477-vrms/vrm-website/Files/img/wen101/week12/build-fail.jpg

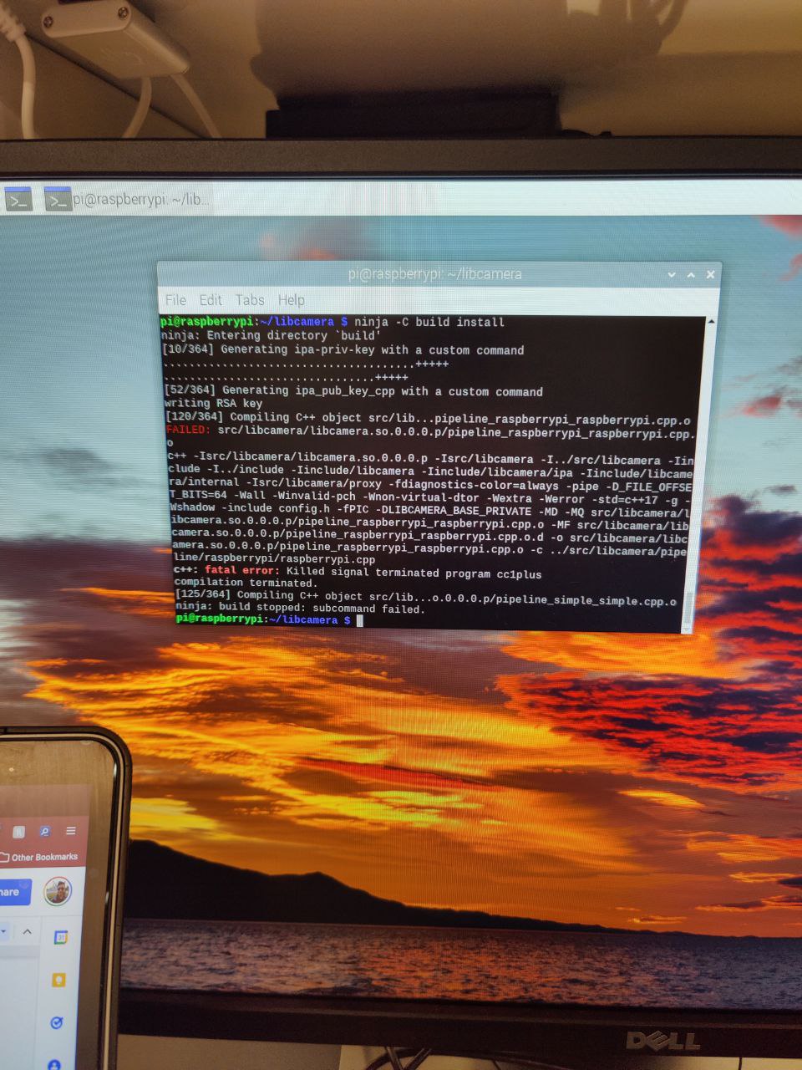
Files/img/wen101/week12/build-fail.jpg
