477-vrms/vrm-website/Files/img/progress1/week2/lazysusaninstall.jpg

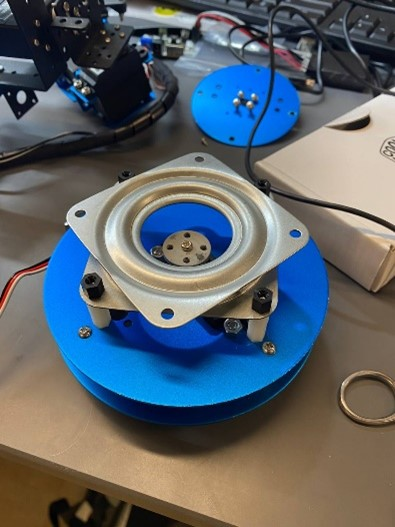
Files/img/progress1/week2/lazysusaninstall.jpg
