477-vrms/vrm-website/Files/img/blatimer/week3/ClawAnimation.gif

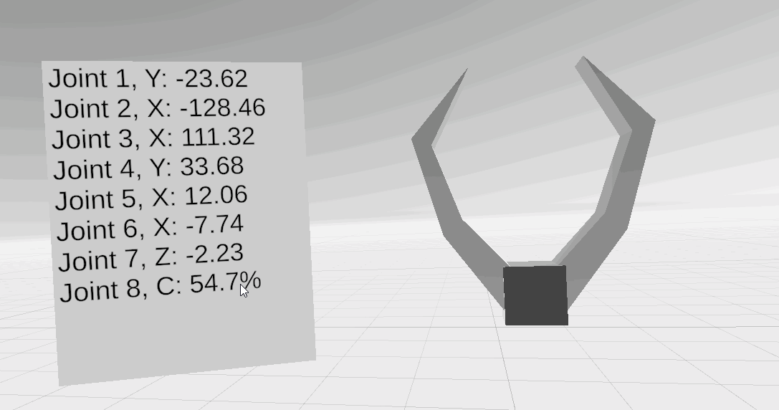
Files/img/blatimer/week3/ClawAnimation.gif
