477-vrms/vrm-website/Files/img/blatimer/week4/Demo.png

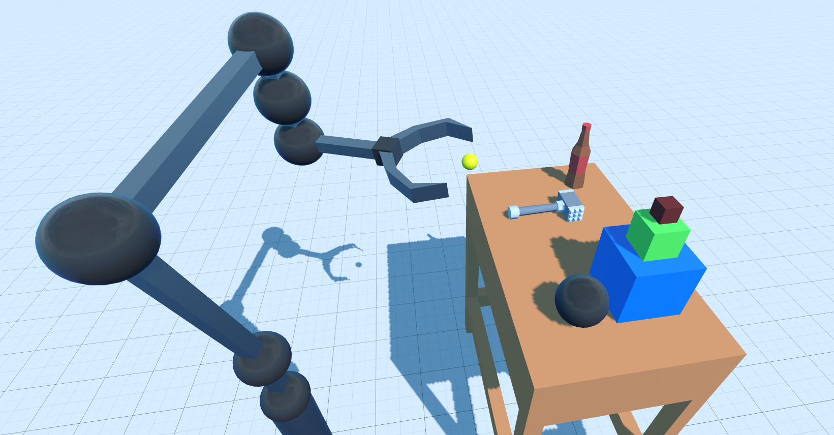
Files/img/blatimer/week4/Demo.png
