477-vrms/vrm-website/Files/img/blatimer/week5/no4thjoint.jpg

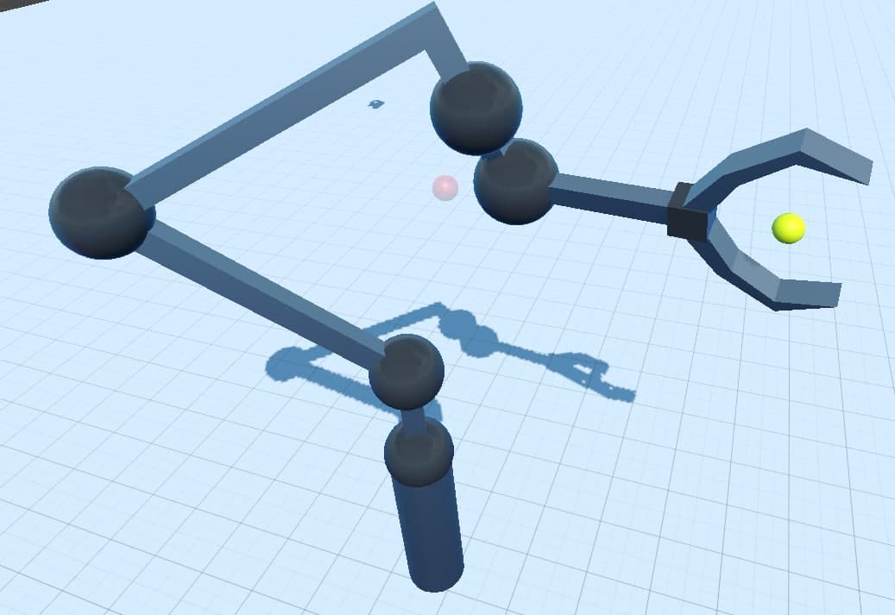
Files/img/blatimer/week5/no4thjoint.jpg
