477-vrms/vrm-website/Files/img/blatimer/week6/auto.gif

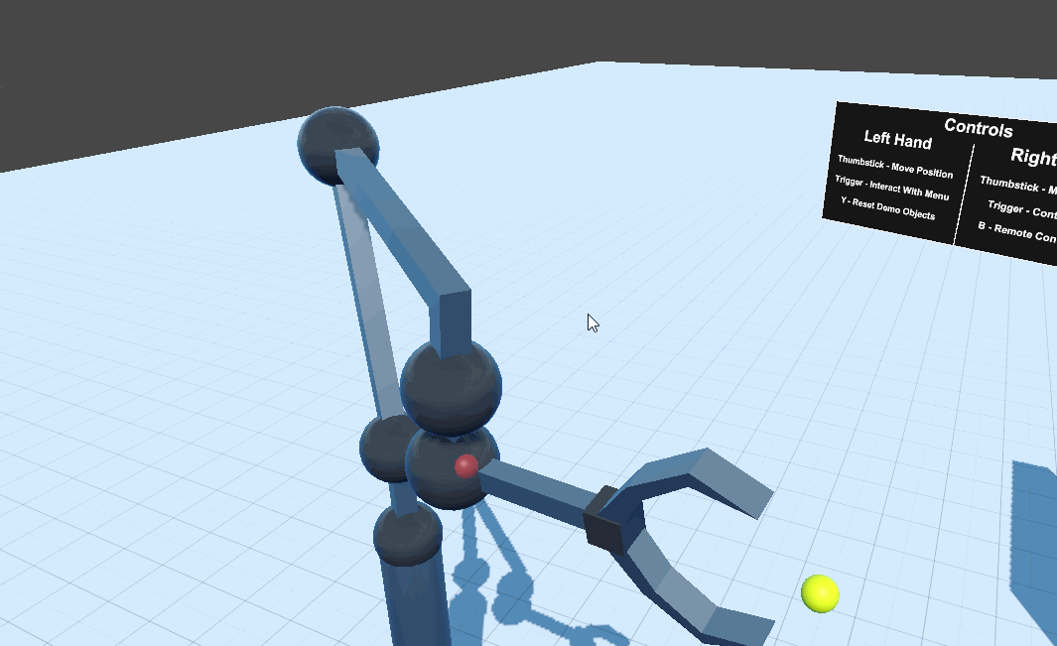
Files/img/blatimer/week6/auto.gif
