477-vrms/vrm-website/Files/img/blatimer/week6/menu.png

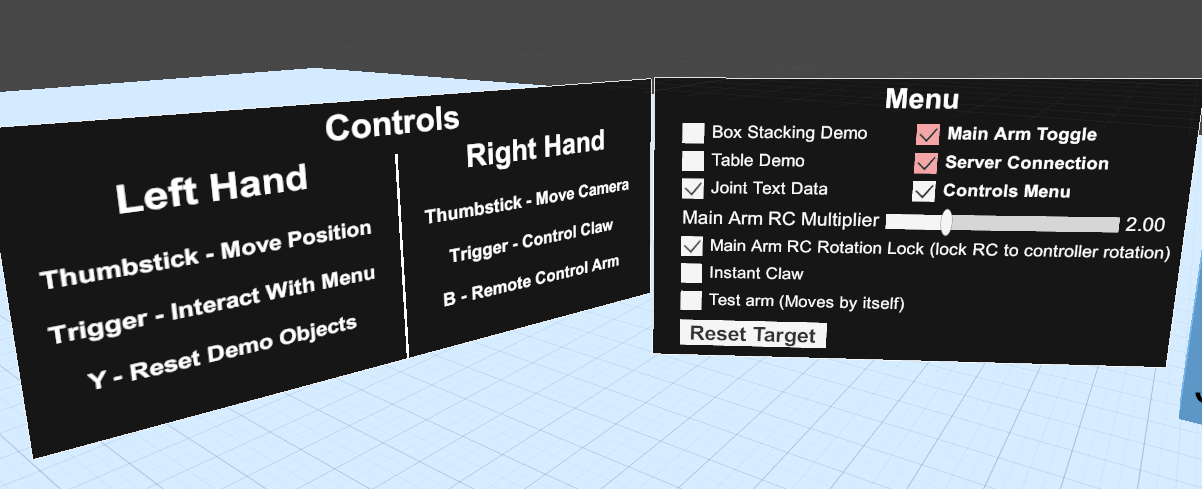
Files/img/blatimer/week6/menu.png
