477-vrms/vrm-website/Files/img/blatimer/week6/Vrm.png

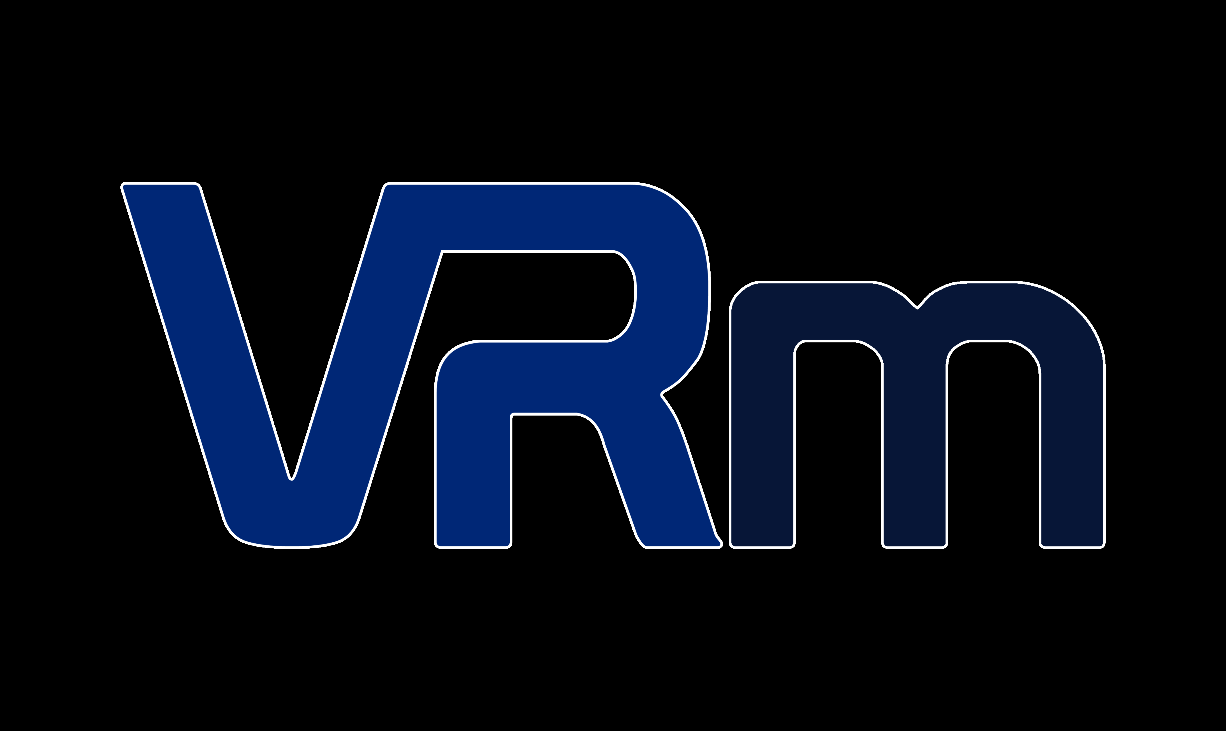
Files/img/blatimer/week6/Vrm.png
