477-vrms/vrm-website/Files/img/blatimer/week7/LimitMenu.png

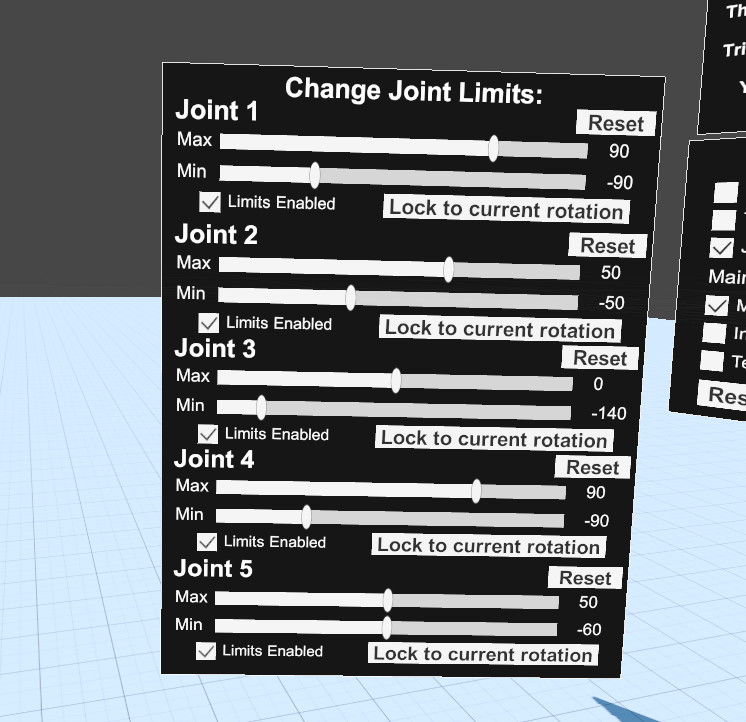
Files/img/blatimer/week7/LimitMenu.png
