477-vrms/vrm-website/Files/img/blatimer/week11/calib.jpg

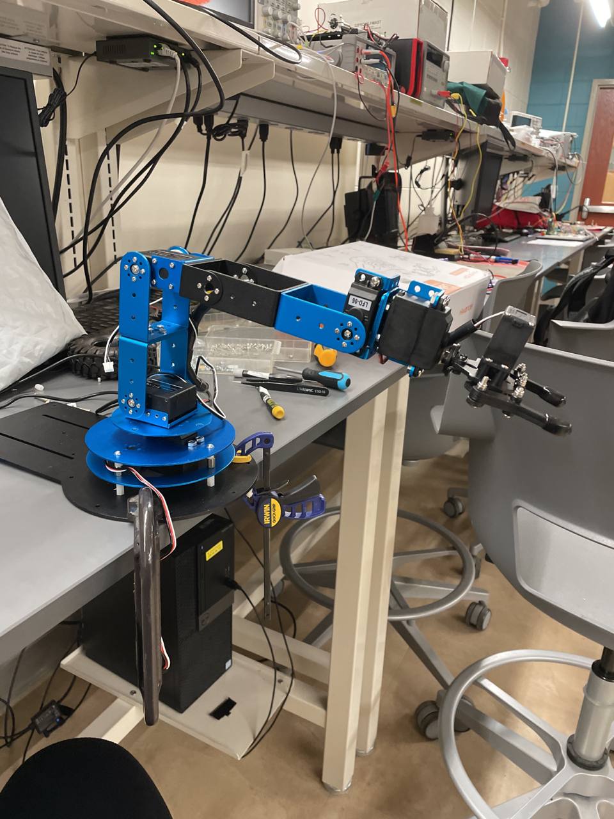
Files/img/blatimer/week11/calib.jpg
