477-vrms/vrm-website/Files/img/blatimer/week11/diagram.jpg

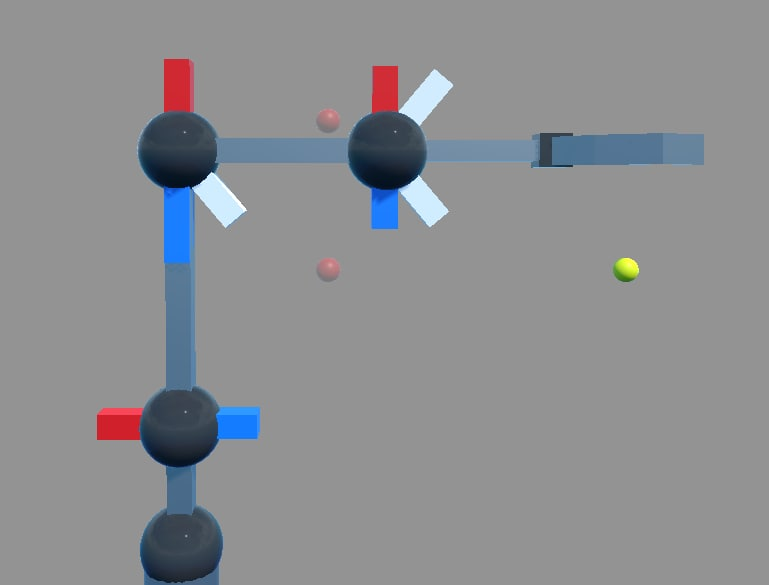
Files/img/blatimer/week11/diagram.jpg
