477-vrms/vrm-website/Files/img/blatimer/week12/bearing.png

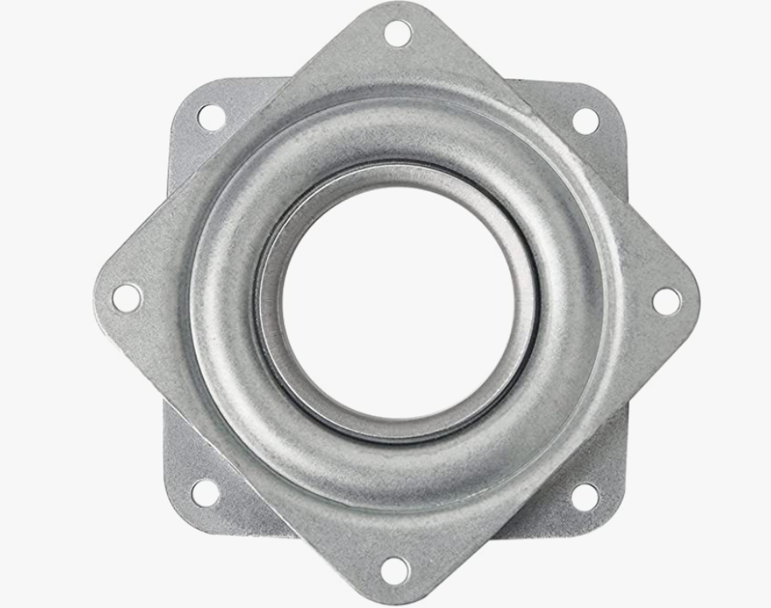
Files/img/blatimer/week12/bearing.png
