477-vrms/vrm-website/Files/img/blatimer/week13/delay.png

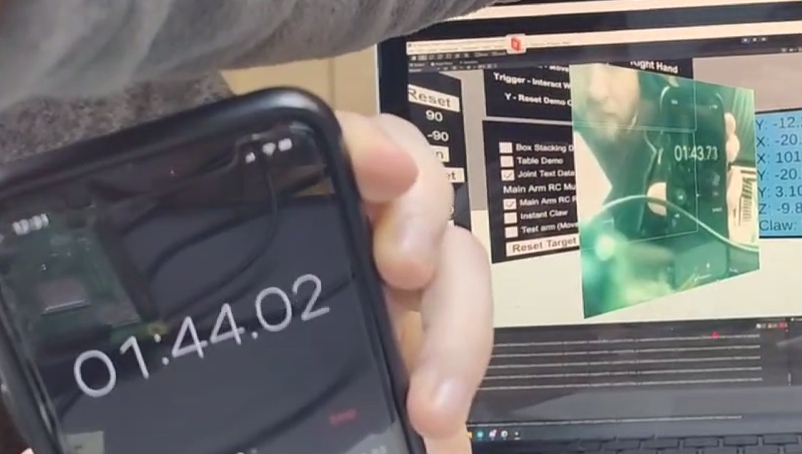
Files/img/blatimer/week13/delay.png
