477-vrms/vrm-website/Files/img/blatimer/week14/NewDimensions.png

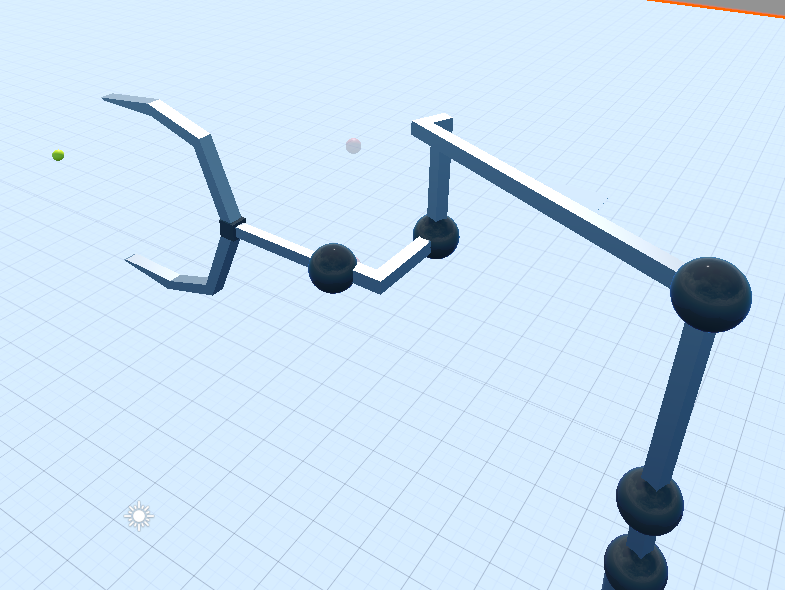
Files/img/blatimer/week14/NewDimensions.png
