477-vrms/vrm-website/Files/img/blatimer/week14/neww.png

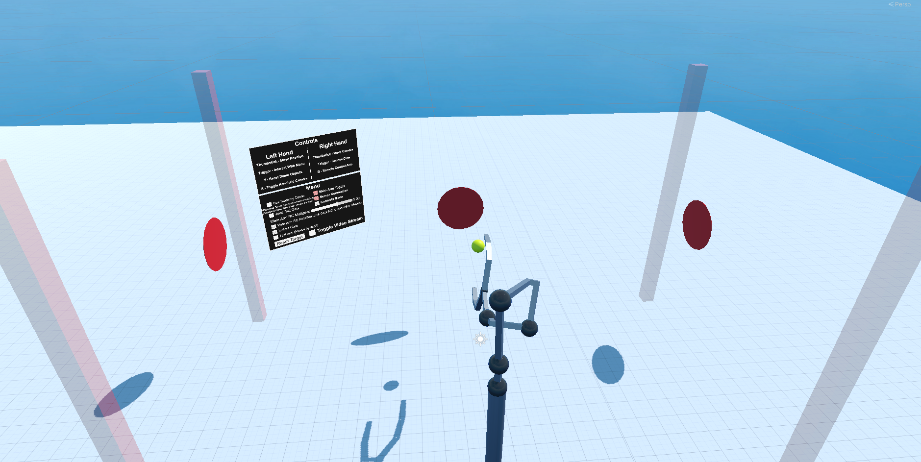
Files/img/blatimer/week14/neww.png
