477-vrms/vrm-website/Files/img/donnell9/week2/SystemDiagram1.png

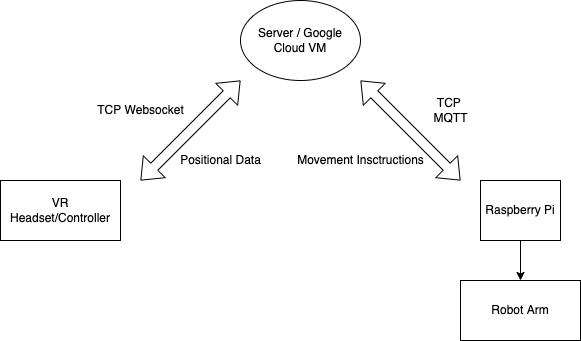
Files/img/donnell9/week2/SystemDiagram1.png
