477-vrms/vrm-website/Files/img/donnell9/week5/pcb.png

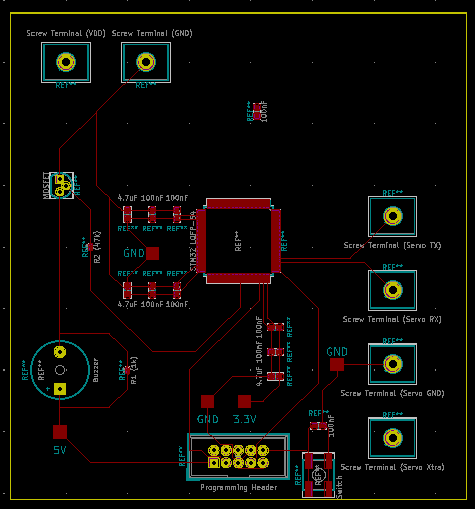
Files/img/donnell9/week5/pcb.png
