477-vrms/vrm-website/Files/img/donnell9/week6/pcb.png

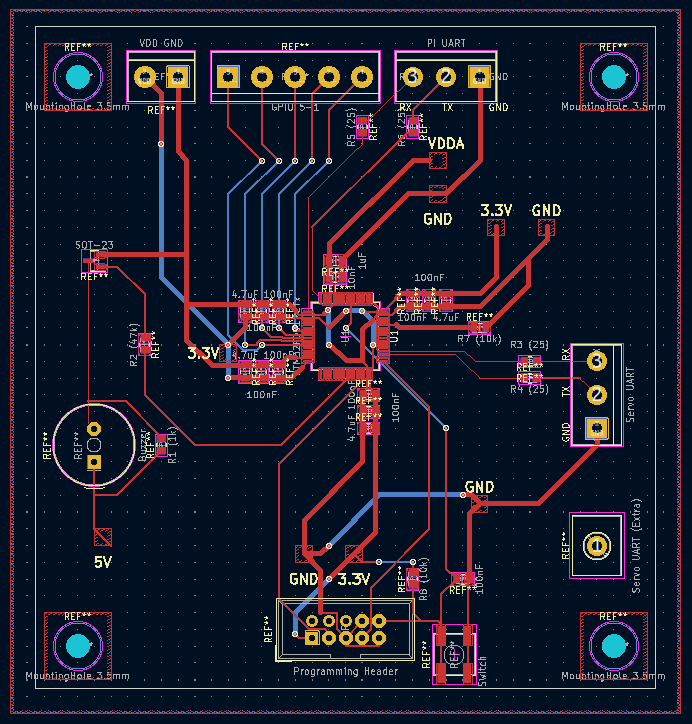
Files/img/donnell9/week6/pcb.png
