477-vrms/vrm-website/Files/img/donnell9/week8/Olivia.jpg

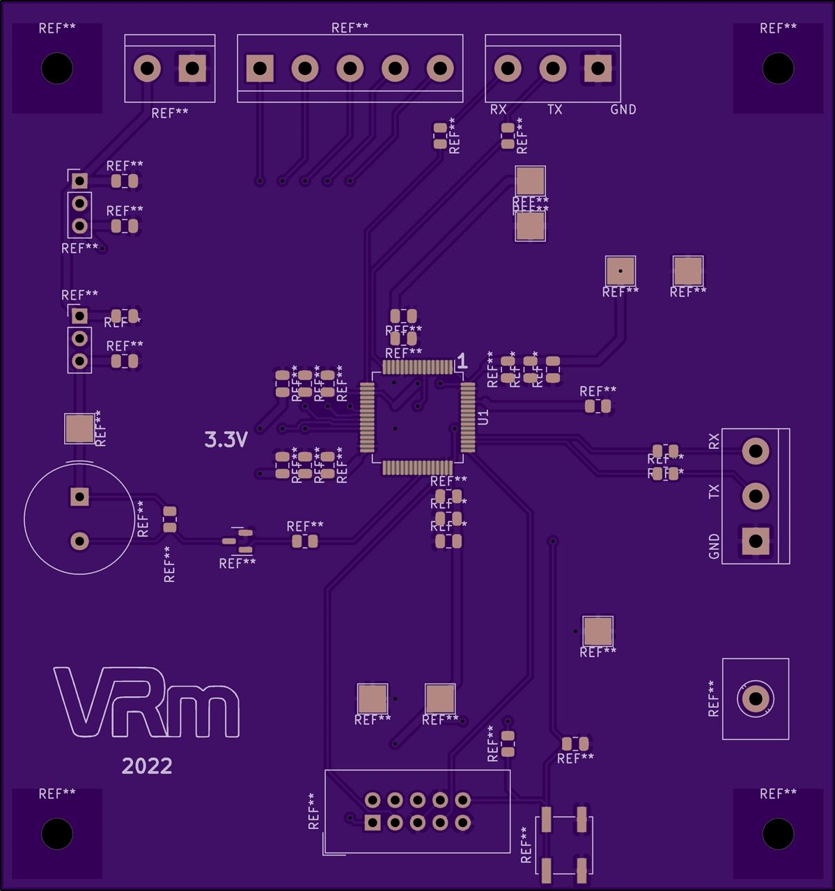
Files/img/donnell9/week8/Olivia.jpg
