477-vrms/vrm-website/Files/img/progress1/week2/arduino2.jpg

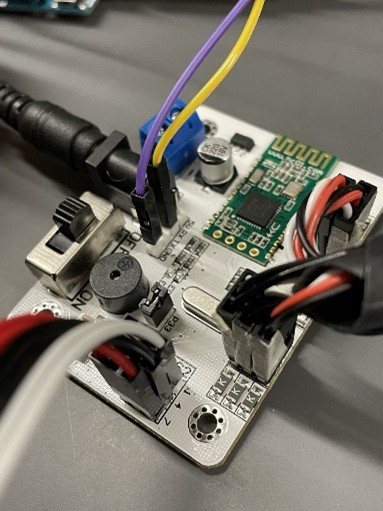
Files/img/progress1/week2/arduino2.jpg
