477-vrms/vrm-website/Files/img/progress1/week2/arudion1.jpg

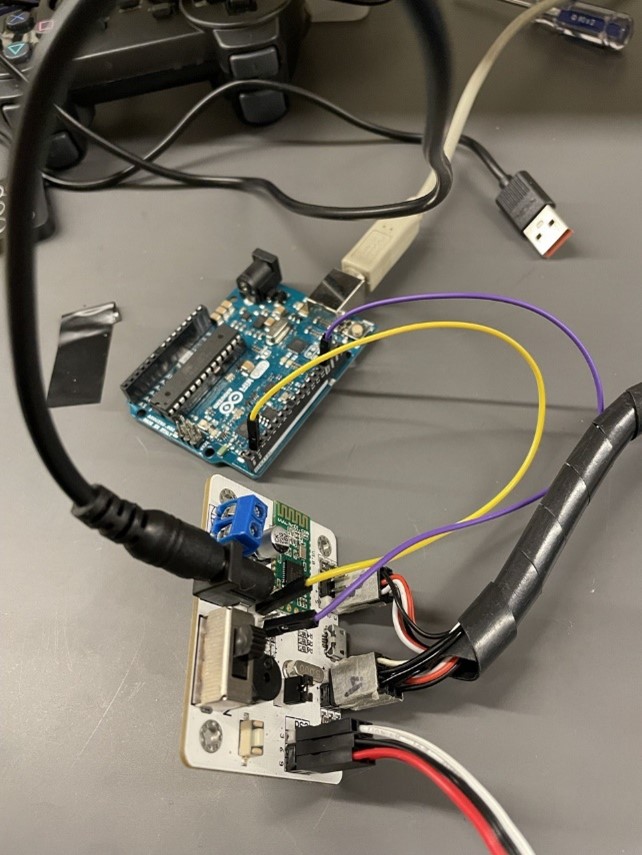
Files/img/progress1/week2/arudion1.jpg
