477-vrms/vrm-website/Files/img/progress1/week2/ballbearing.png

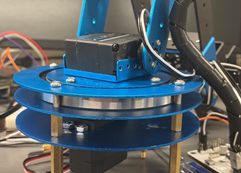
Files/img/progress1/week2/ballbearing.png
