477-vrms/vrm-website/Files/img/progress1/week2/bufferpic.png

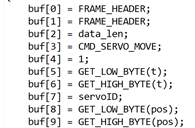
Files/img/progress1/week2/bufferpic.png
