477-vrms/vrm-website/Files/img/progress1/week2/buzz.png

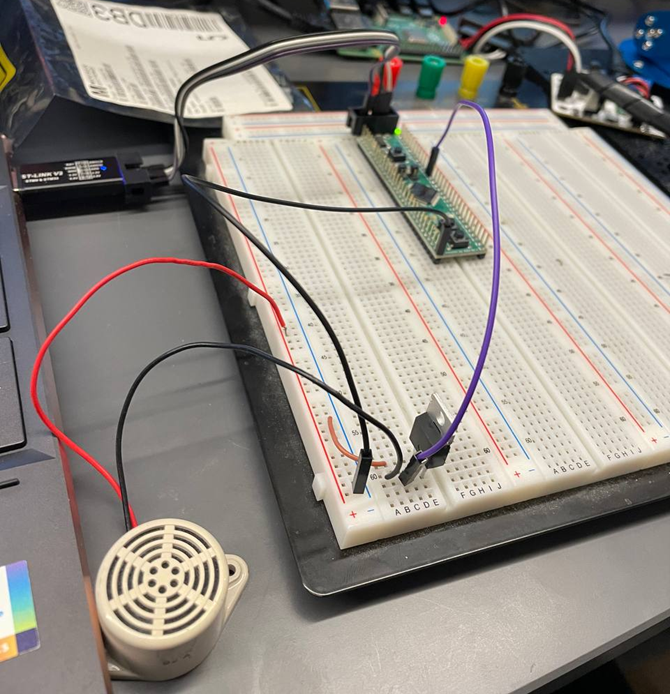
Files/img/progress1/week2/buzz.png
