477-vrms/vrm-website/Files/img/progress1/week2/buzzcircuit.jpg

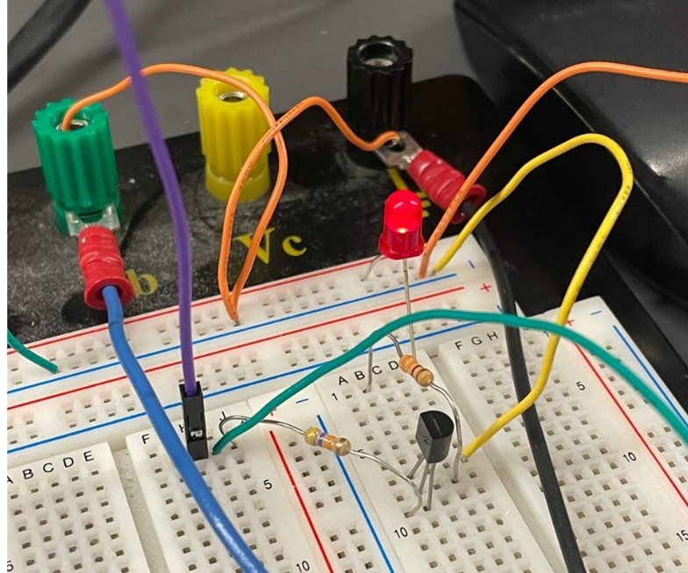
Files/img/progress1/week2/buzzcircuit.jpg
