477-vrms/vrm-website/Files/img/progress1/week2/buzzpower.jpg

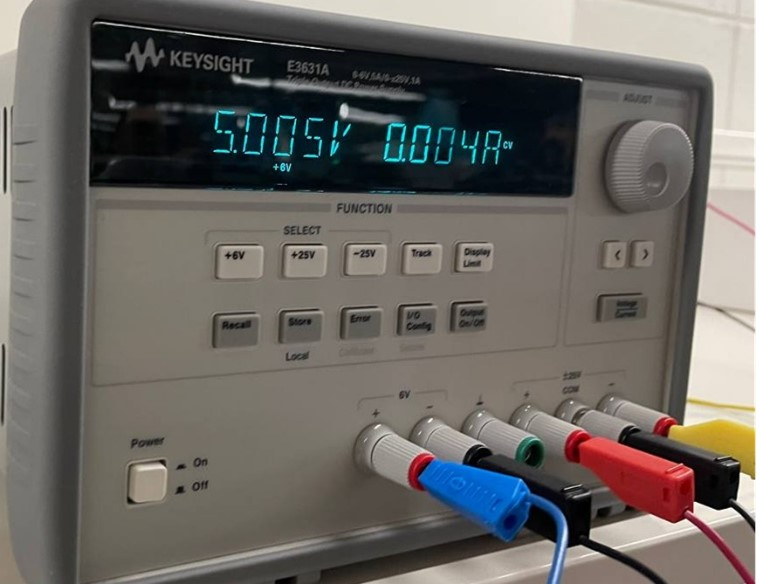
Files/img/progress1/week2/buzzpower.jpg
