477-vrms/vrm-website/Files/img/progress1/week2/camerajpg.jpg

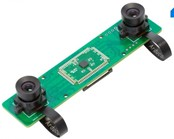
Files/img/progress1/week2/camerajpg.jpg
