477-vrms/vrm-website/Files/img/progress1/week2/circuitdiagram.png

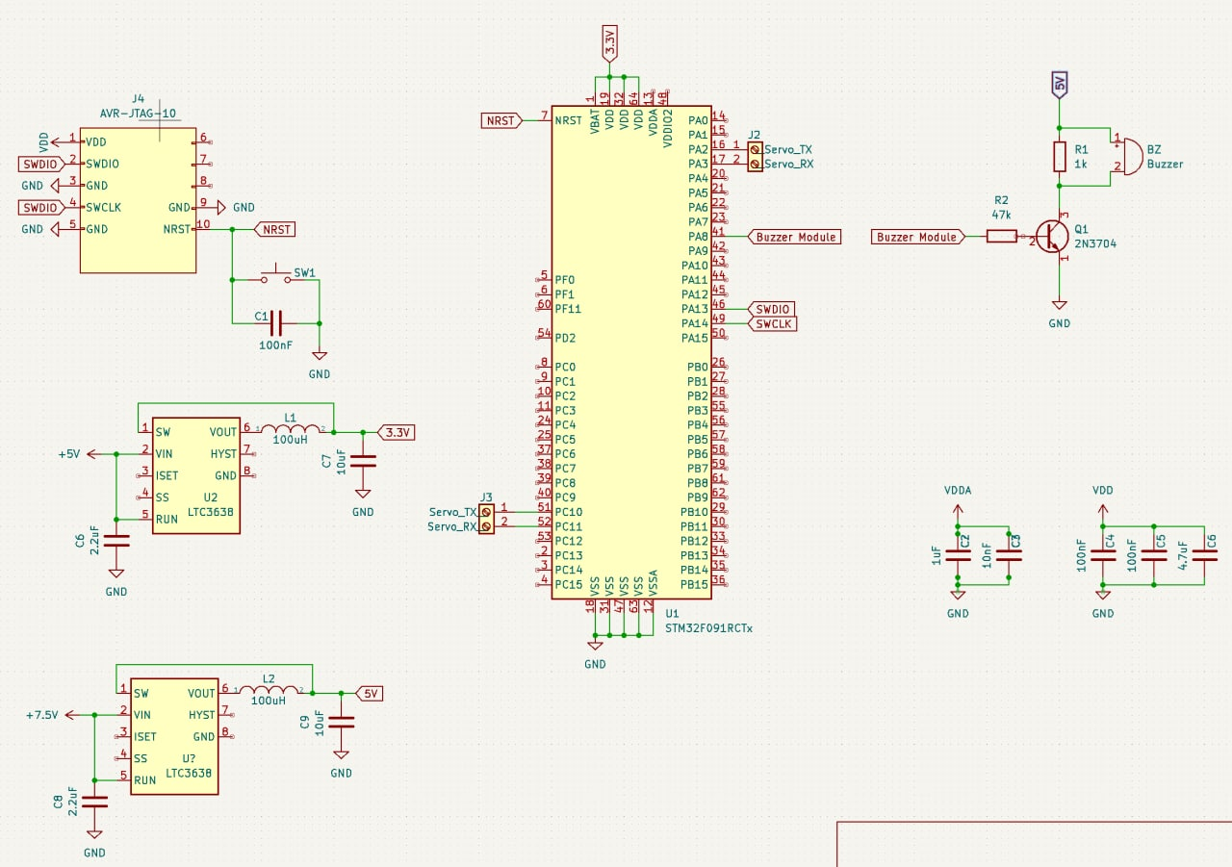
Files/img/progress1/week2/circuitdiagram.png
