477-vrms/vrm-website/Files/img/progress1/week2/diagrampng.png

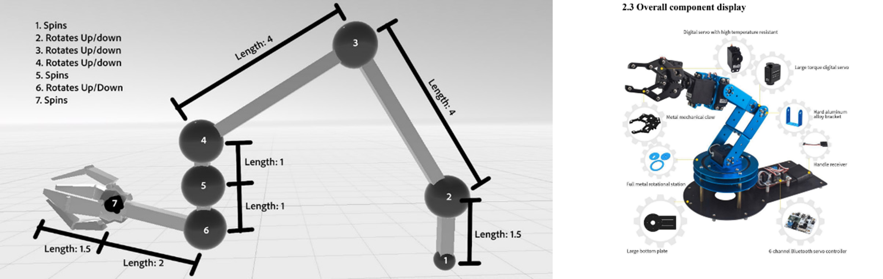
Files/img/progress1/week2/diagrampng.png
