477-vrms/vrm-website/Files/img/progress1/week2/driverpng.png

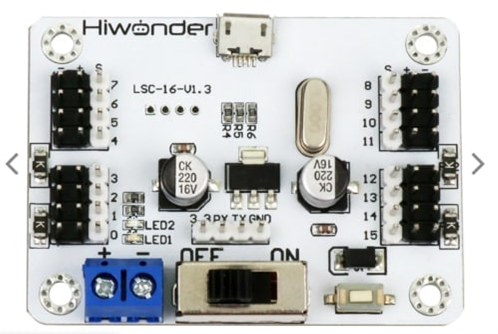
Files/img/progress1/week2/driverpng.png
