477-vrms/vrm-website/Files/img/progress1/week2/lazysusan.png

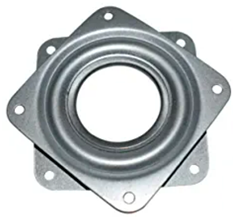
Files/img/progress1/week2/lazysusan.png
