477-vrms/vrm-website/Files/img/progress1/week2/microdatajpg.jpg

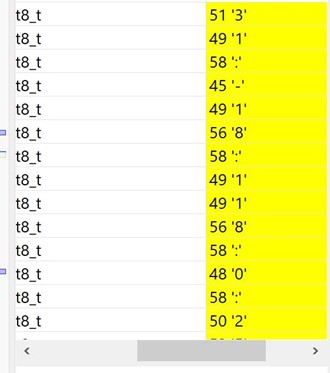
Files/img/progress1/week2/microdatajpg.jpg
