477-vrms/vrm-website/Files/img/progress1/week2/newrealarm.jpg

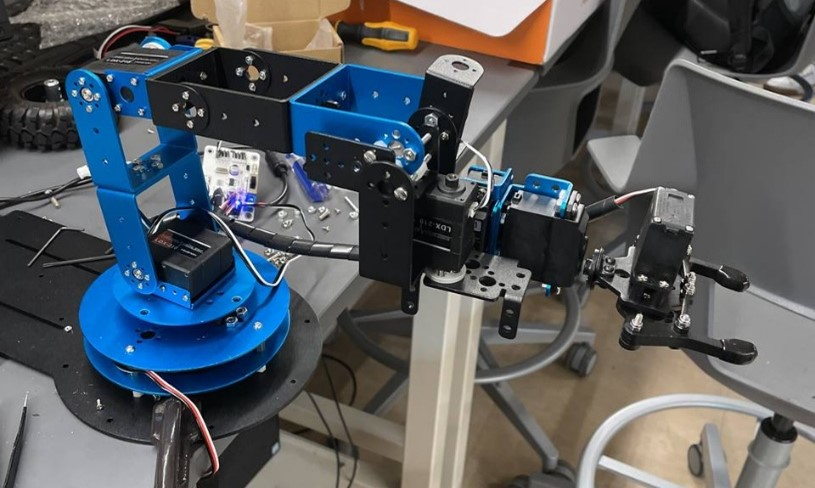
Files/img/progress1/week2/newrealarm.jpg
