477-vrms/vrm-website/Files/img/progress1/week2/newsimarm.jpg

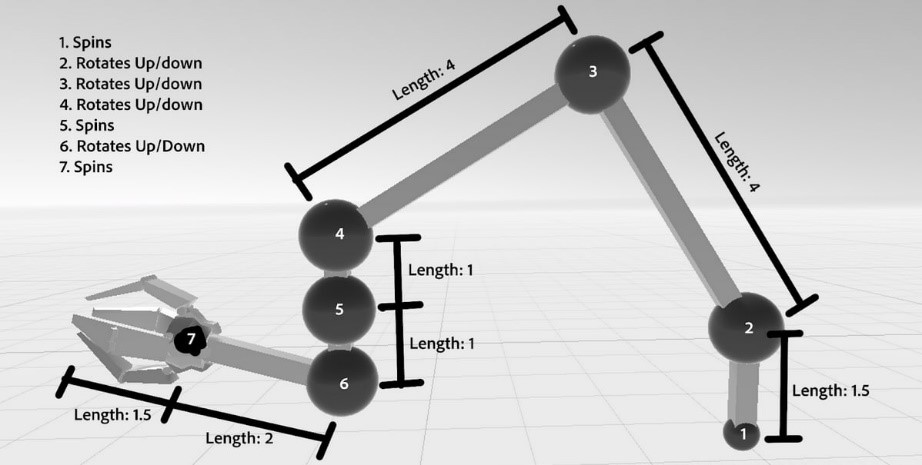
Files/img/progress1/week2/newsimarm.jpg
