477-vrms/vrm-website/Files/img/progress1/week2/newwire.png

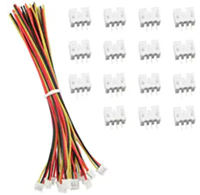
Files/img/progress1/week2/newwire.png
