477-vrms/vrm-website/Files/img/progress1/week2/pic2.jpg

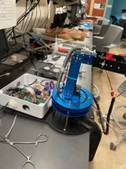
Files/img/progress1/week2/pic2.jpg
