477-vrms/vrm-website/Files/img/progress1/week2/Picture5.jpg

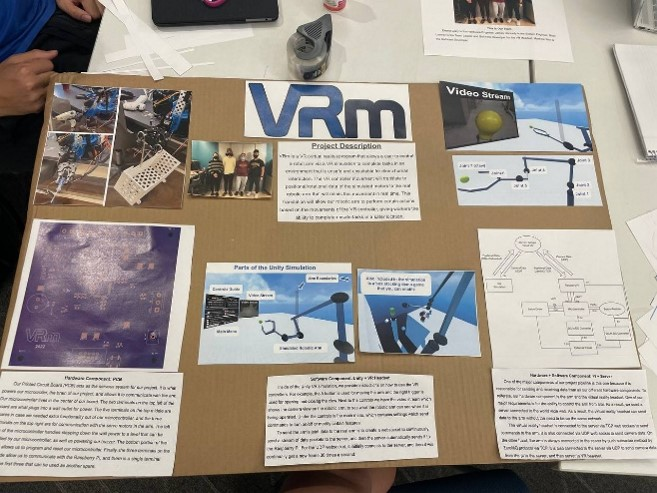
Files/img/progress1/week2/Picture5.jpg
