477-vrms/vrm-website/Files/img/progress1/week2/Picture6.jpg

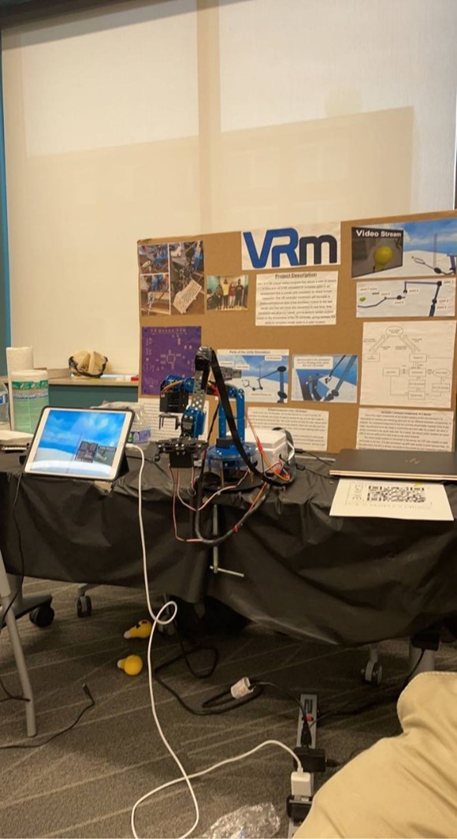
Files/img/progress1/week2/Picture6.jpg
