477-vrms/vrm-website/Files/img/progress1/week2/Picture22.jpg

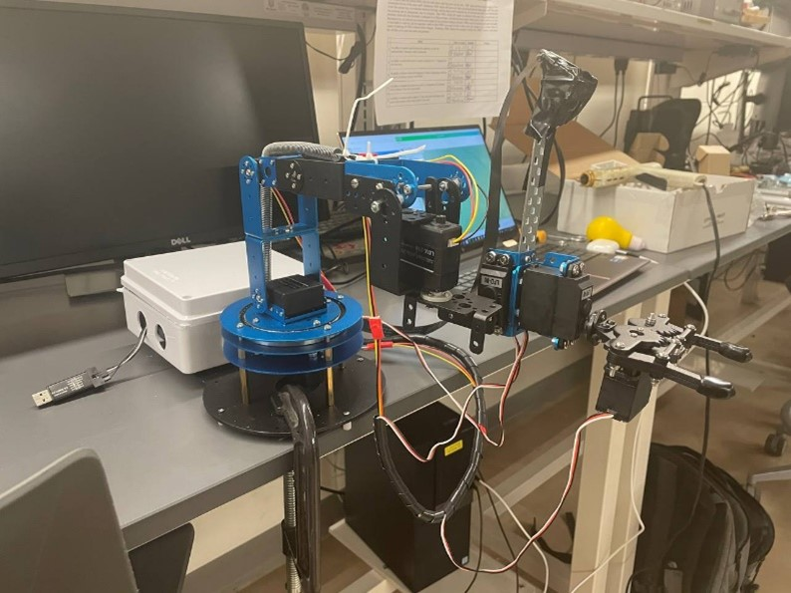
Files/img/progress1/week2/Picture22.jpg
