477-vrms/vrm-website/Files/img/progress1/week2/pwmpng.png

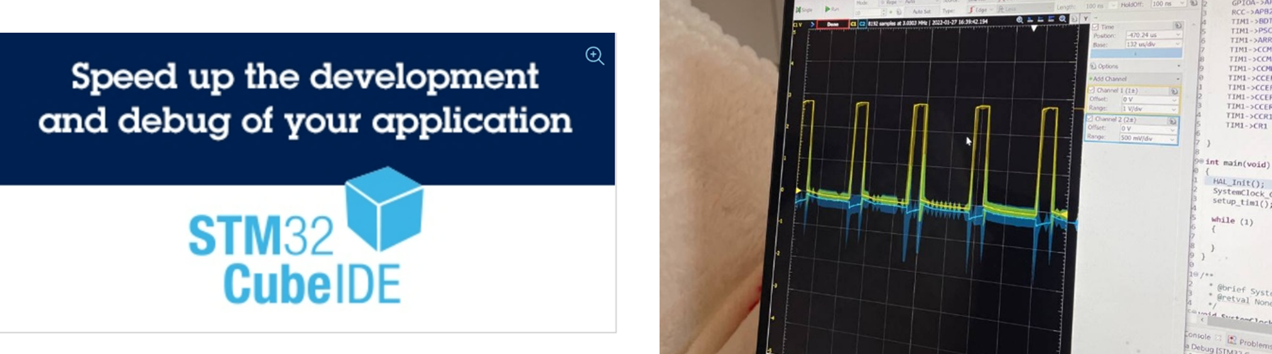
Files/img/progress1/week2/pwmpng.png
