477-vrms/vrm-website/Files/img/progress1/week2/realarm.png

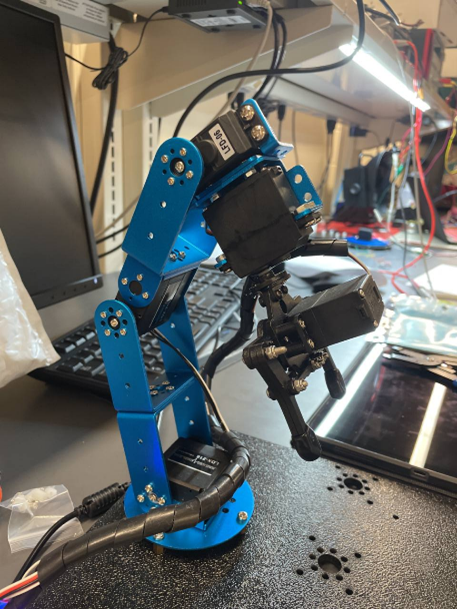
Files/img/progress1/week2/realarm.png
