477-vrms/vrm-website/Files/img/progress1/week2/RobotScrewdriver.png

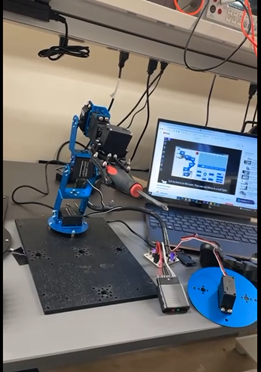
Files/img/progress1/week2/RobotScrewdriver.png
