477-vrms/vrm-website/Files/img/progress1/week2/rpi3data.png

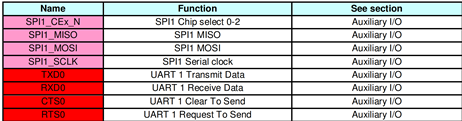
Files/img/progress1/week2/rpi3data.png
