477-vrms/vrm-website/Files/img/progress1/week2/rpi4data.png

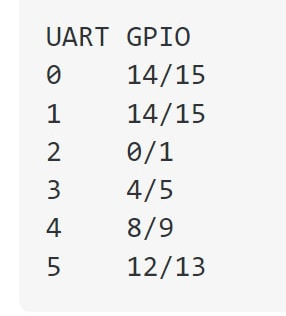
Files/img/progress1/week2/rpi4data.png
