477-vrms/vrm-website/Files/img/progress1/week2/schem.png

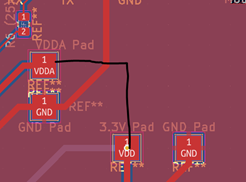
Files/img/progress1/week2/schem.png
