477-vrms/vrm-website/Files/img/progress1/week2/Servopng.jpg

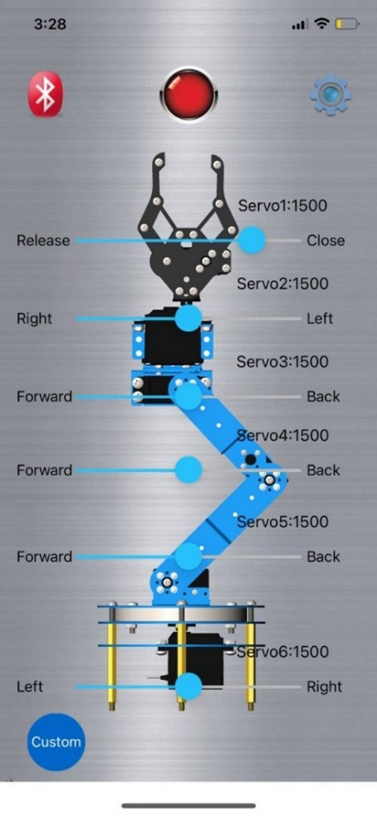
Files/img/progress1/week2/Servopng.jpg
