477-vrms/vrm-website/Files/img/progress1/week2/simarm.png

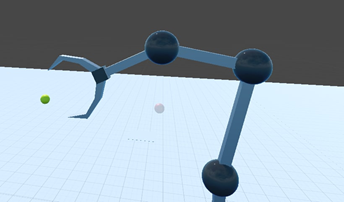
Files/img/progress1/week2/simarm.png
