477-vrms/vrm-website/Files/img/progress1/week2/standjpg.jpg

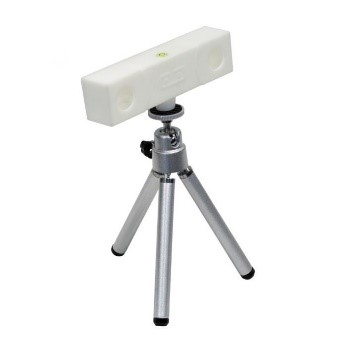
Files/img/progress1/week2/standjpg.jpg
