477-vrms/vrm-website/Files/img/progress1/week2/table2.PNG

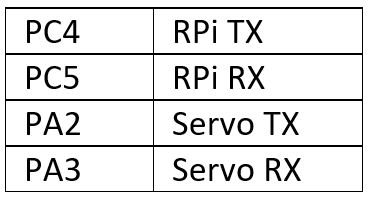
Files/img/progress1/week2/table2.PNG
