477-vrms/vrm-website/Files/img/wen101/week2/firebase.png

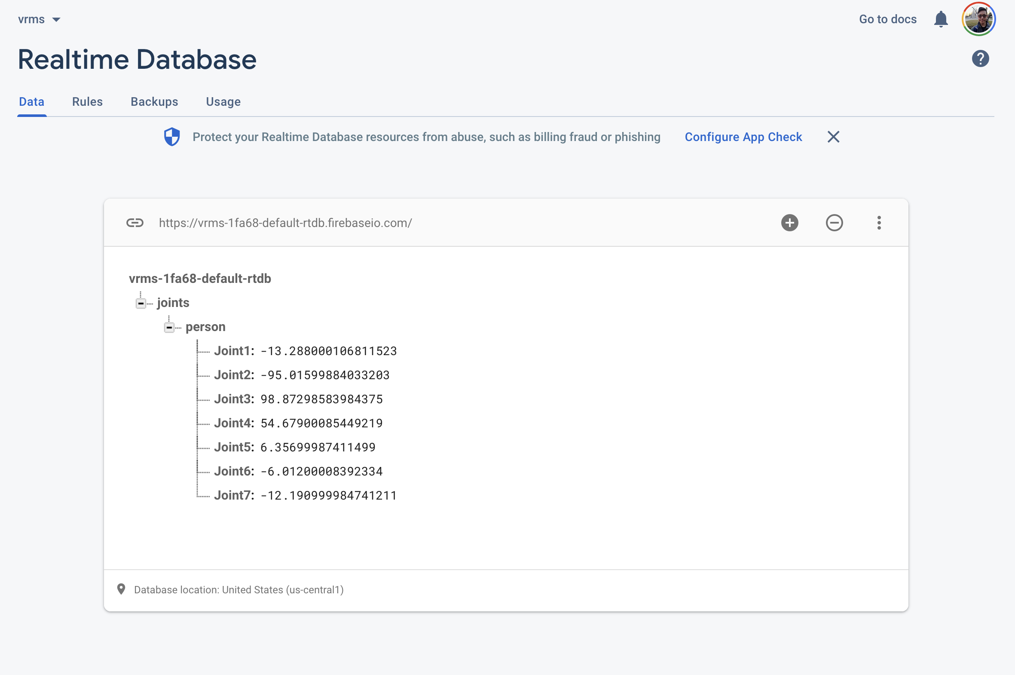
Files/img/wen101/week2/firebase.png
