477-vrms/vrm-website/Files/img/wen101/week2/gateway_demo.png

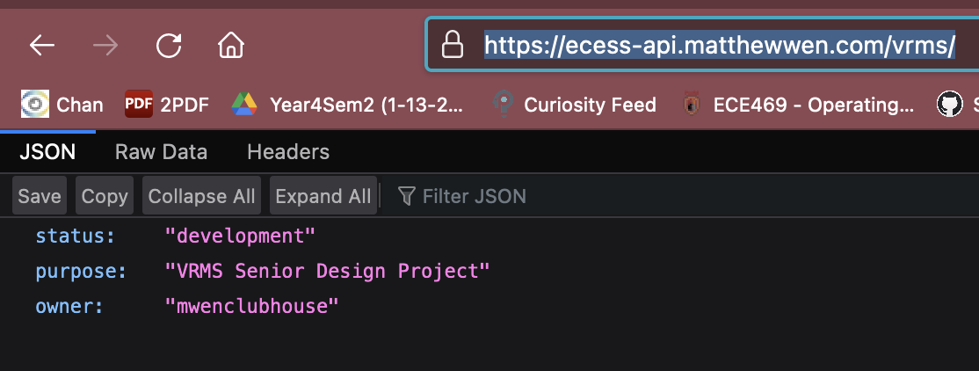
Files/img/wen101/week2/gateway_demo.png
