477-vrms/vrm-website/Files/img/wen101/week2/gh_actions.png

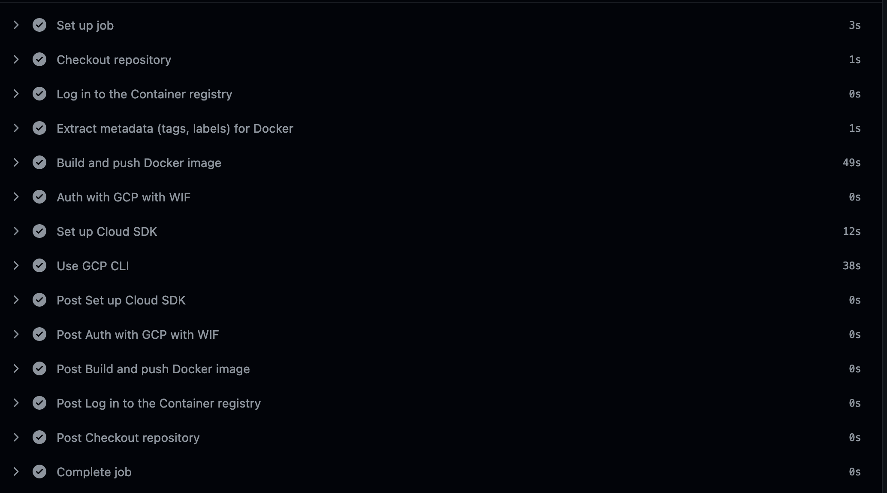
Files/img/wen101/week2/gh_actions.png
