477-vrms/vrm-website/Files/img/wen101/week2/google_wif.png

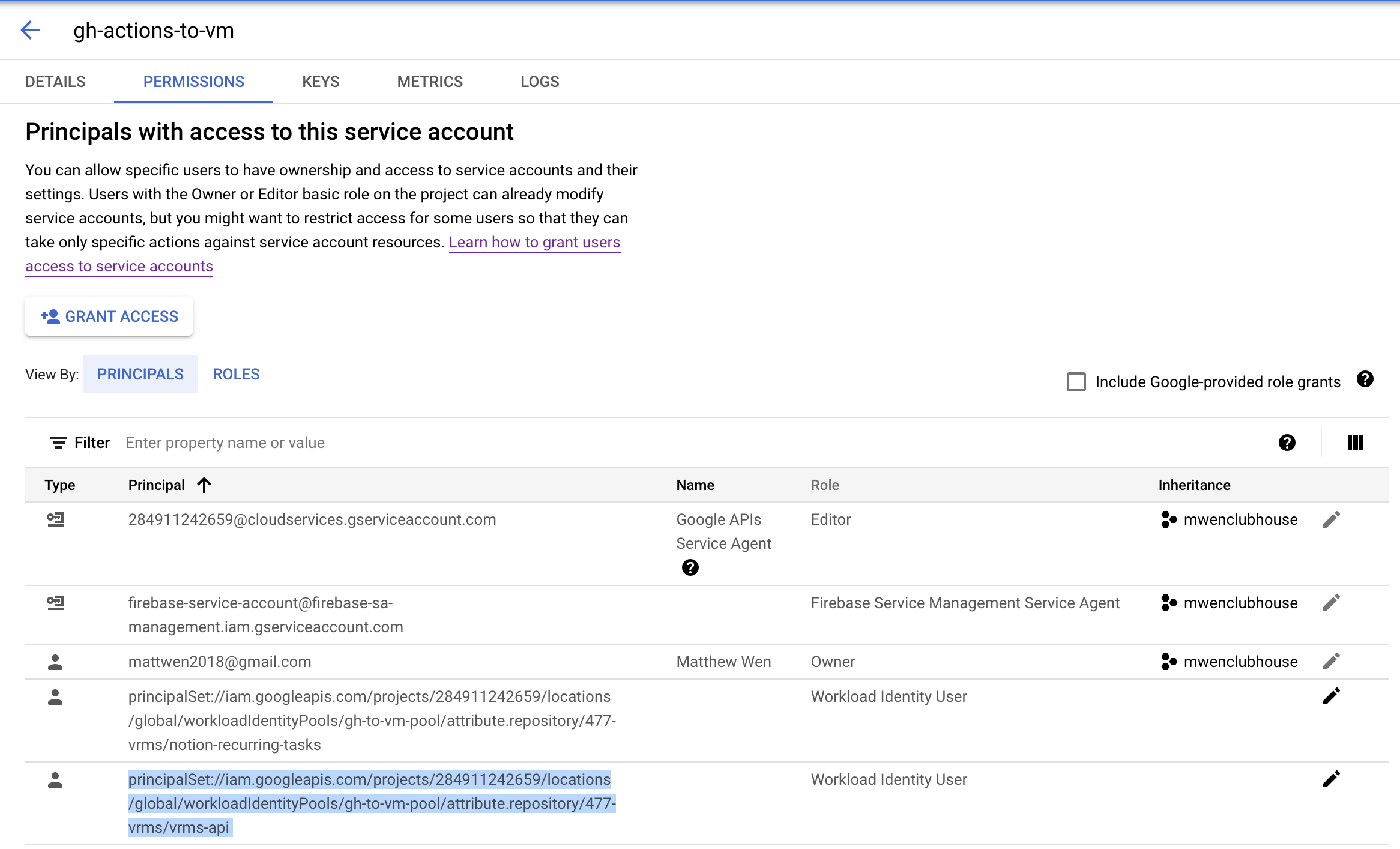
Files/img/wen101/week2/google_wif.png
