477-vrms/vrm-website/Files/img/wen101/week3/gcloud-network-config.jpg

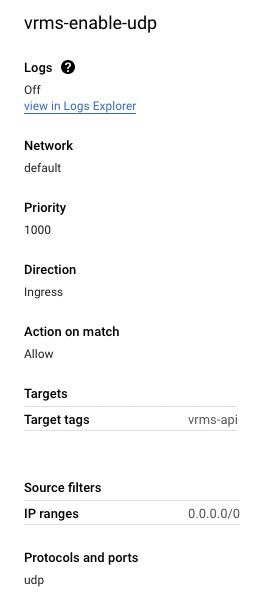
Files/img/wen101/week3/gcloud-network-config.jpg
