477-vrms/vrm-website/Files/img/wen101/week4/pi-status.jpg

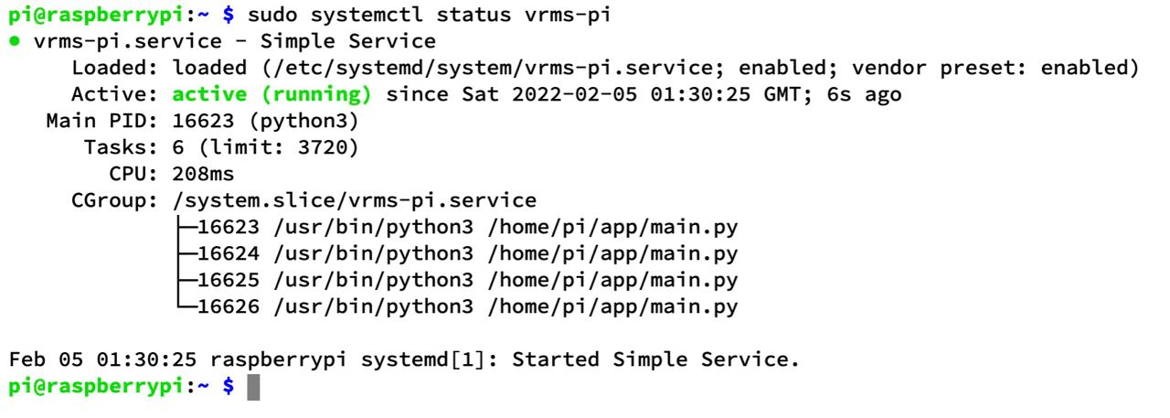
Files/img/wen101/week4/pi-status.jpg
