477-vrms/vrm-website/Files/img/wen101/week5/camera-connected.jpg

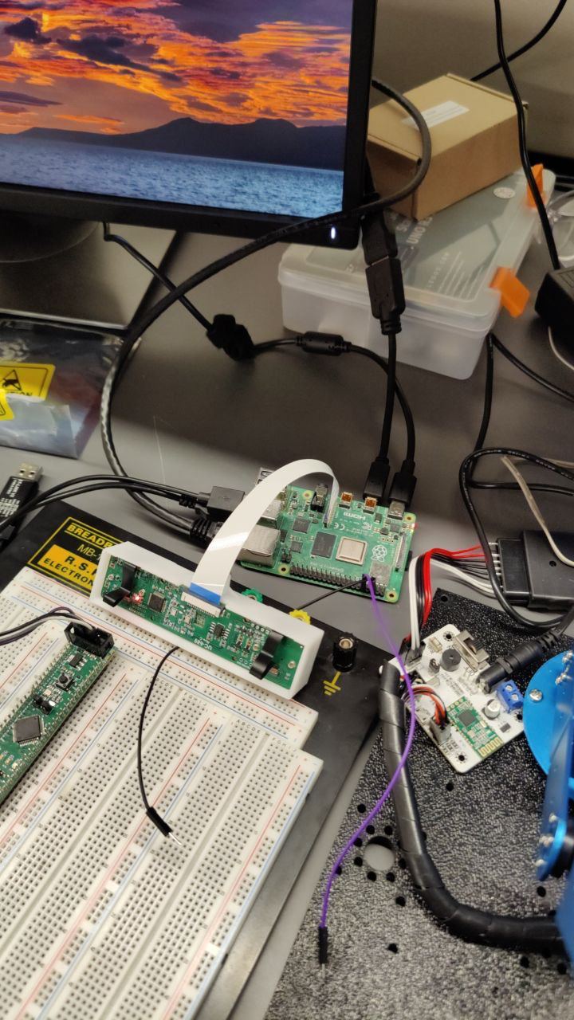
Files/img/wen101/week5/camera-connected.jpg
