477-vrms/vrm-website/Files/img/wen101/week6/recieve-not-working.jpg

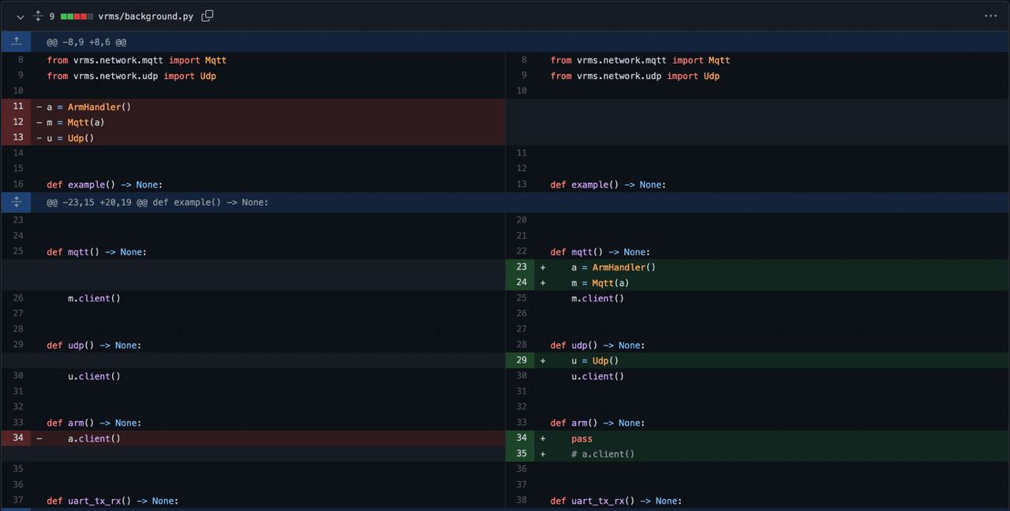
Files/img/wen101/week6/recieve-not-working.jpg
