477-vrms/vrm-website/Files/img/wen101/week7/earth.jpg

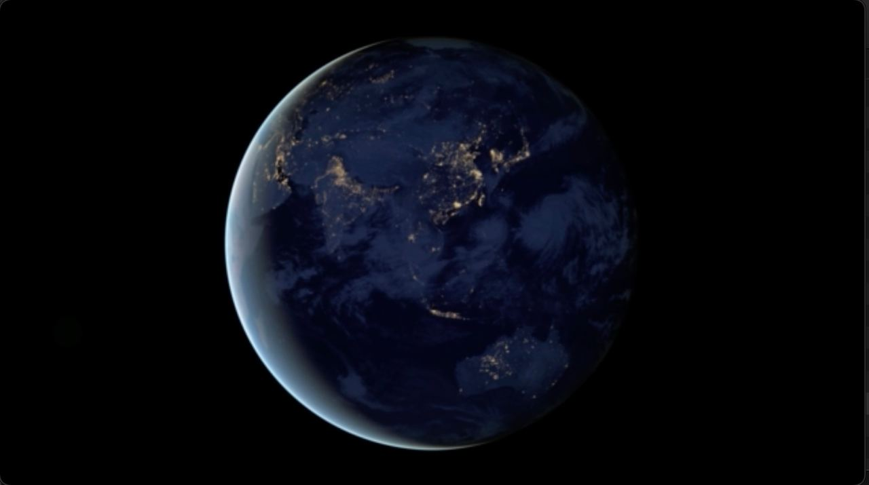
Files/img/wen101/week7/earth.jpg
