477-vrms/vrm-website/Files/img/wen101/week9/docker.jpeg

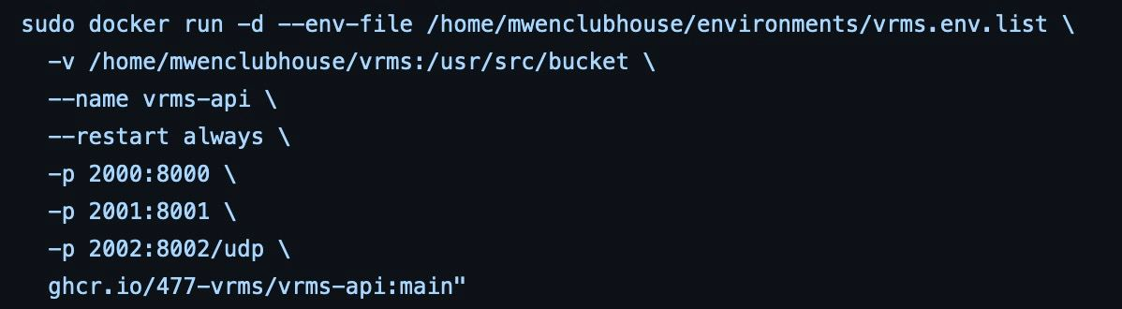
Files/img/wen101/week9/docker.jpeg
