477-vrms/vrm-website/Files/img/wen101/week11/camera_support.jpg

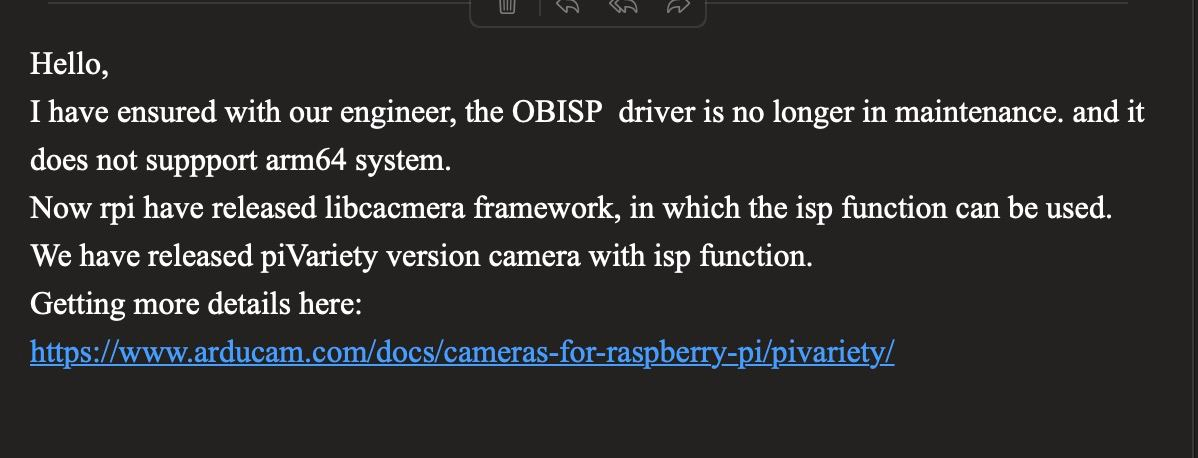
Files/img/wen101/week11/camera_support.jpg
