477-vrms/vrm-website/Files/img/wen101/week11/code.jpg

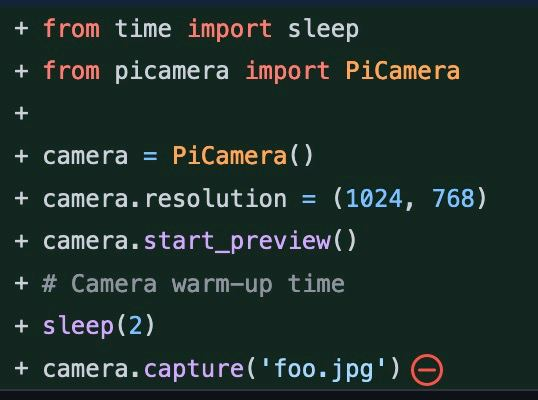
Files/img/wen101/week11/code.jpg
