477-vrms/vrm-website/Files/img/wen101/week12/james-goat.jpg

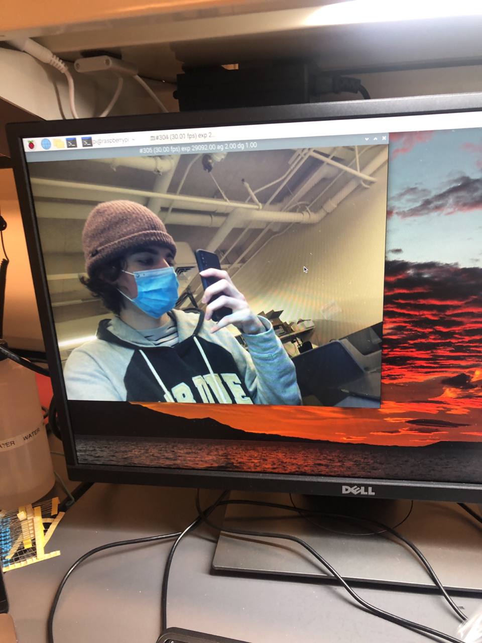
Files/img/wen101/week12/james-goat.jpg
