477-vrms/vrm-website/Files/img/wen101/week12/no-camera.jpg

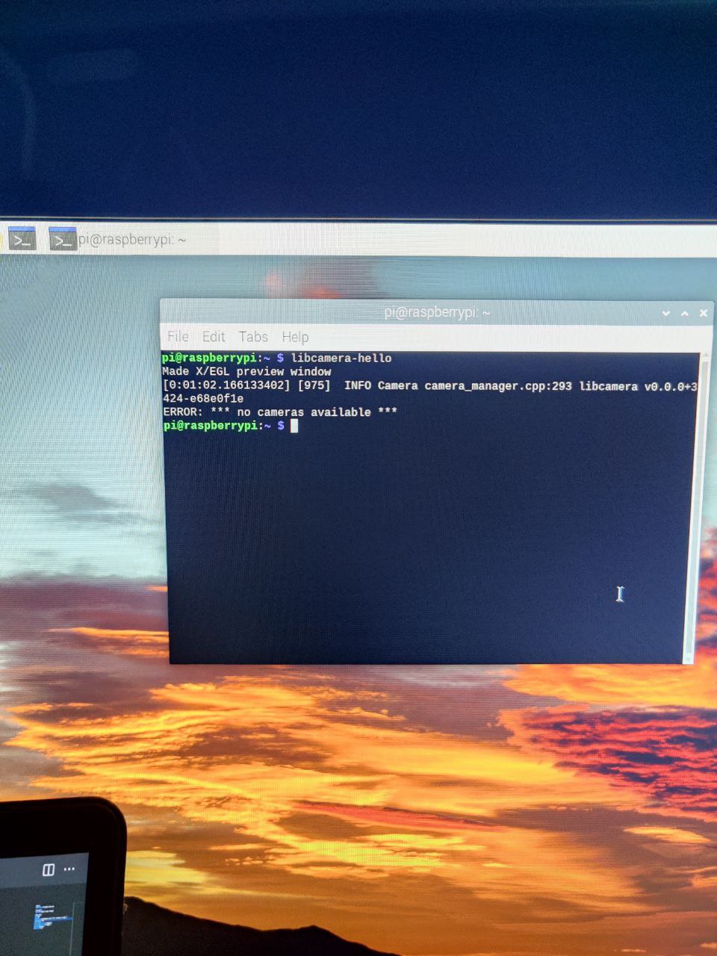
Files/img/wen101/week12/no-camera.jpg
