477-vrms/vrm-website/Files/img/wen101/week13/unity.jpg

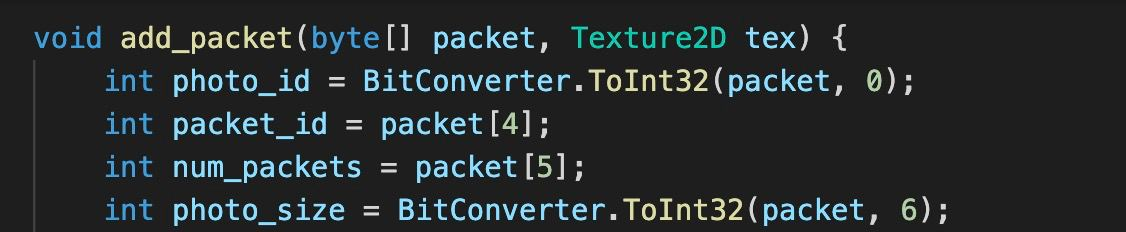
Files/img/wen101/week13/unity.jpg
