477-vrms/vrm-website/Files/img/wen101/week14/gcloud.jpg

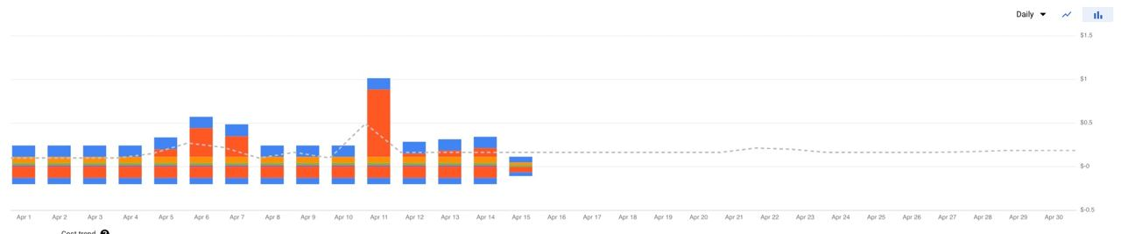
Files/img/wen101/week14/gcloud.jpg
