477-vrms/vrm-website/Files/img/wen101/week15/extension.jpg

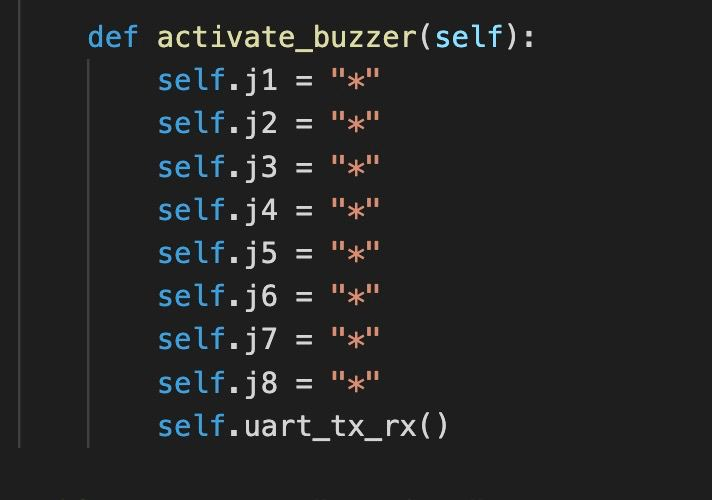
Files/img/wen101/week15/extension.jpg
