477-vrms/vrm-website/Files/img/wen101/week15/improvement.jpg

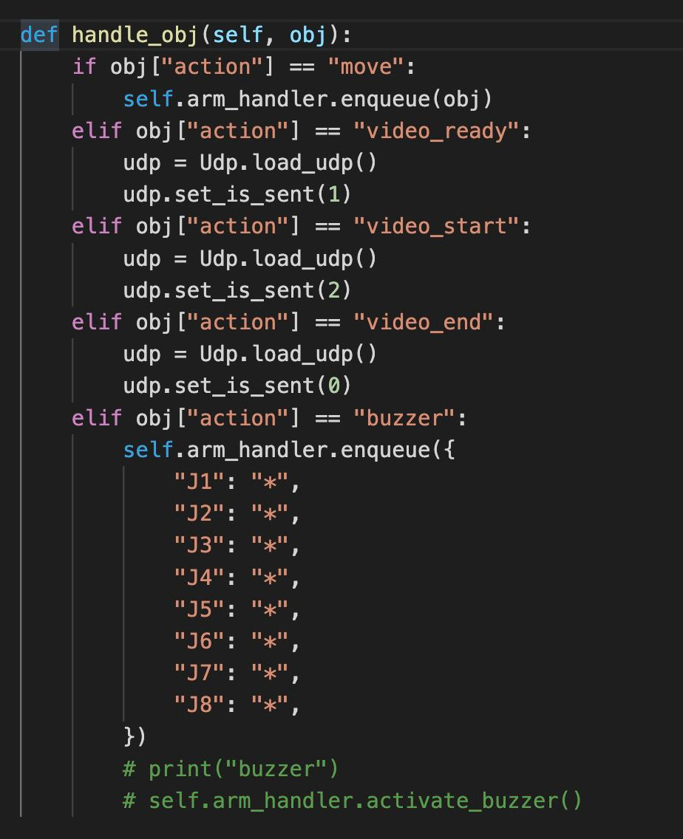
Files/img/wen101/week15/improvement.jpg
