477-vrms/vrm-website/Files/img/wen101/week15/main-thread.jpg

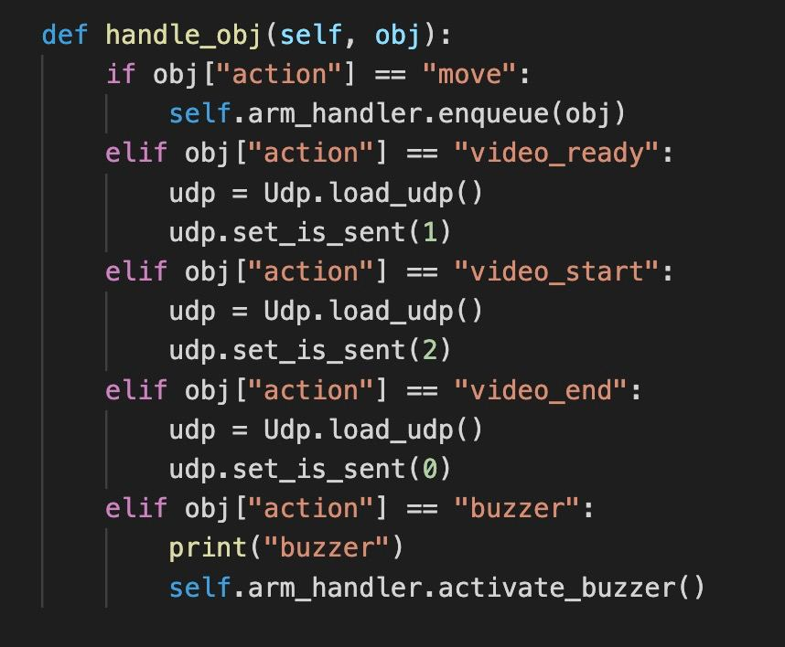
Files/img/wen101/week15/main-thread.jpg
