477-vrms/vrm-website/Files/img/wen101/week16/joint.jpg

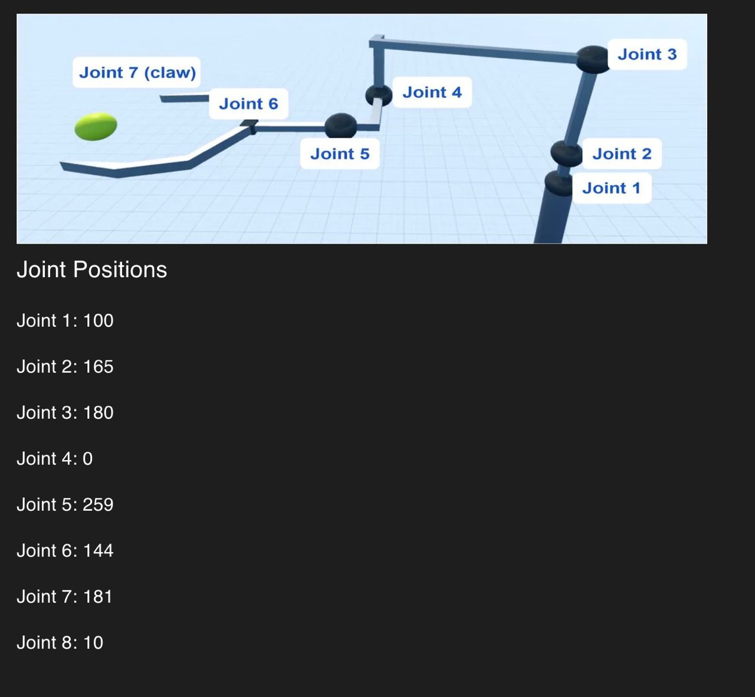
Files/img/wen101/week16/joint.jpg
