477-vrms/vrm-website/Files/img/wen101/week16/pipeline.jpg

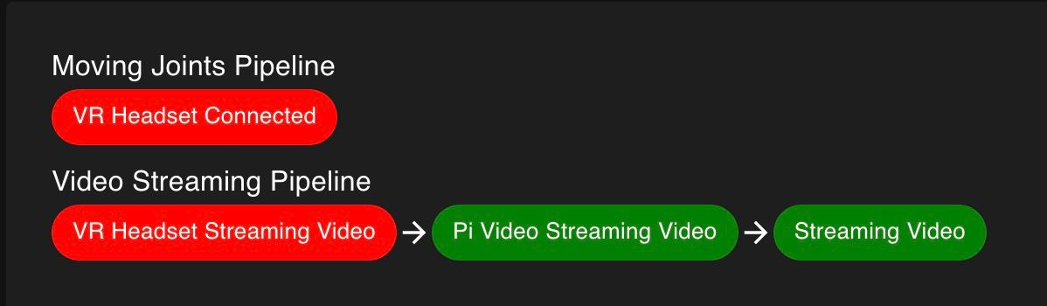
Files/img/wen101/week16/pipeline.jpg
