477-vrms/vrm-website/Files/showcase/jpg/linkedin.jpg

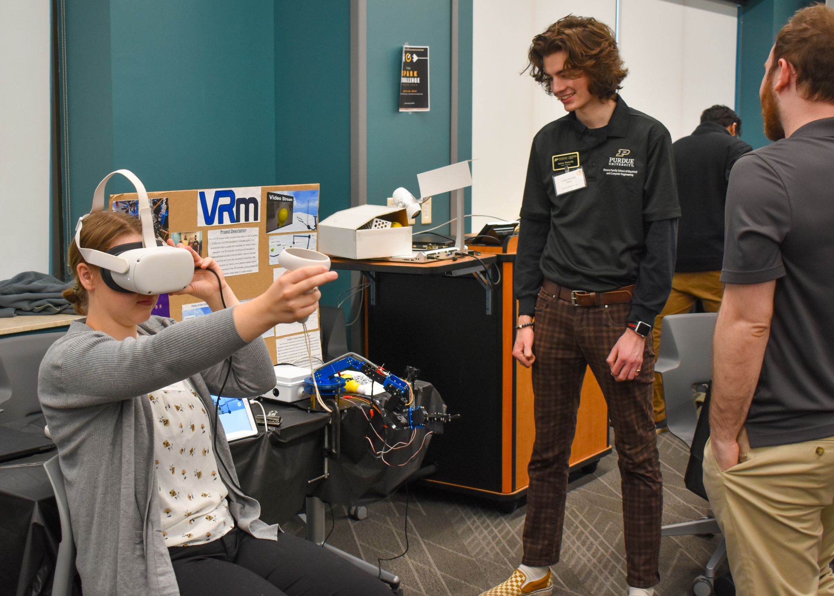
Files/showcase/jpg/linkedin.jpg
