477-vrms/vrm-website/img/slideshow/2ndarm.gif

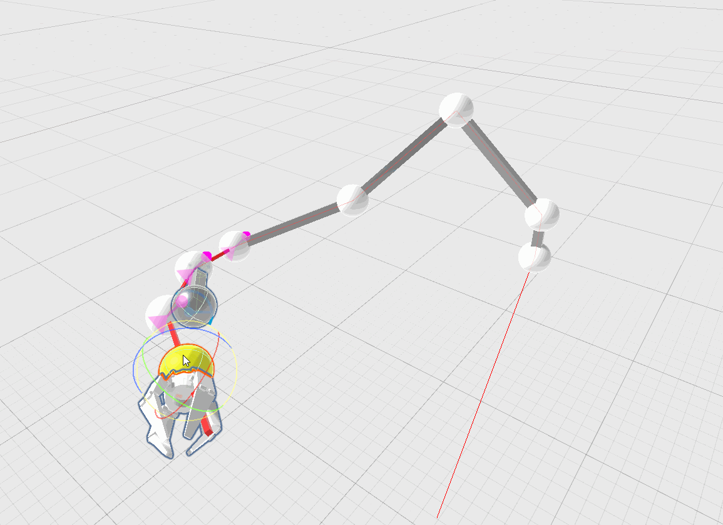
img/slideshow/2ndarm.gif
