477-vrms/vrm-website/img/slideshow/3rdarm.gif

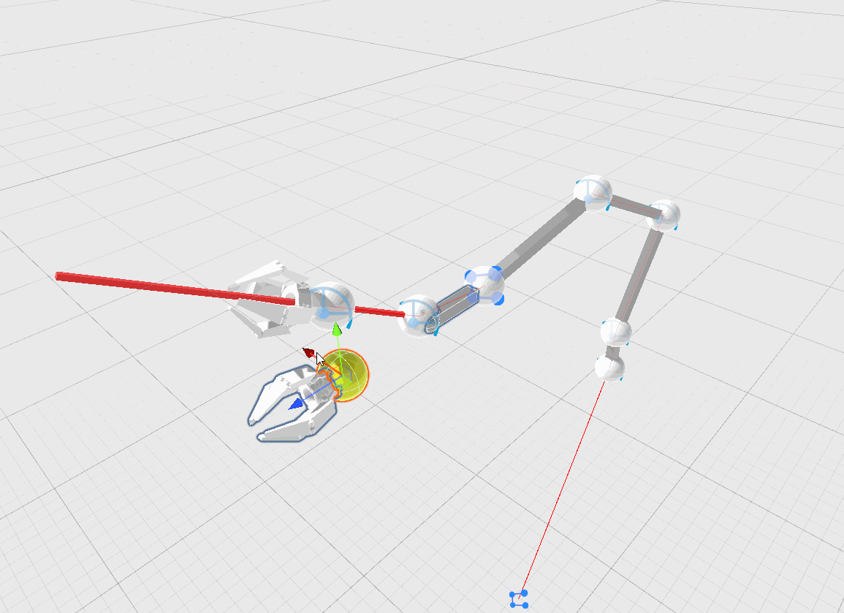
img/slideshow/3rdarm.gif
