477-vrms/vrm-website/img/slideshow/477grp2.jpg

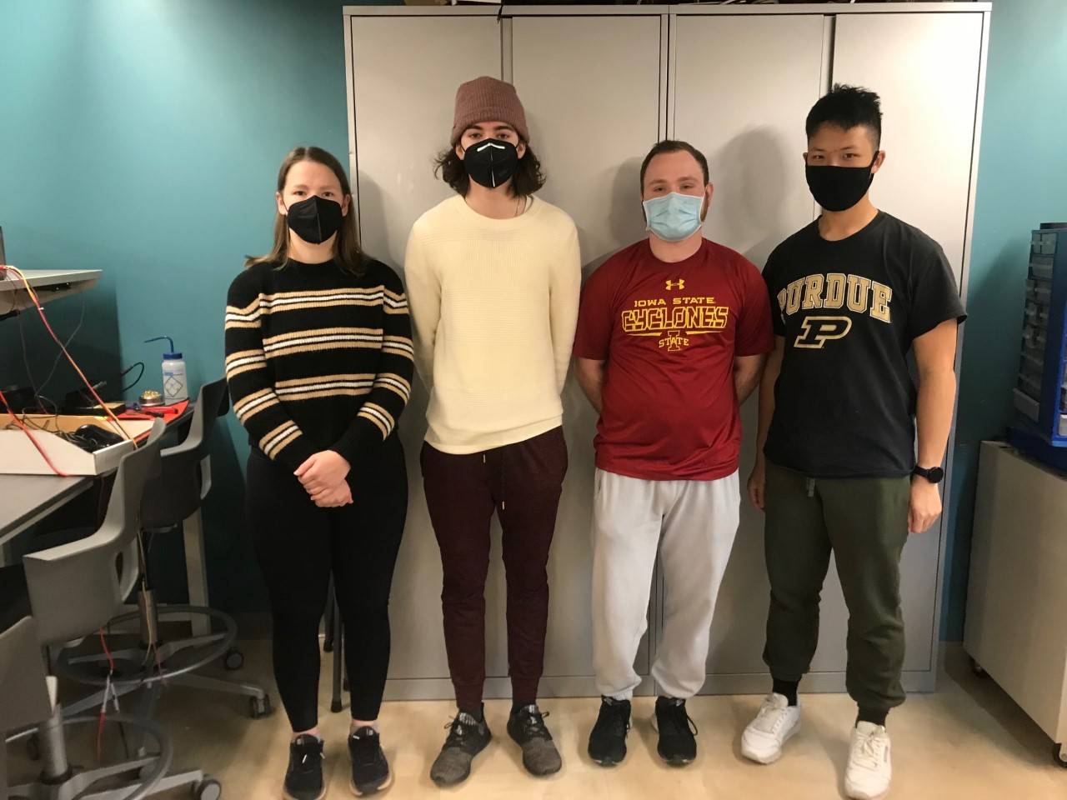
img/slideshow/477grp2.jpg
