477-vrms/vrm-website/img/slideshow/firstarm.png

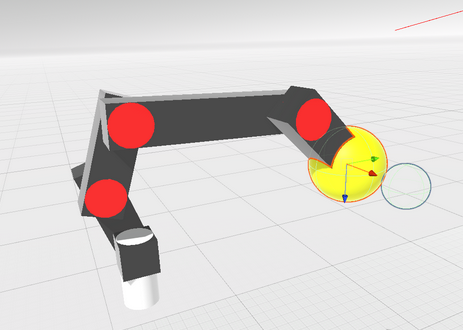
img/slideshow/firstarm.png
