477-vrms/vrm-website/Team/img/171001-EmmaClary-0028 (2).jpg

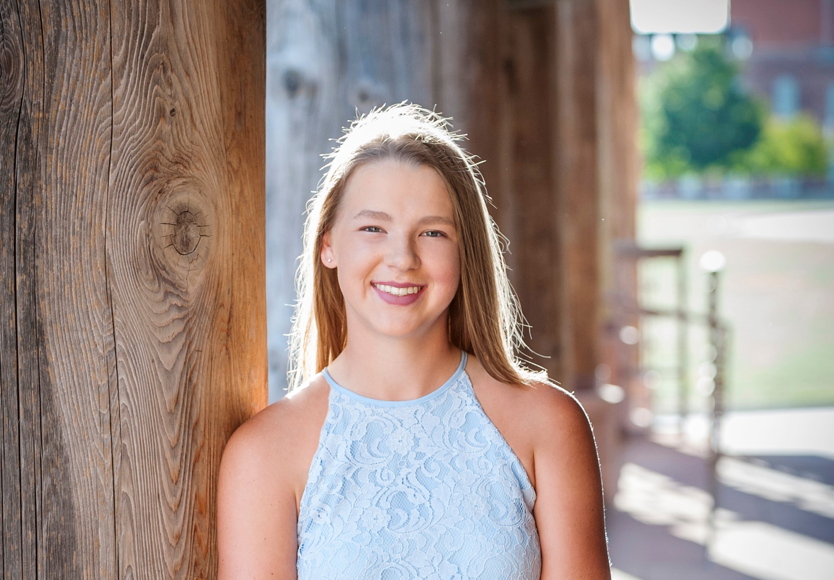
Team/img/171001-EmmaClary-0028 (2).jpg
