477-vrms/vrm-website/Team/img/BrianLatimer.jpg

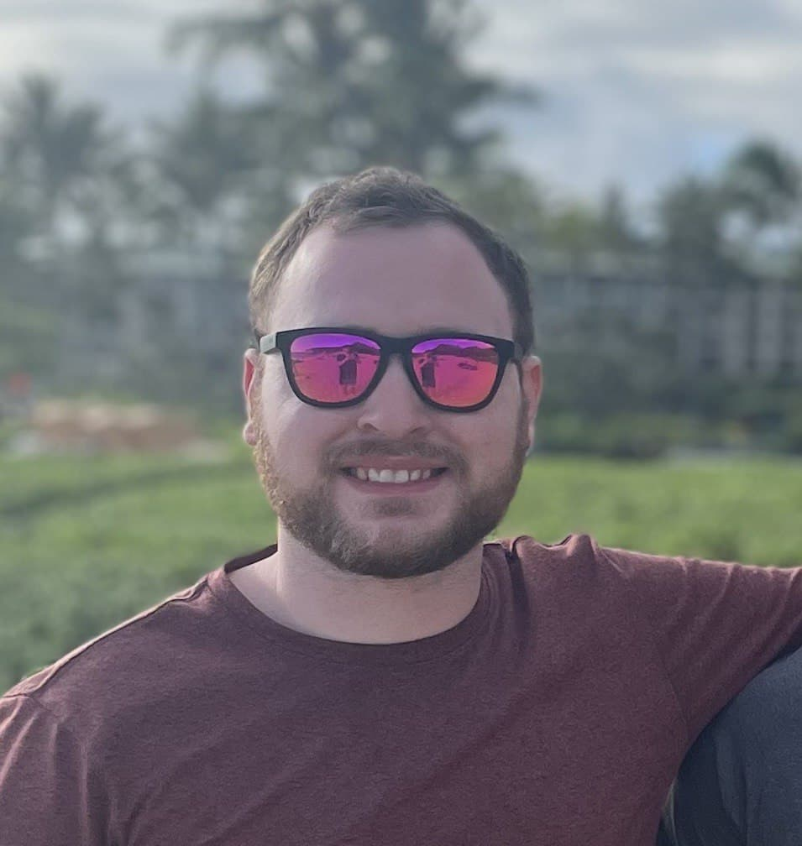
Team/img/BrianLatimer.jpg
