477-vrms/vrm-website/Team/img/JamesDonnelly.jpg

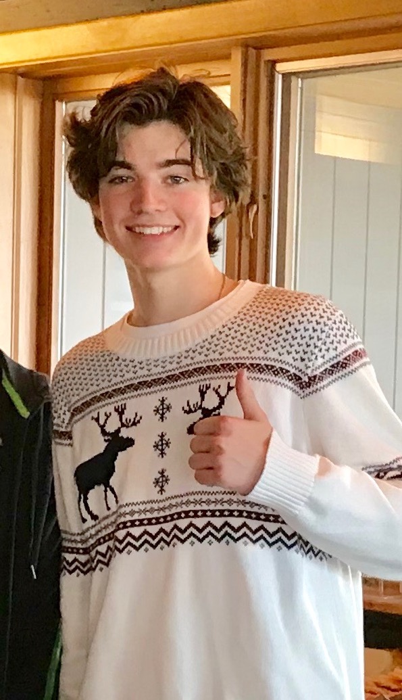
Team/img/JamesDonnelly.jpg
