477-vrms/vrm-website/Files/docs/6_BillOfMaterials.xlsx

ECE477 Bill of Materials v1.0
Year: | 2022 | Semester: 2 |  |  | Project Name: Vrms
Author: | Emma Clary | James Donnelly |  | Matthew Wen | Brian Latimer
Created: | 2002-02-09
Last Modified: | 2002-02-09
Project_Component |  |  |  |  |  |  |  | Qty:
Description | ID | Qty | Value | Package | Manufacturer | Mfg. Part # | Supplier | Supplier Part #
Arducam 2MP*2 Stereo Camera | - | 1 | - | Tripod | Utronics | B0264 | Utronics | B0264
Arducam Case and Tripod Bundle | - | 1 | - | Standalone | Utronics | UB0231 | Utronics | UB0231
Piezoelectronic Buzzer | - | 1 | - | Non-Standard | TDK | PS1240P02BT | Adafruit | 150
Voltage Regulator | - | 1 | - | Non-Standard | onsemi | MC33269T-3.3G | Mouser | 863-MC33269T-3.3G
Servo Bracket Kit | - | 1 | - | Non-Standard | elechawk | 88065 | Amazon | B07PQ12TXS
Raspberry-Pi 4 Model B | - | 1 | - | Standalone | Raspberry-Pi | RPI4-MODBP-2GB | Adafruit | 4292
Hp Reverb G2 VR Headset | - | 1 | - | Non-Standard | Hp | 1G5U1AA#ABA | Hp | 1G5U1AA#ABA
Hp Reverb G2 Controller Pair | - | 1 | - | Non-Standard | Hp | 22J70AA | Hp | 22J70AA
xArm 1S: Hiwonder Robotic Arm | - | 1 | - | Non-Standard | Hiwonder | - | Hiwonder | -
16 Channel Servo Controller | - | 1 | - | Non-Standard | Hiwonder | - | Hiwonder | -
LX-15D Serial Bus Servo | - | 1 | - | Non-Standard | Hiwonder | - | Hiwonder | -
Stepper Motor | - | 1 | - | Non-Standard | StepperOnline | 17HS19-2004S1 | Amazon | B00PNEQKC0
Printed Circuit Board | - | 1 | - | Off-Board | Advanced Circuits | - | - | -
Microcontroller | - | 1 | - | 64-LQFP | STMicroelectronics | STM32F091RCT6 | Mouser | 511-STM32F091RCT6
Enclosure | - | 1 | - | Off-Board | 3D Print | - | - | -
5V 1A Power Supply | - | 1 | - | Non-Standard | JOVNO | JVN5V1ABK | Amazon | B08Q38QMFD
