477-vrms/vrm-website/Files/img/blatimer/week5/debug.png

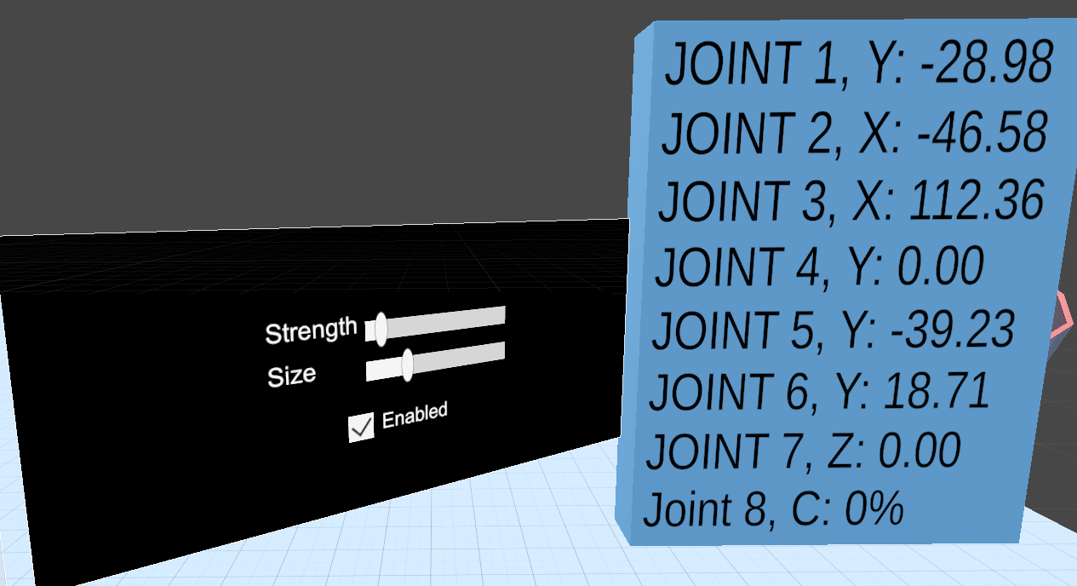
Files/img/blatimer/week5/debug.png
