477-vrms/vrm-website/Files/img/wen101/week5/fixing-issue.jpg

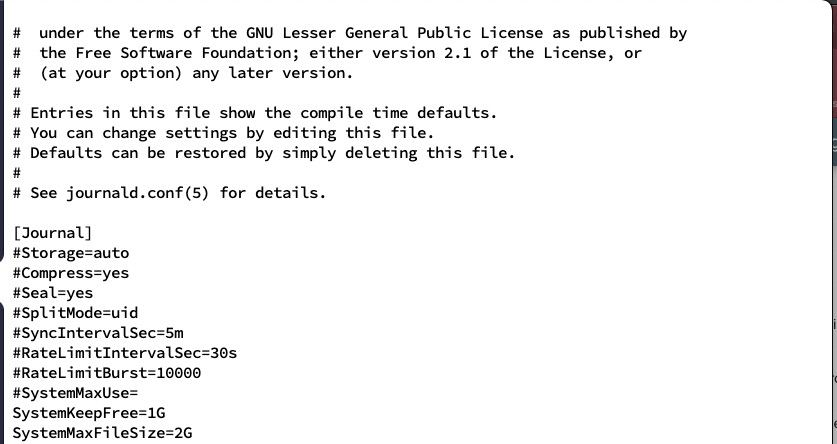
Files/img/wen101/week5/fixing-issue.jpg
