477-vrms/vrm-website/Files/docs/2SC1815-BJT.pdf

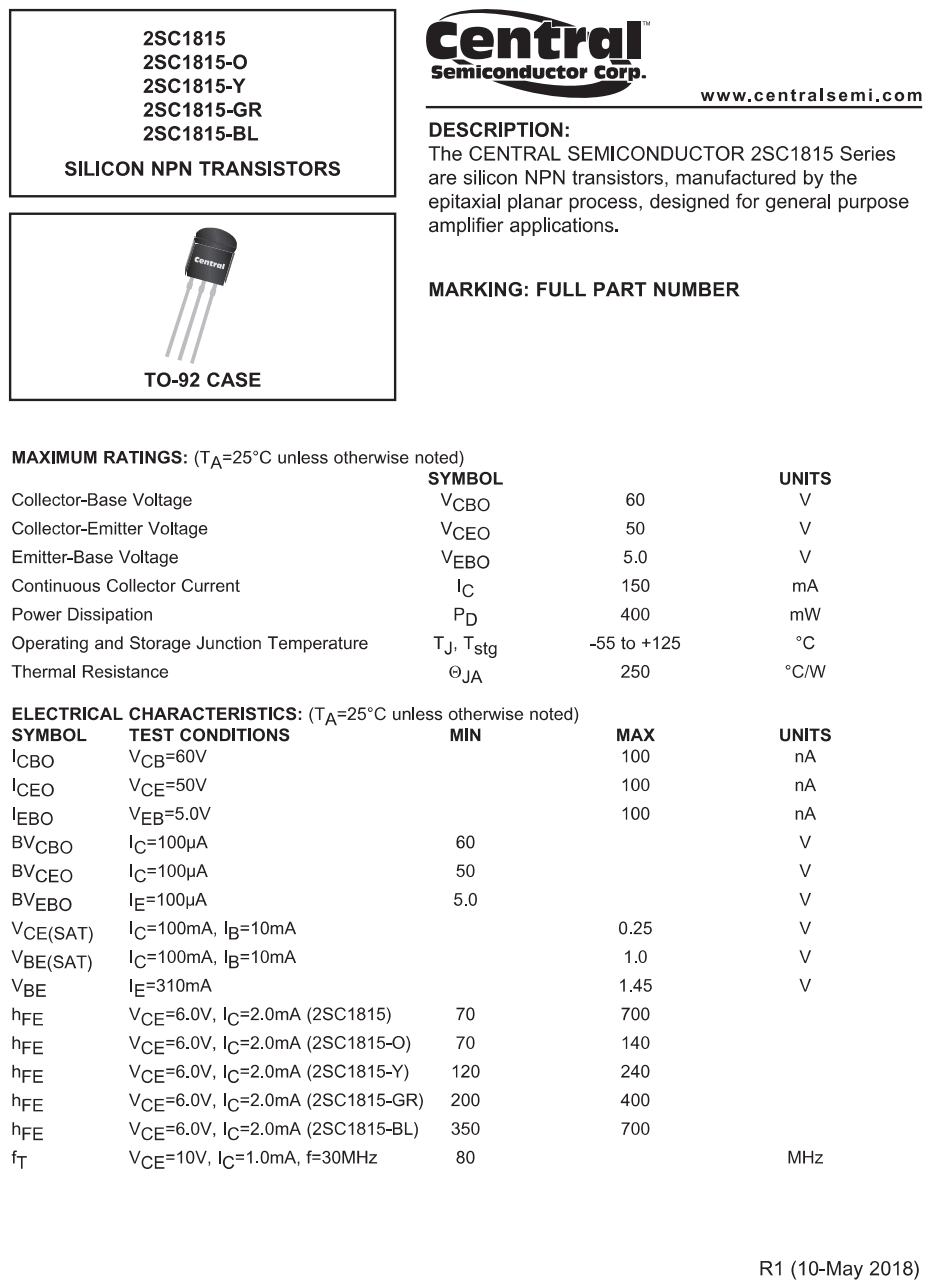
[picture p109: page 1]

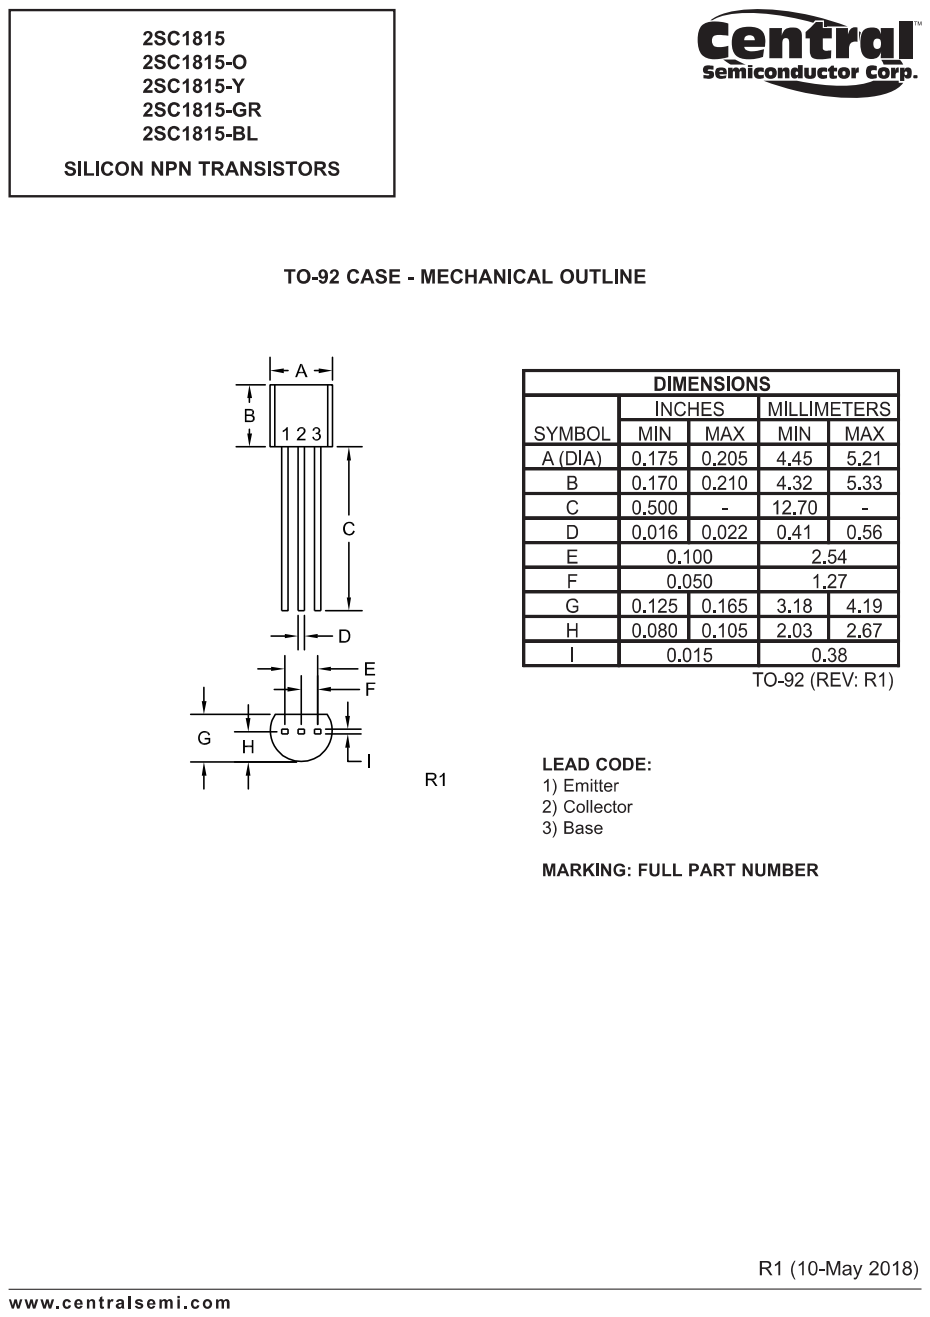
[picture p110: page 2]

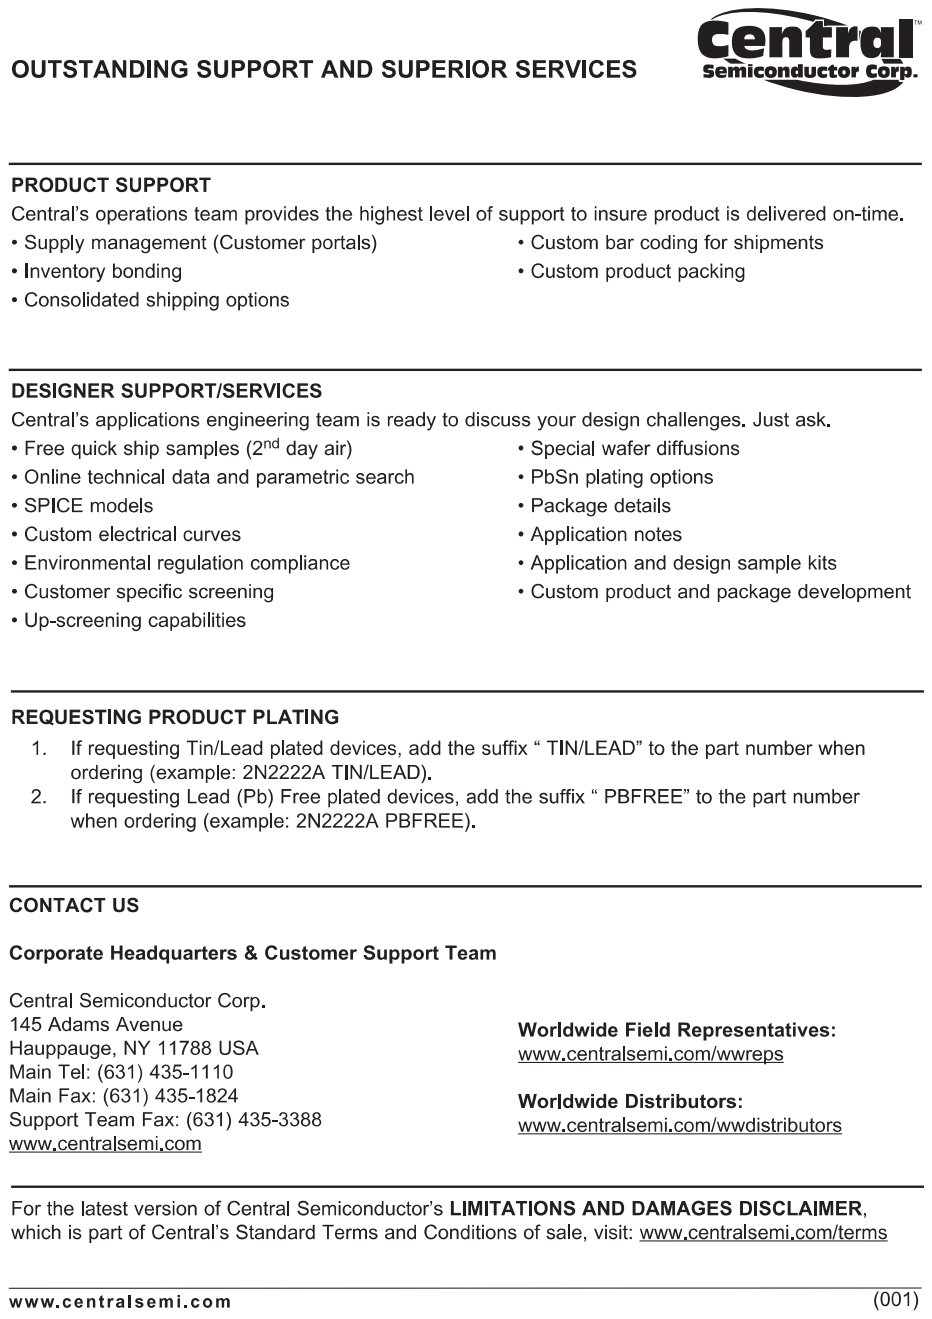
[picture p111: page 3]
