477-vrms/vrm-website/Files/docs/DMN100-7-F-MOSFET.pdf

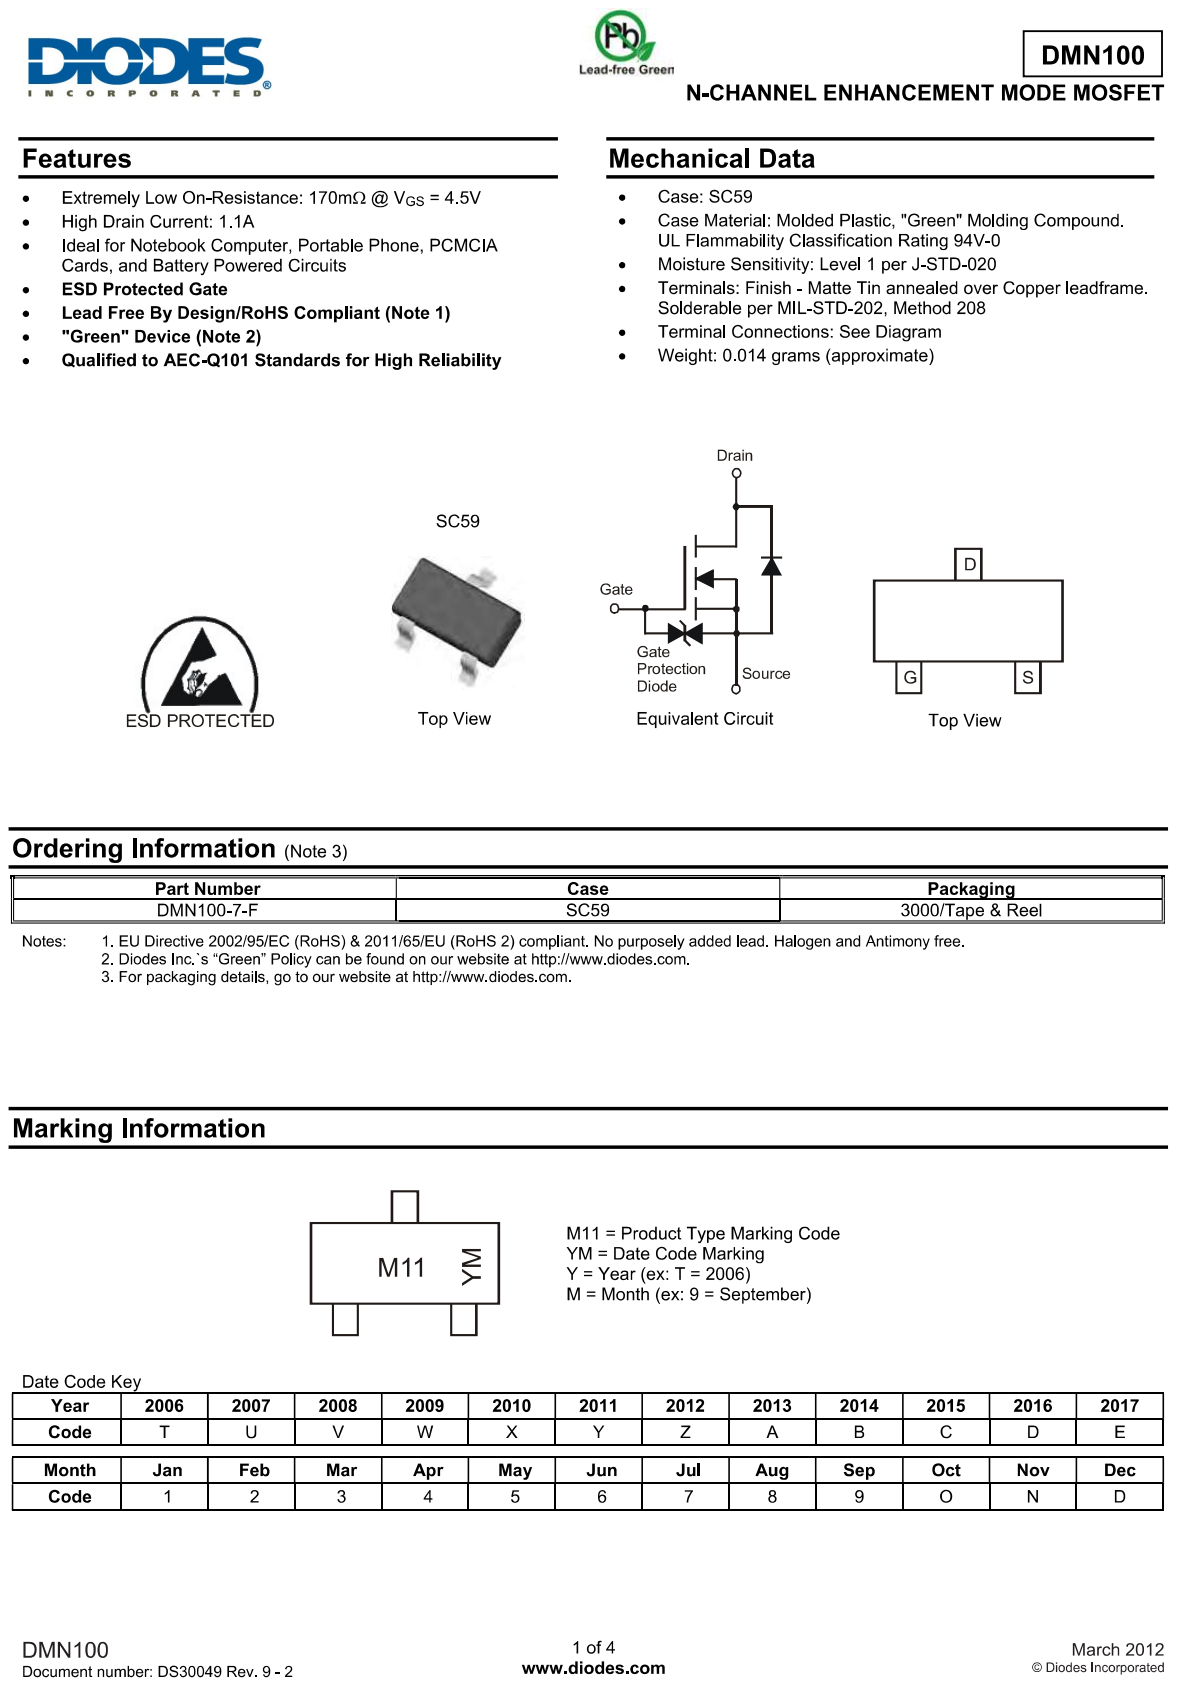
[picture p112: page 1]

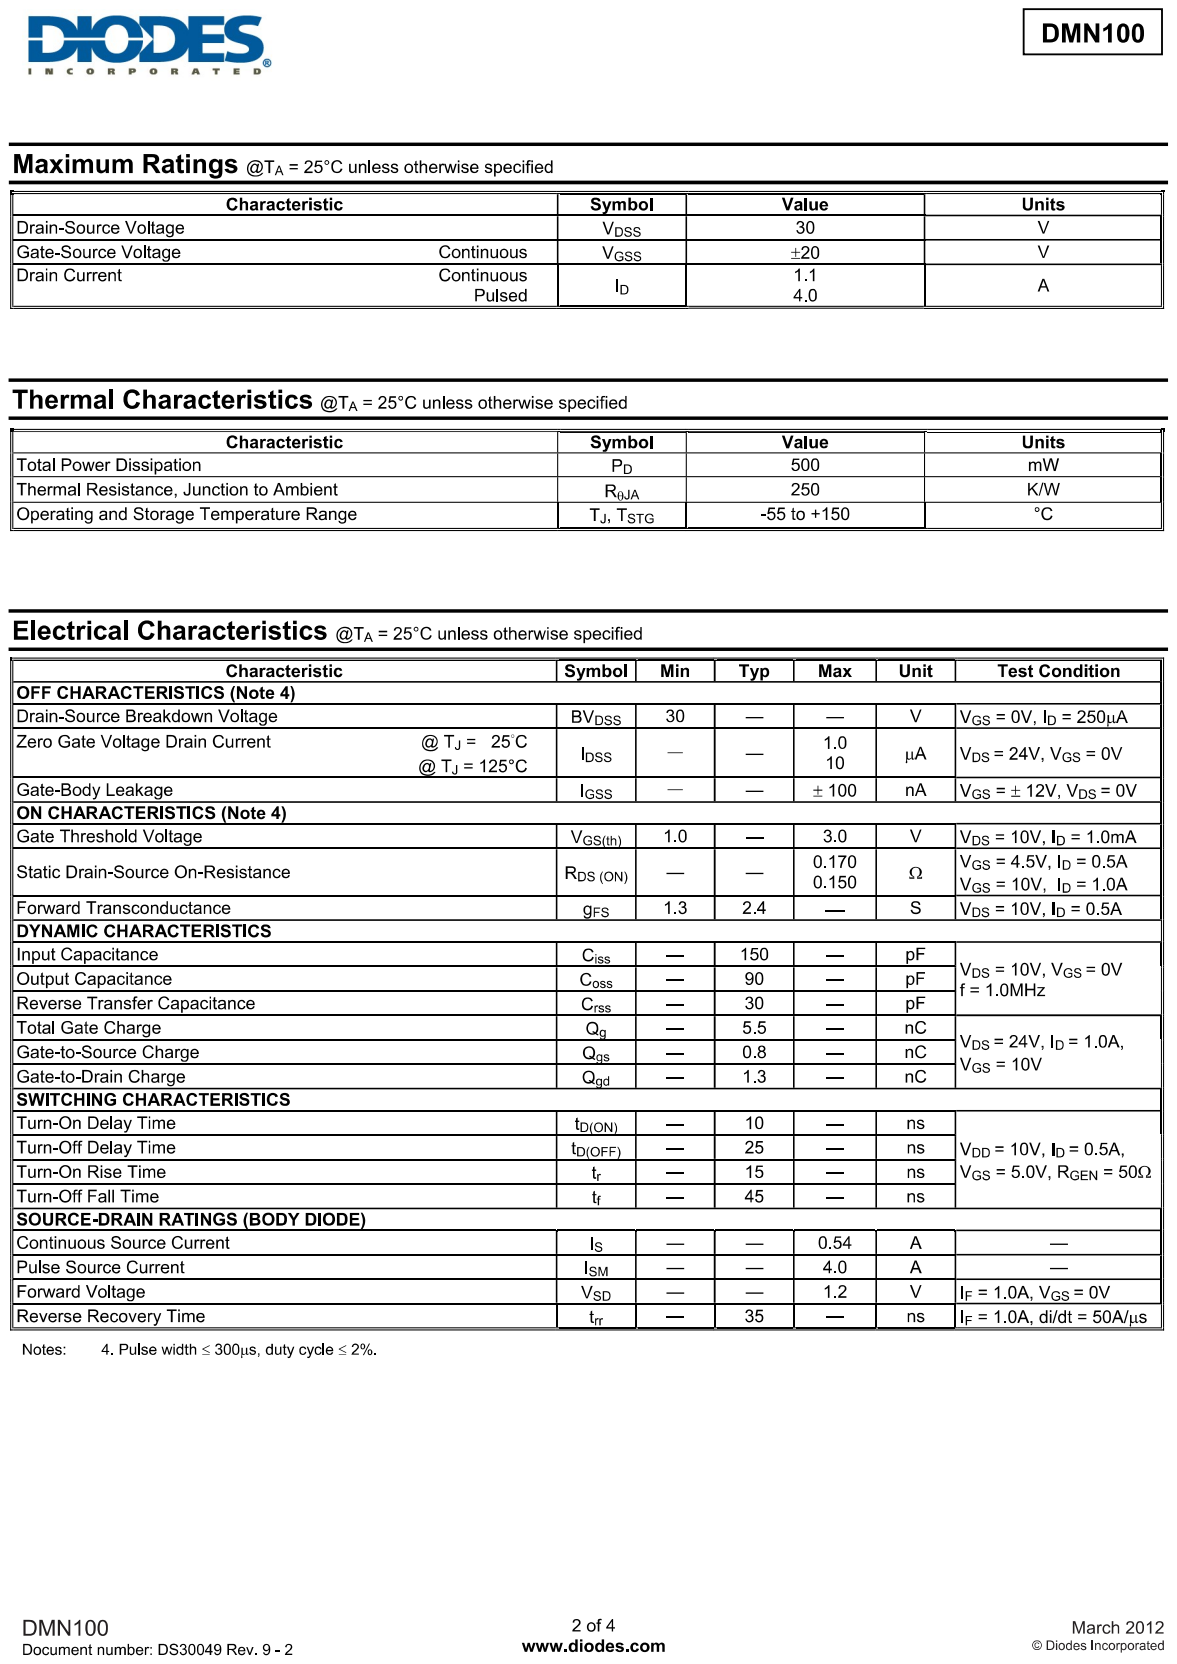
[picture p113: page 2]

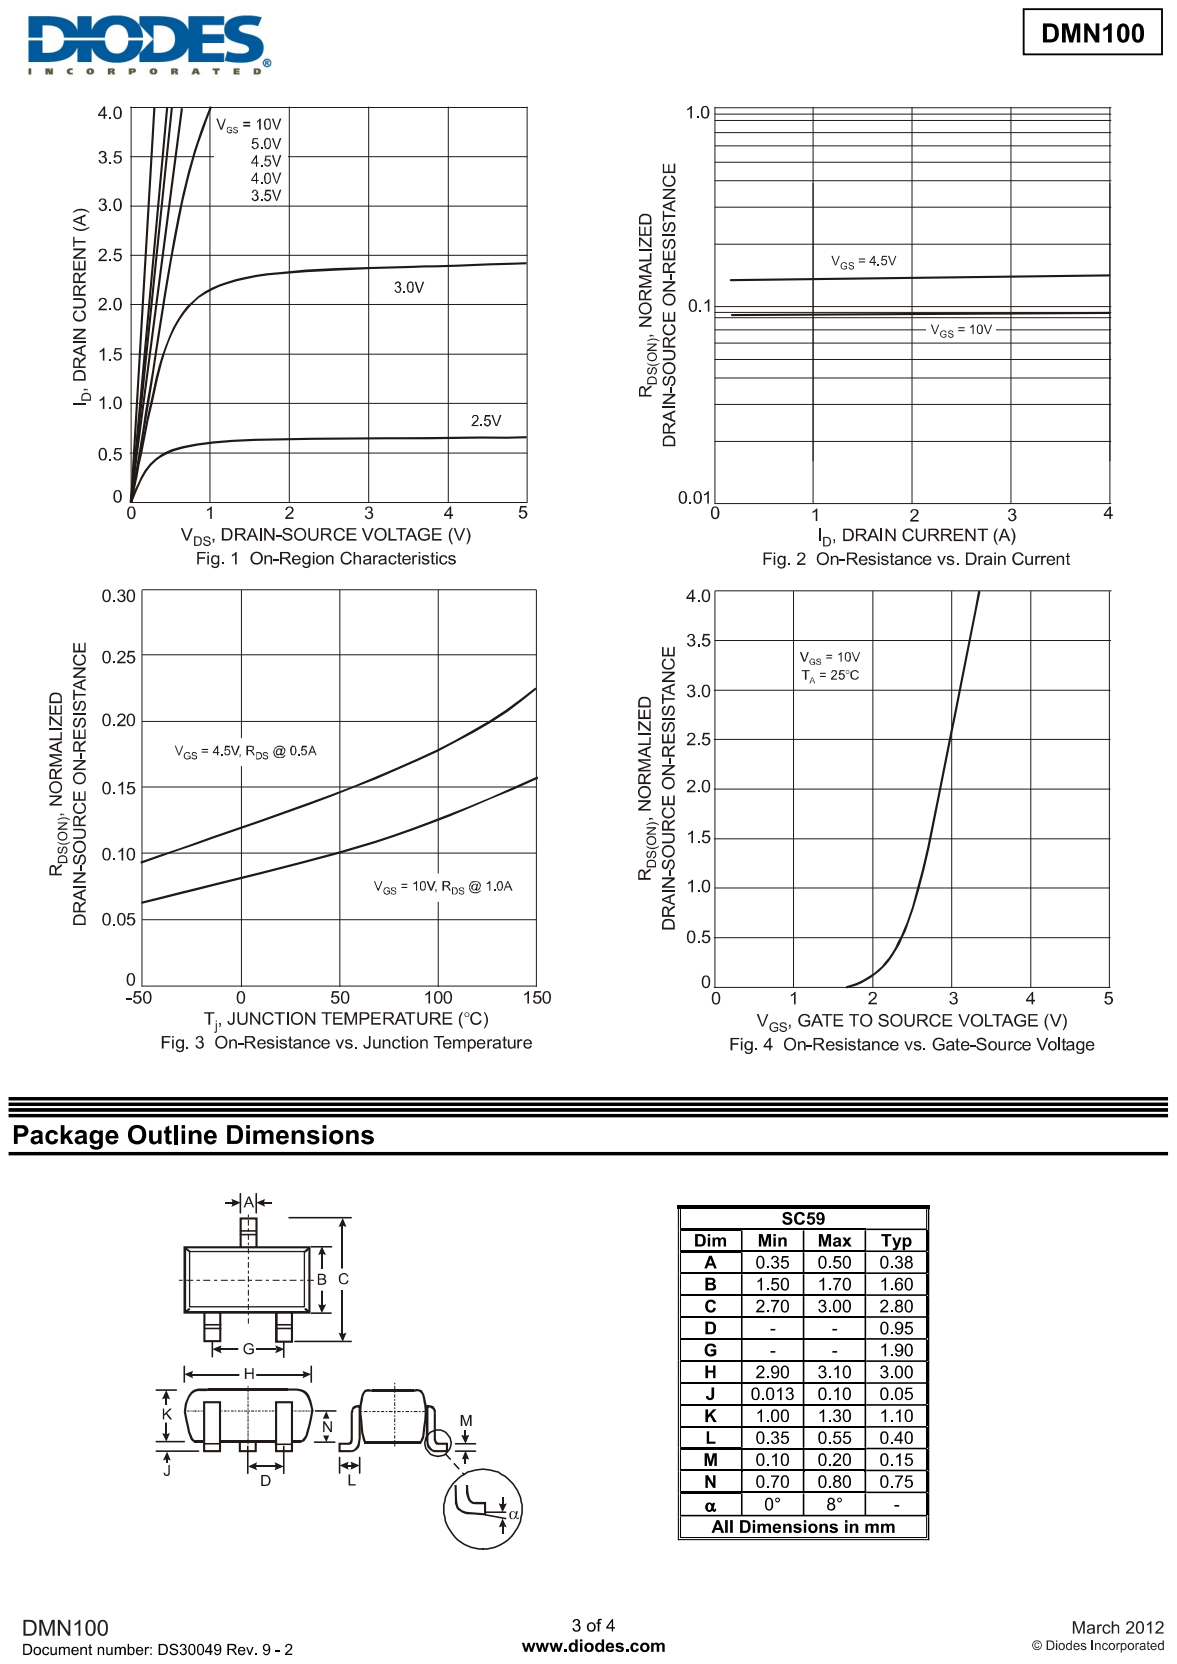
[picture p114: page 3]

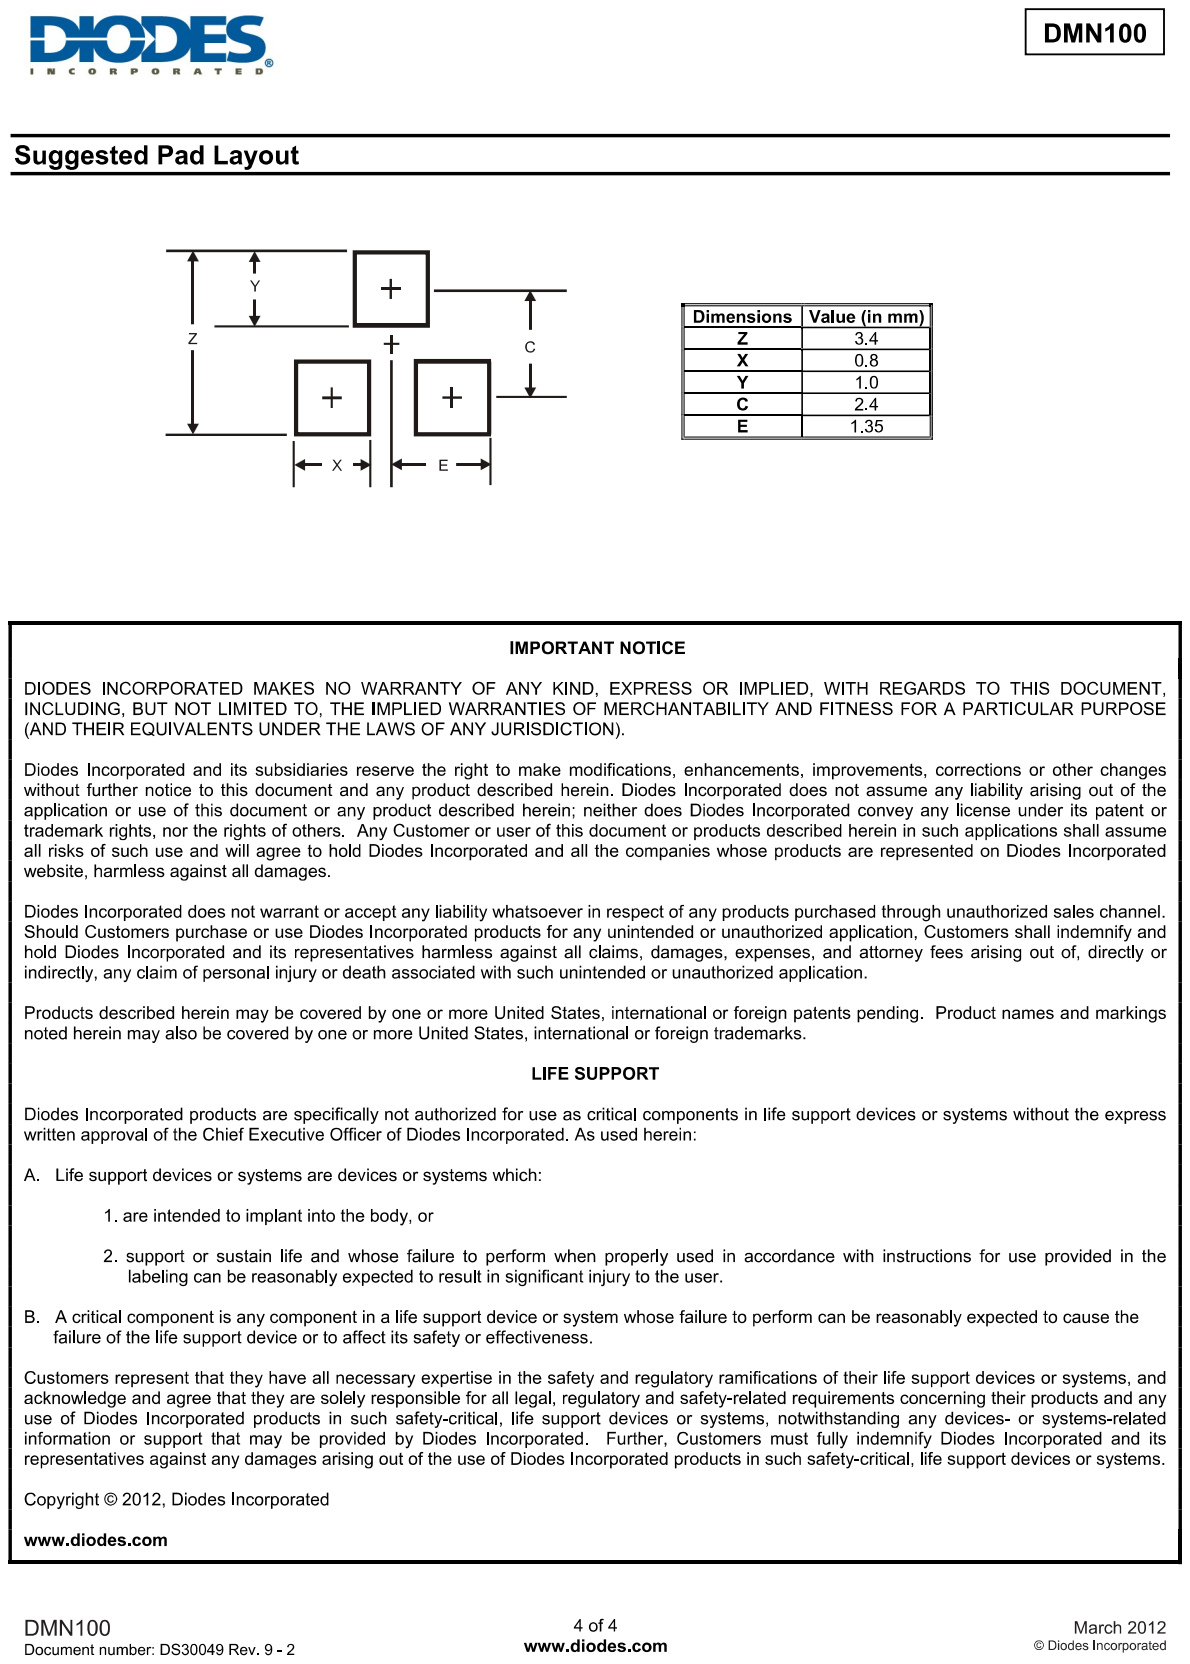
[picture p115: page 4]
