477-vrms/vrm-website/Files/docs/FMMTA06-BJT.pdf

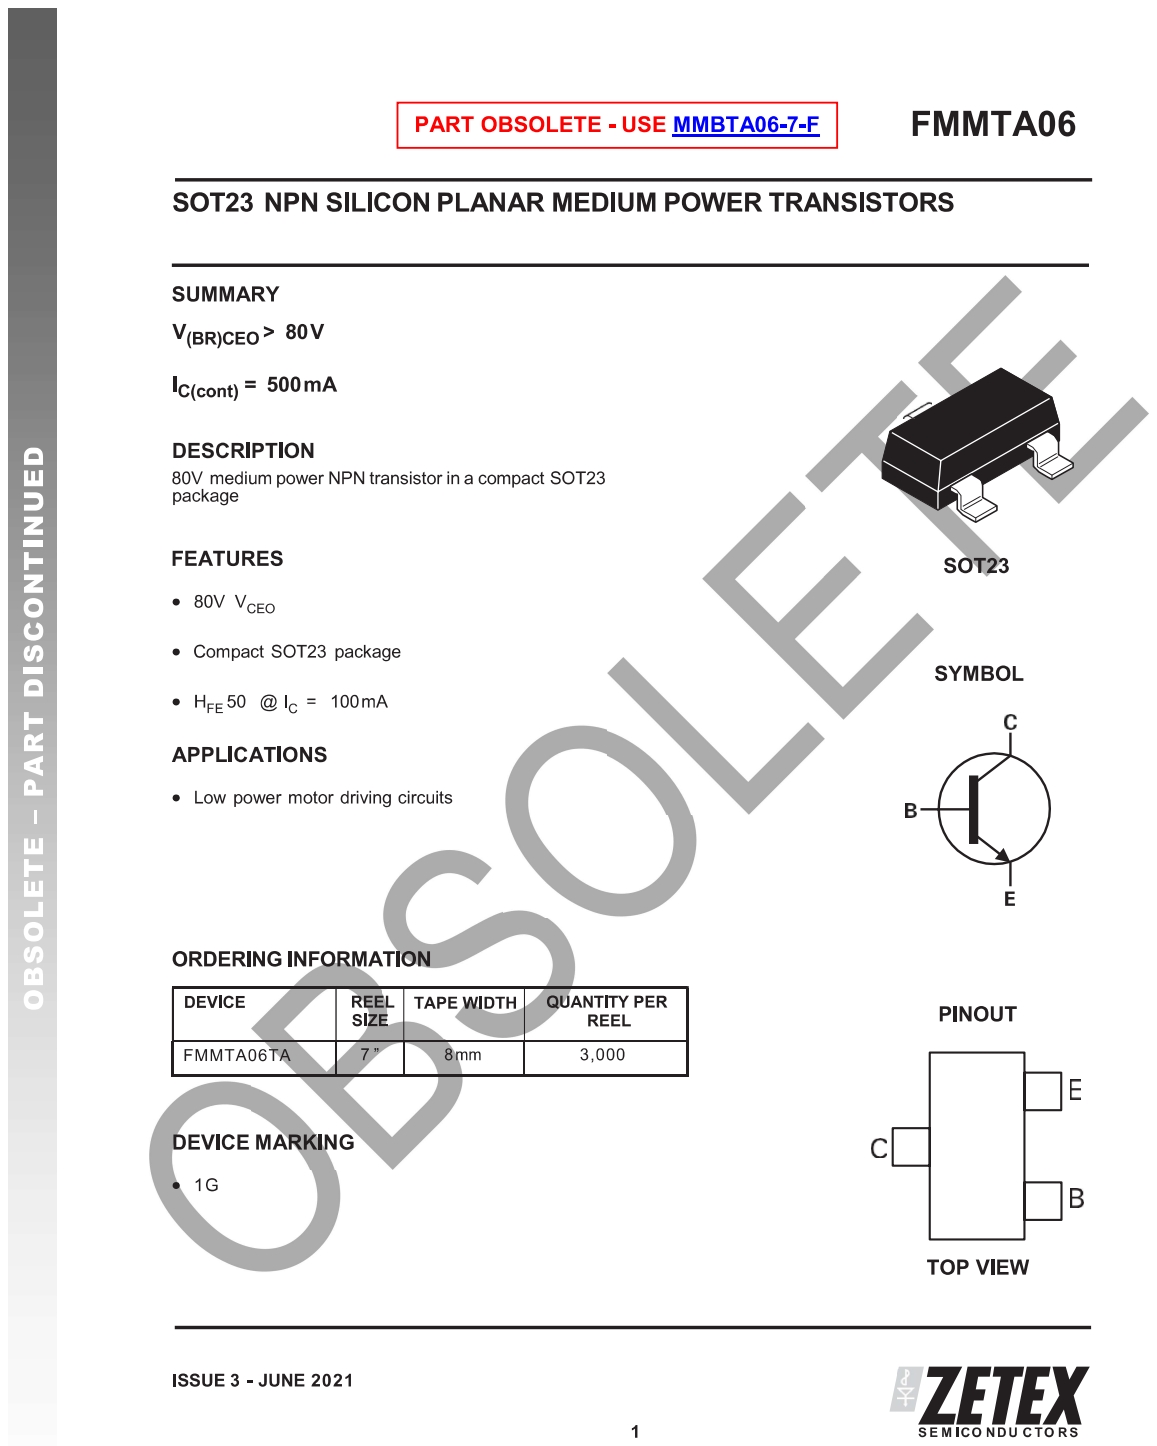
[picture p116: page 1]

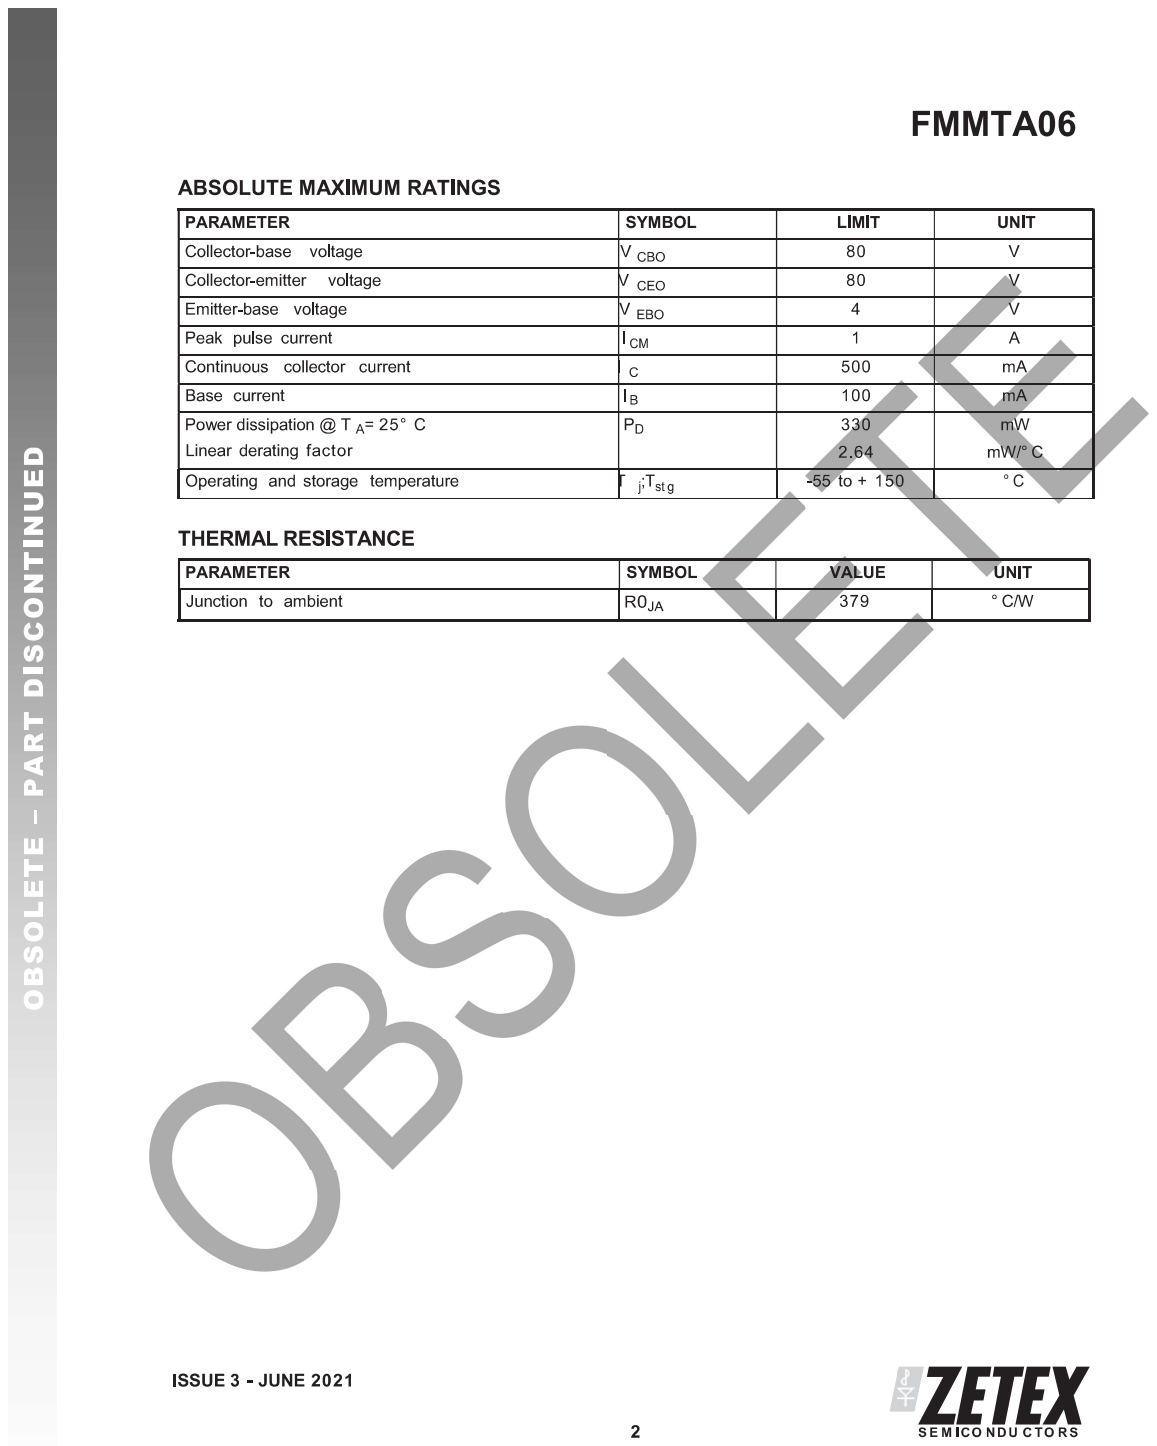
[picture p117: page 2]

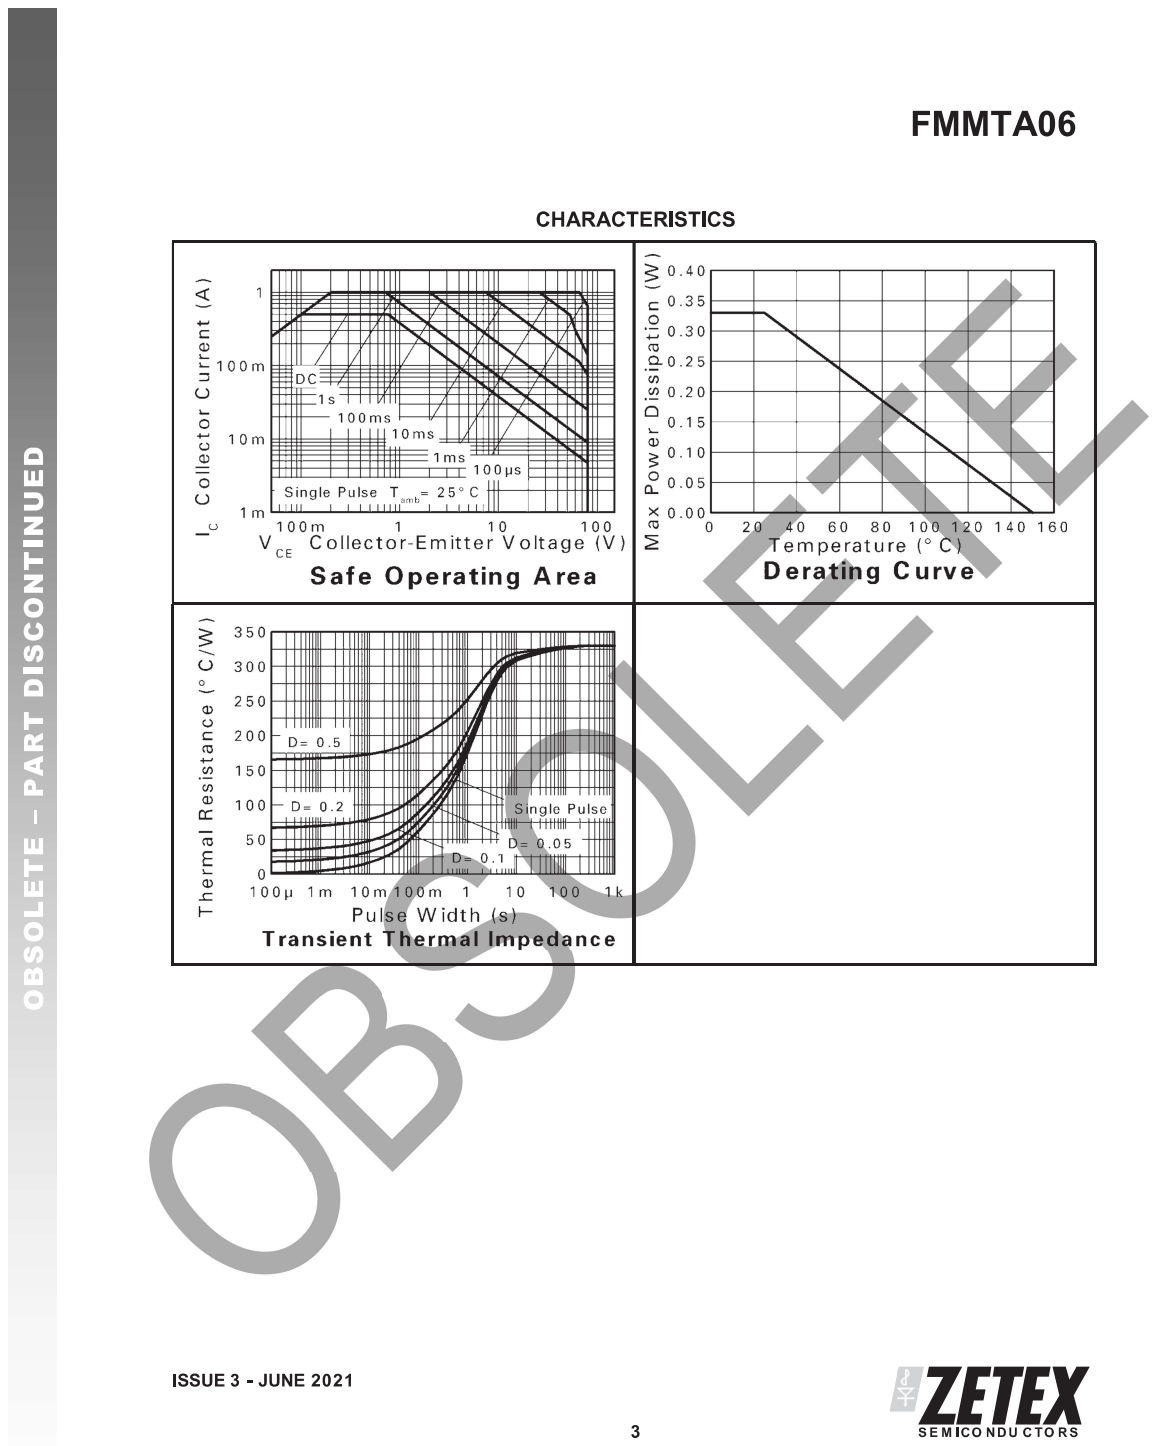
[picture p118: page 3]

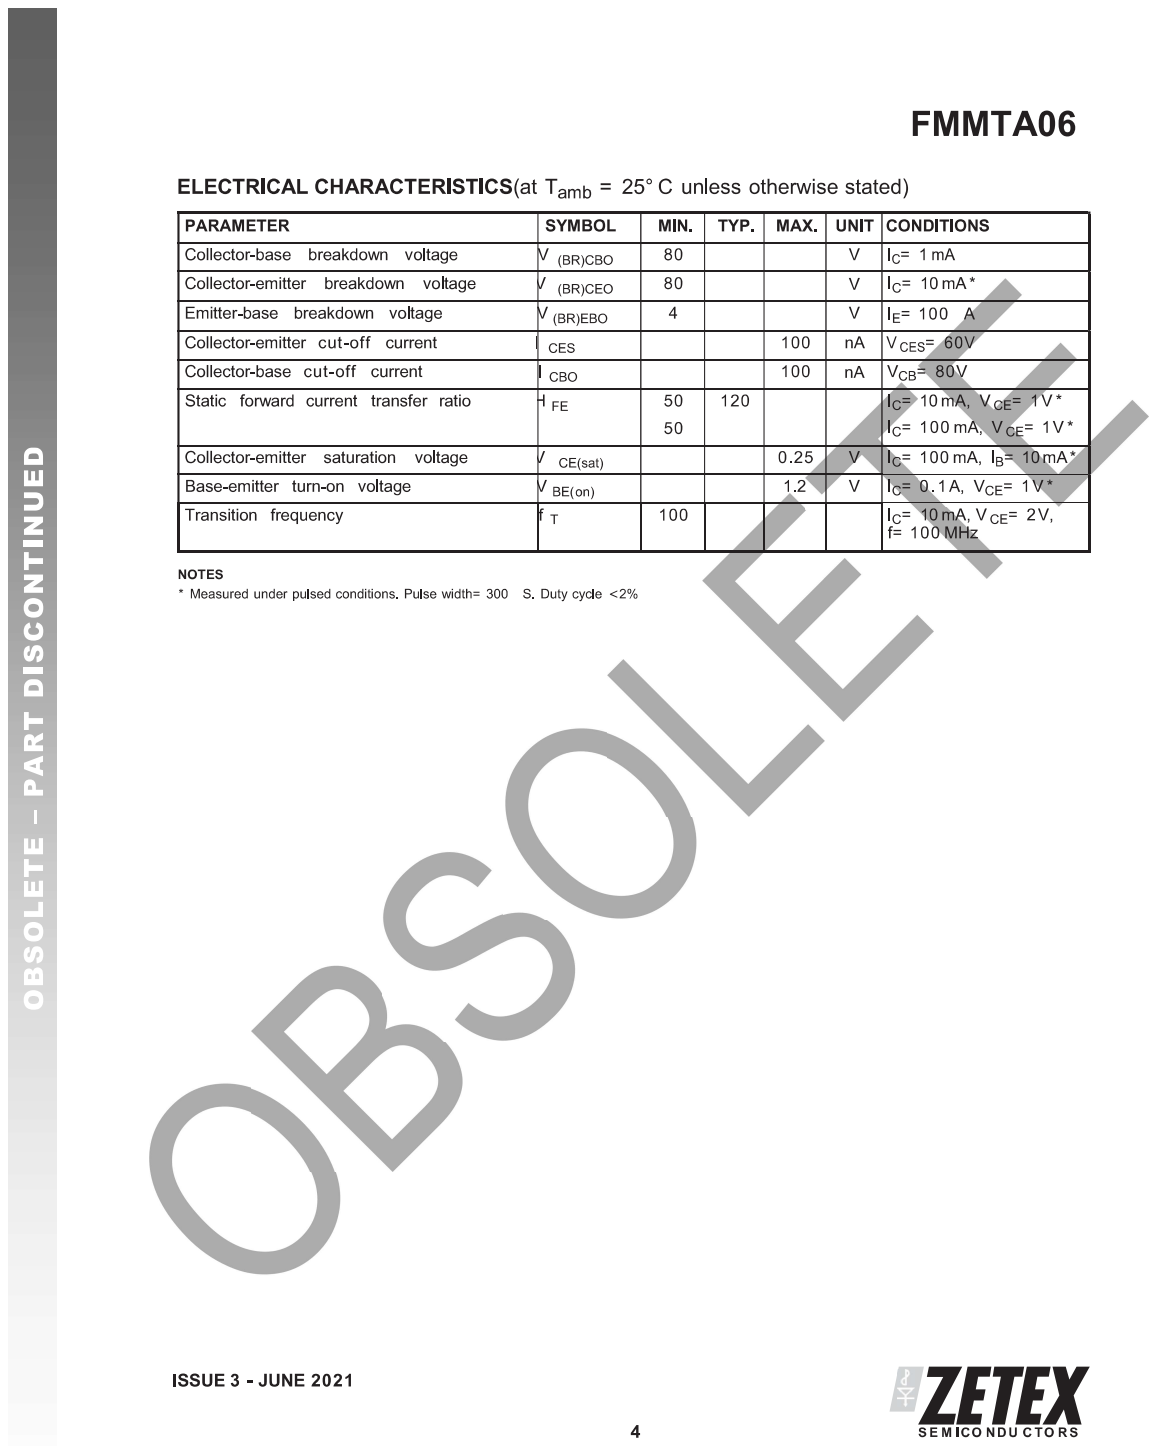
[picture p119: page 4]

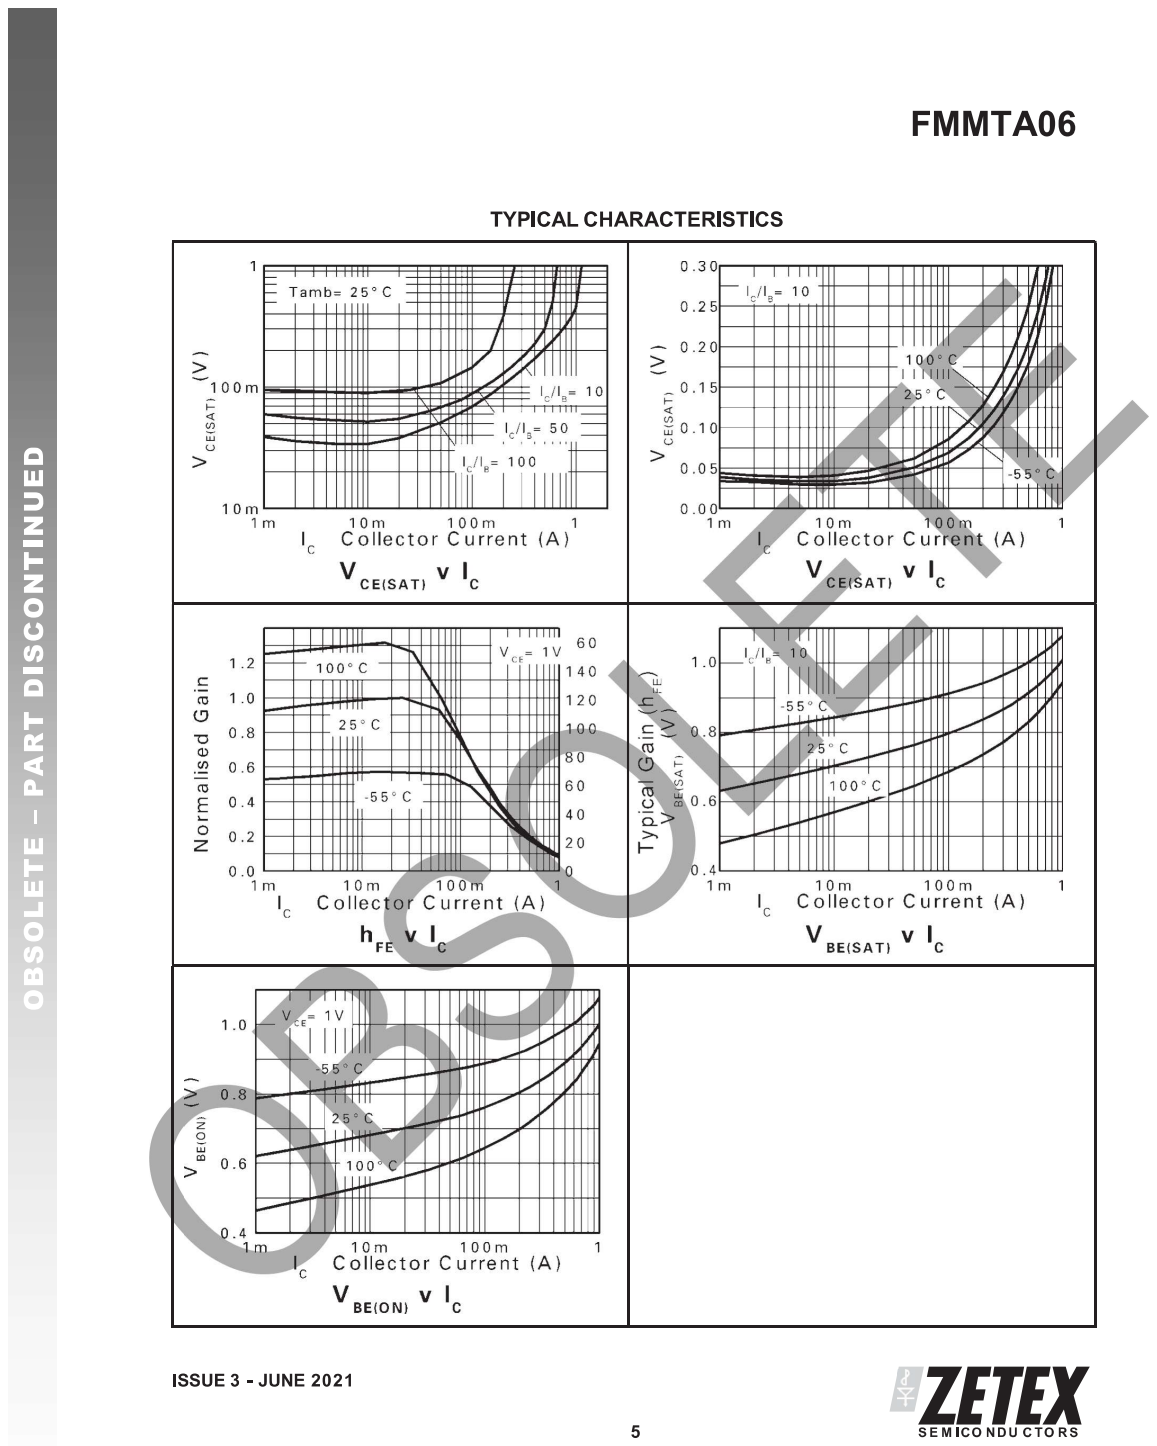
[picture p120: page 5]

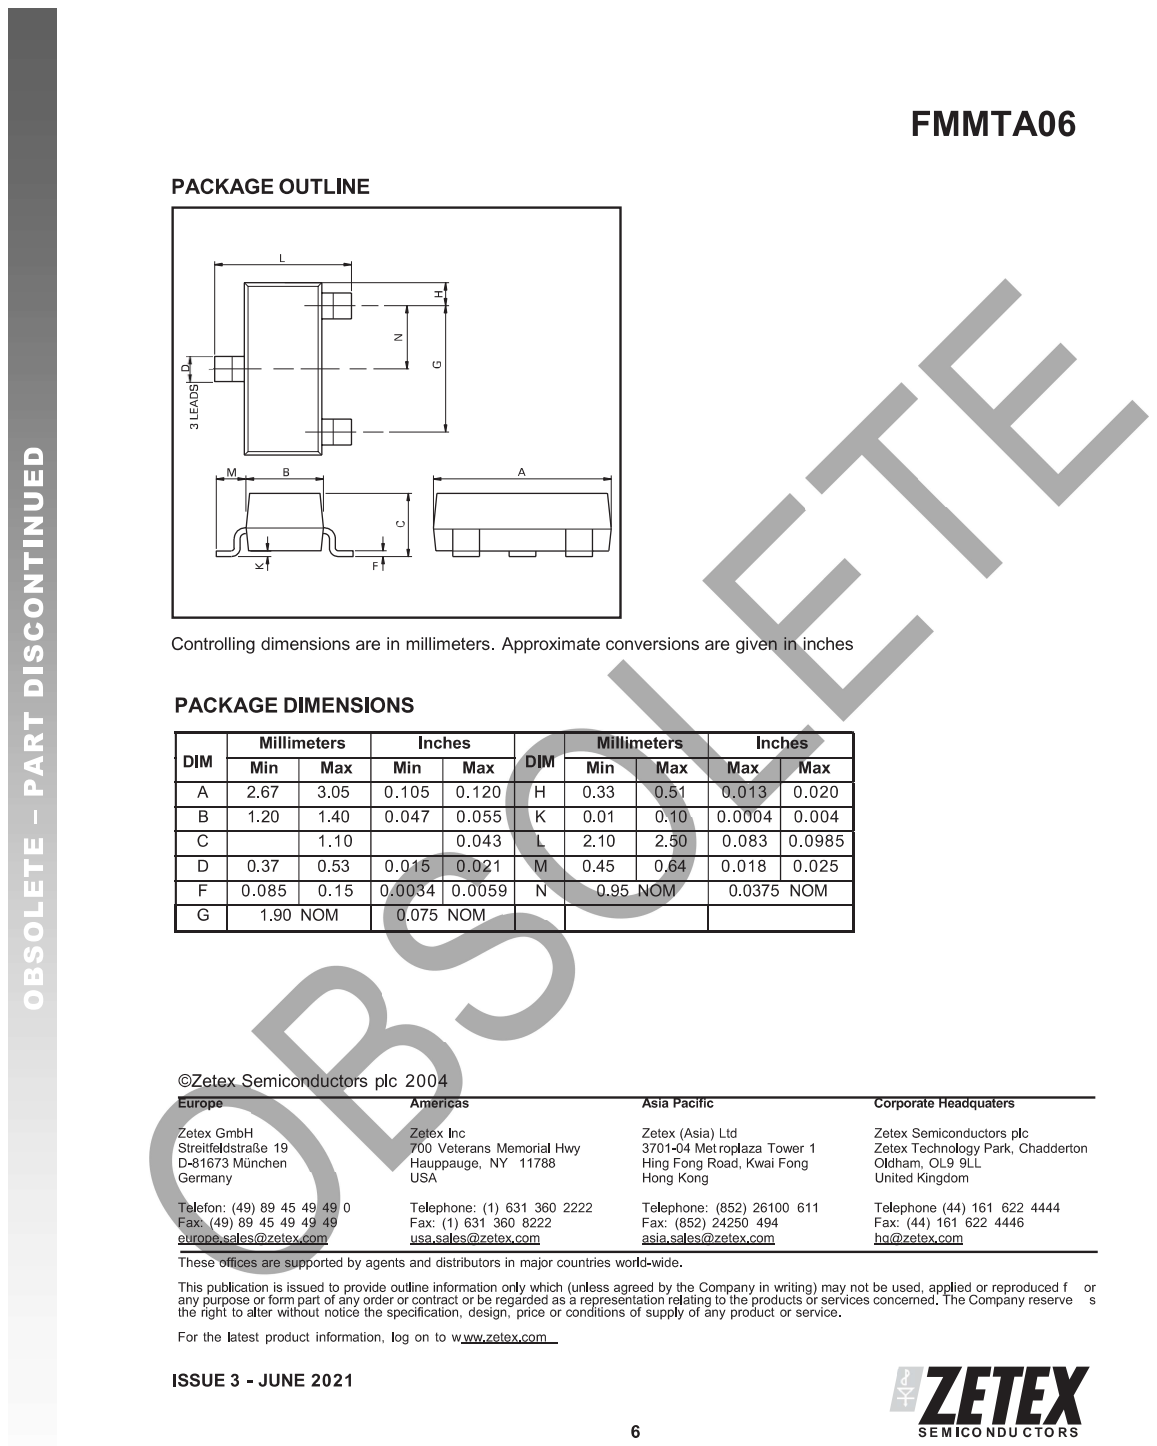
[picture p121: page 6]

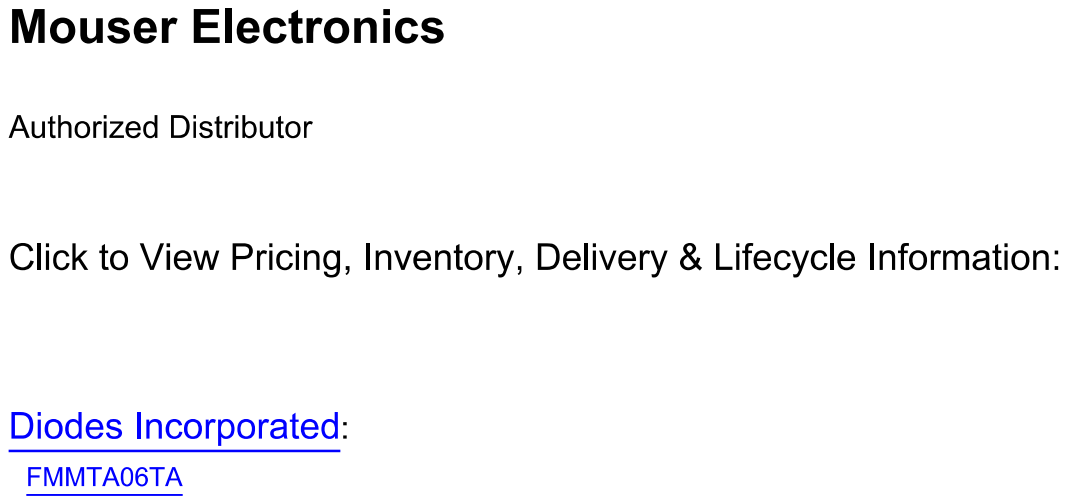
[picture p122: page 7]
