477-vrms/vrm-website/Files/docs/LTC3631EDD-3.3BUCK.pdf

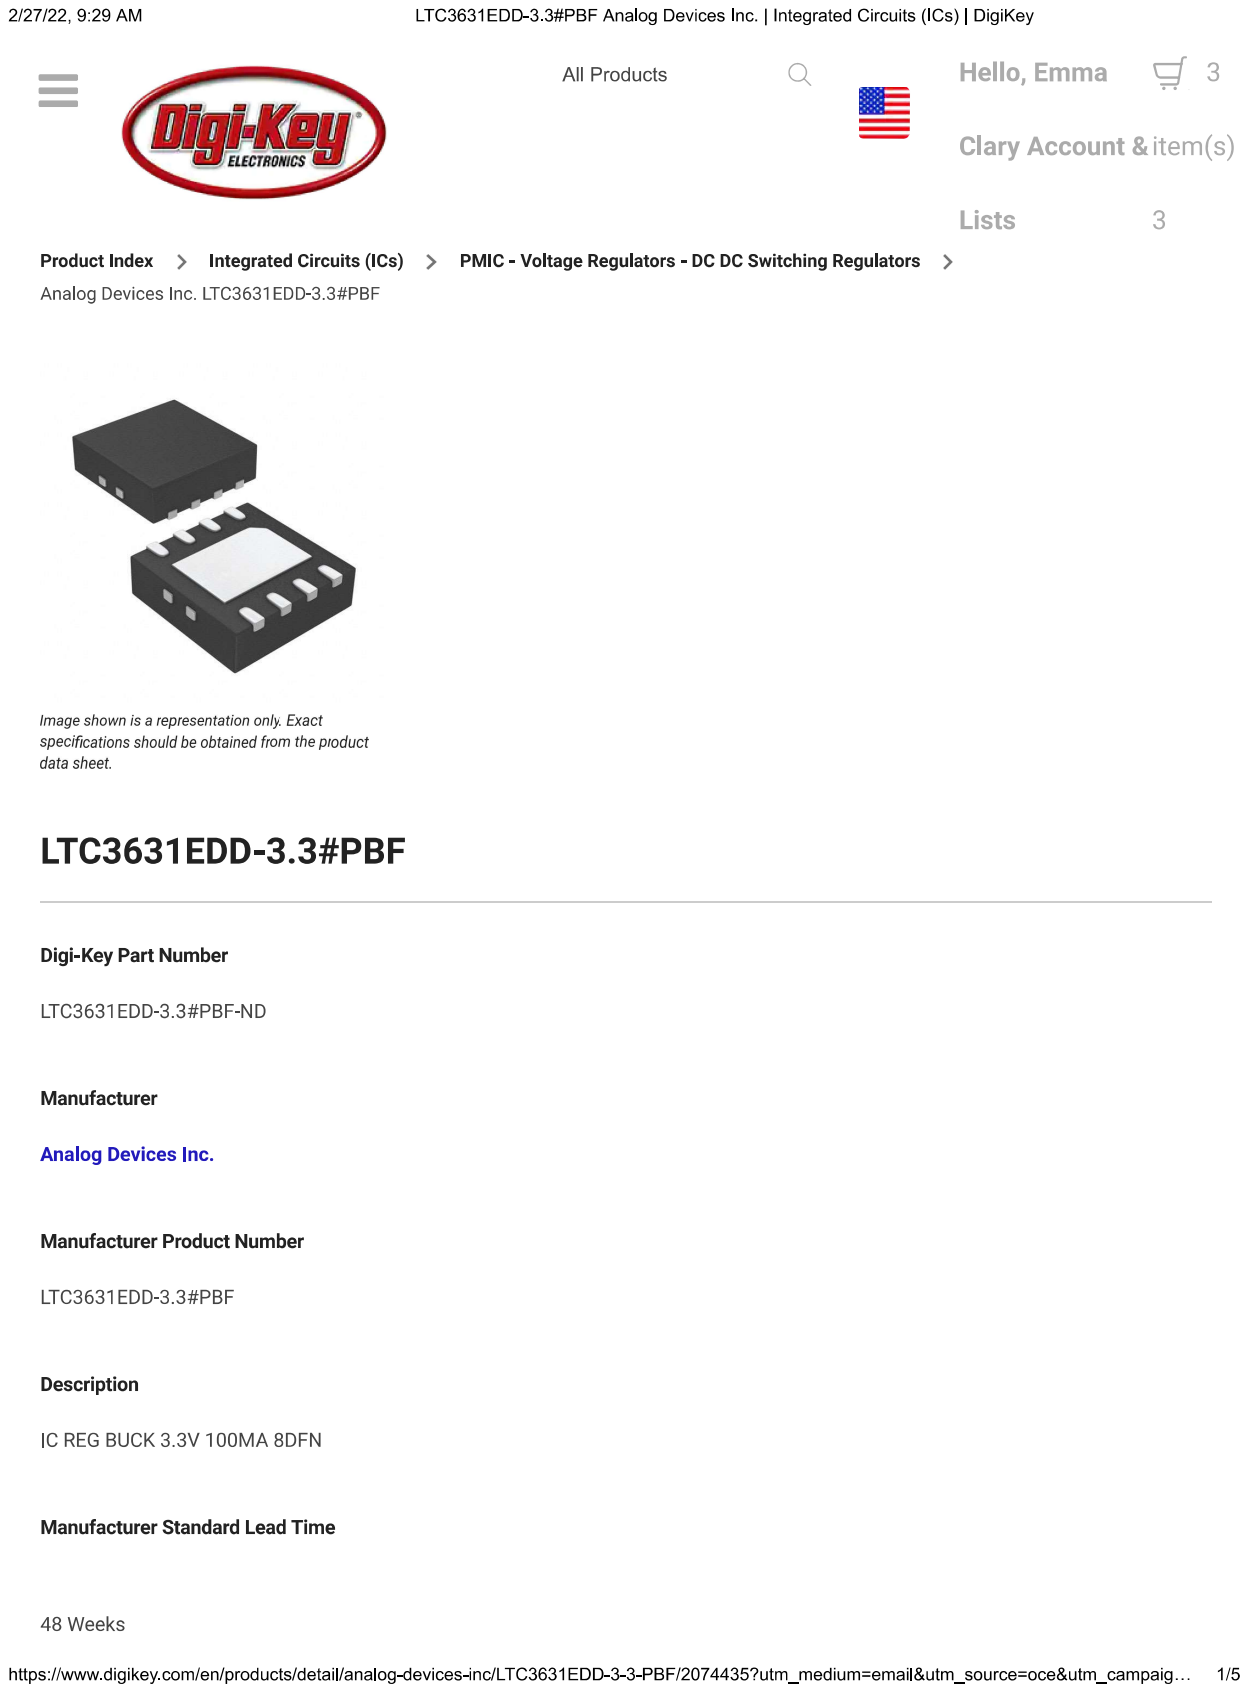
[picture p139: page 1]

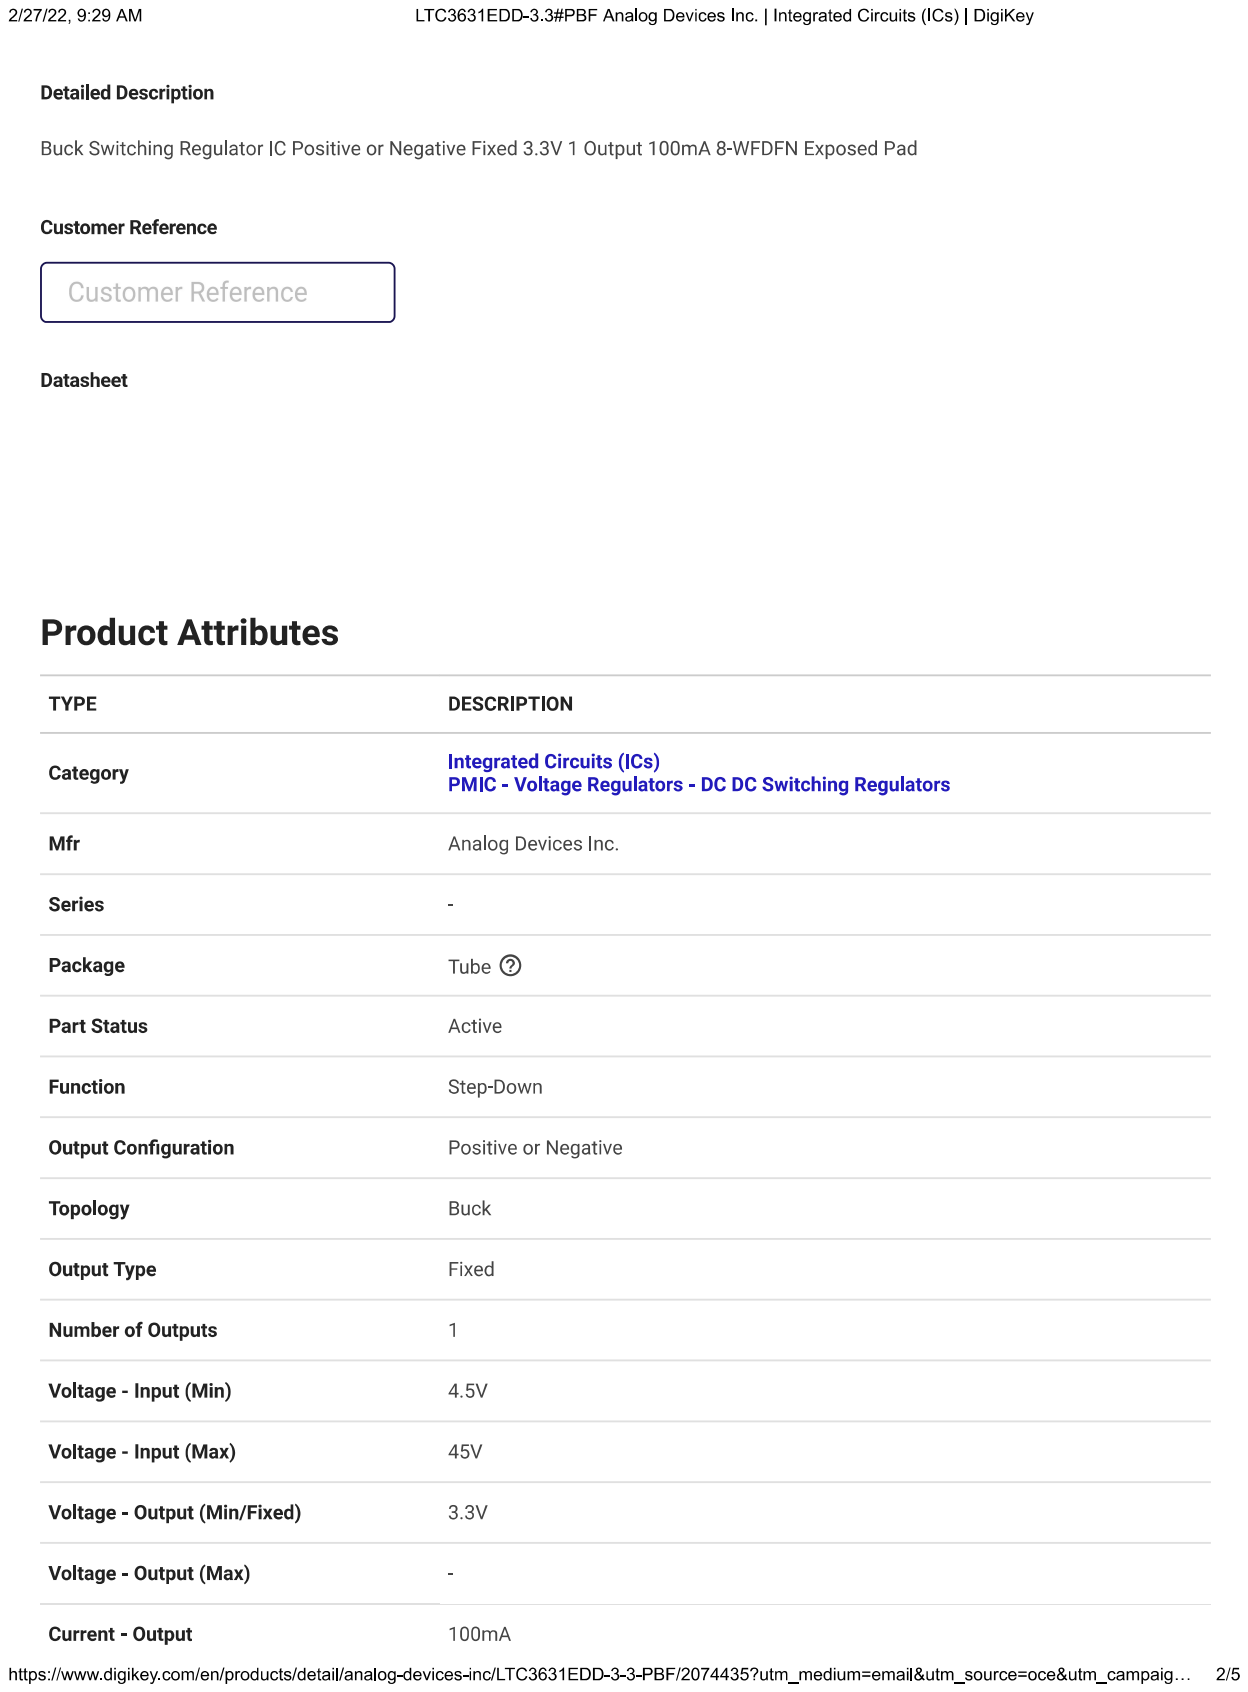
[picture p140: page 2]

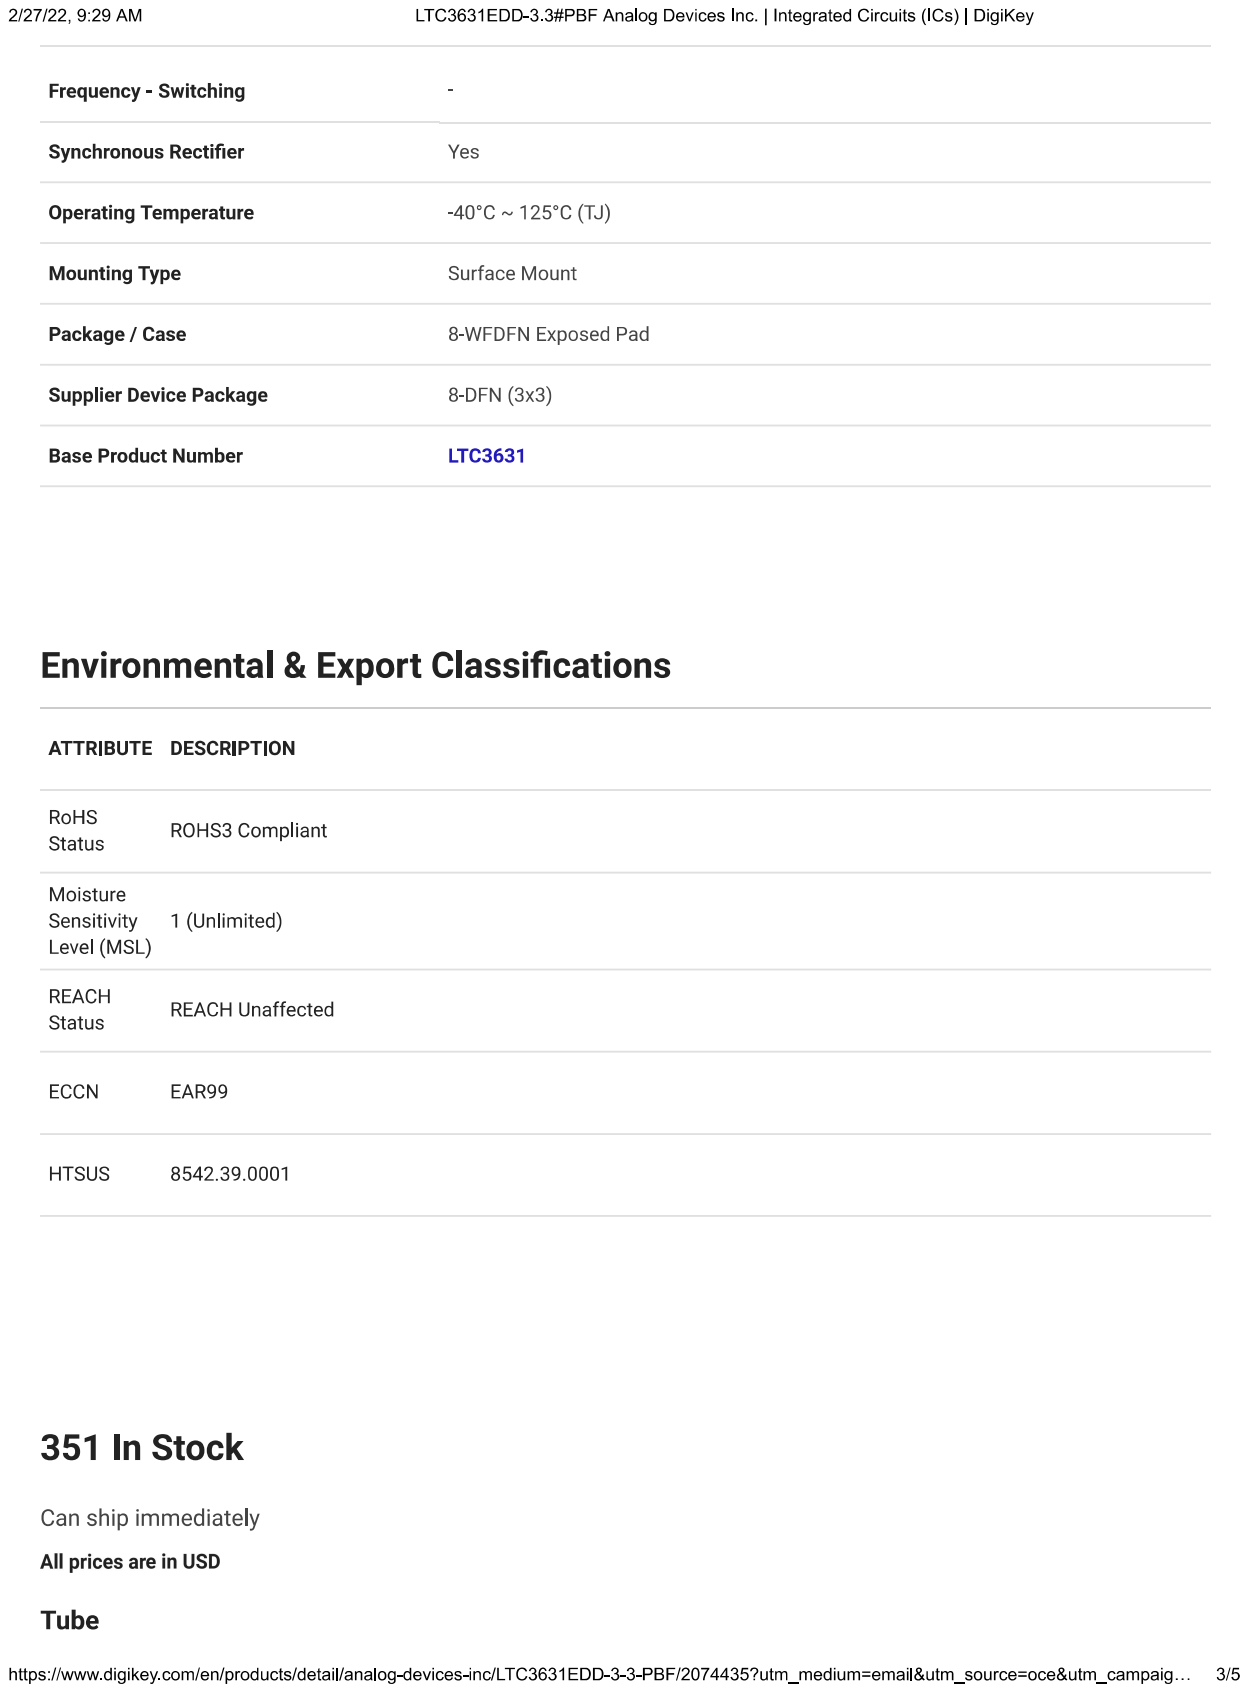
[picture p141: page 3]

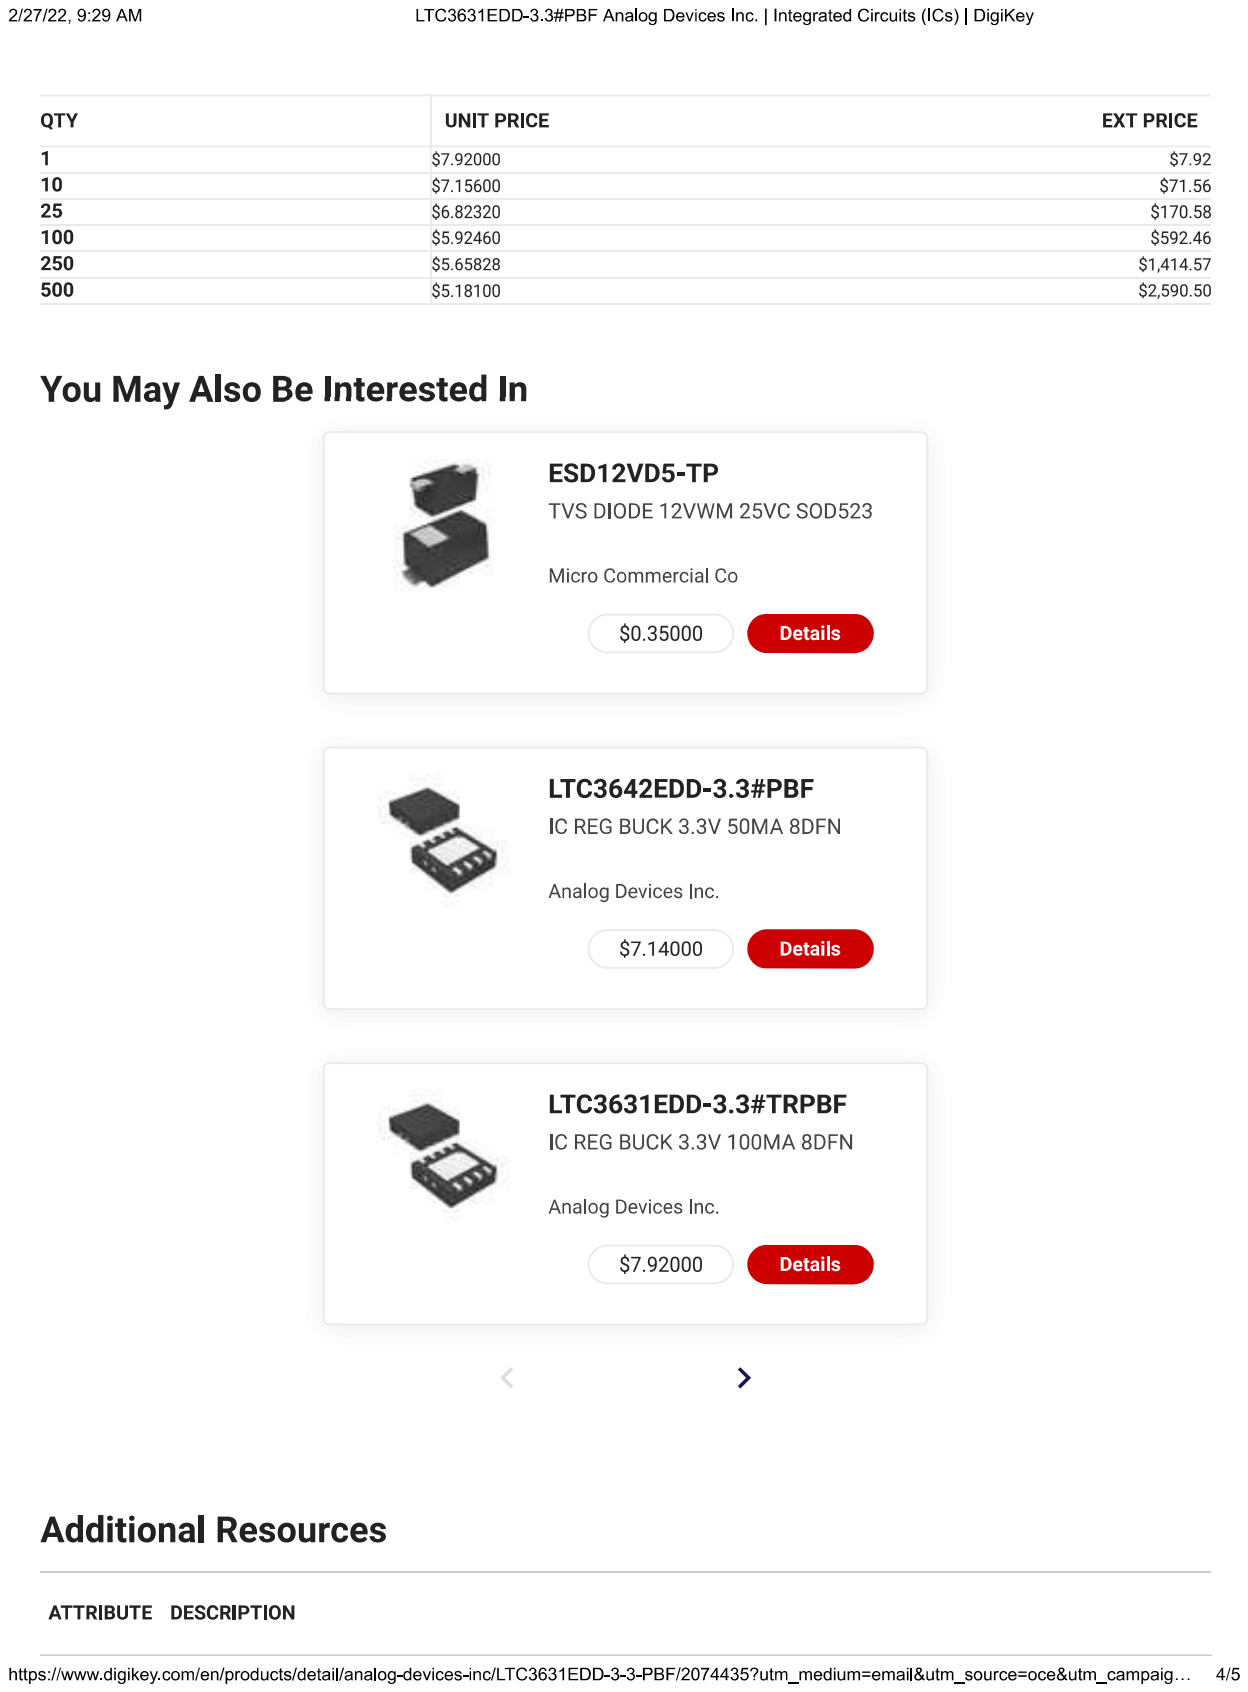
[picture p142: page 4]

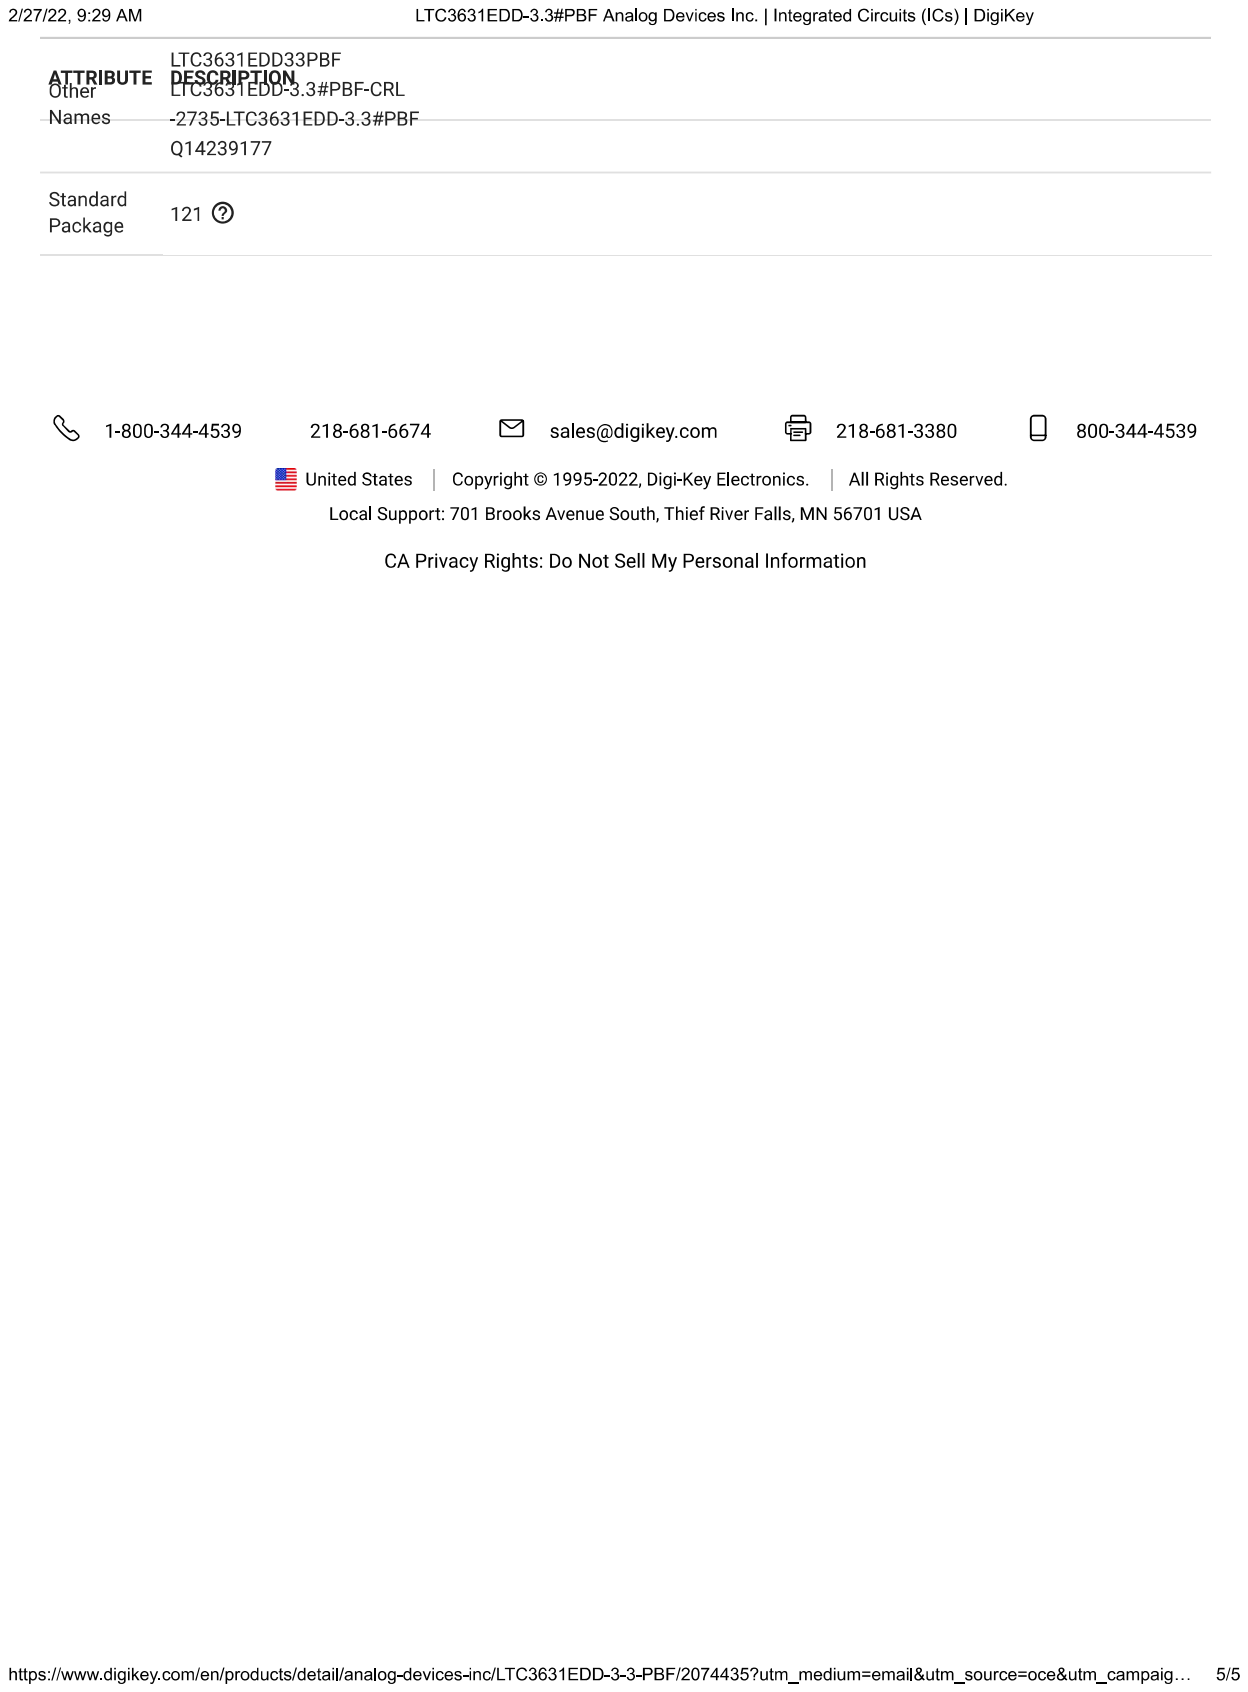
[picture p143: page 5]
