477-vrms/vrm-website/Files/docs/ZVN4106FTA-MOSFET.pdf

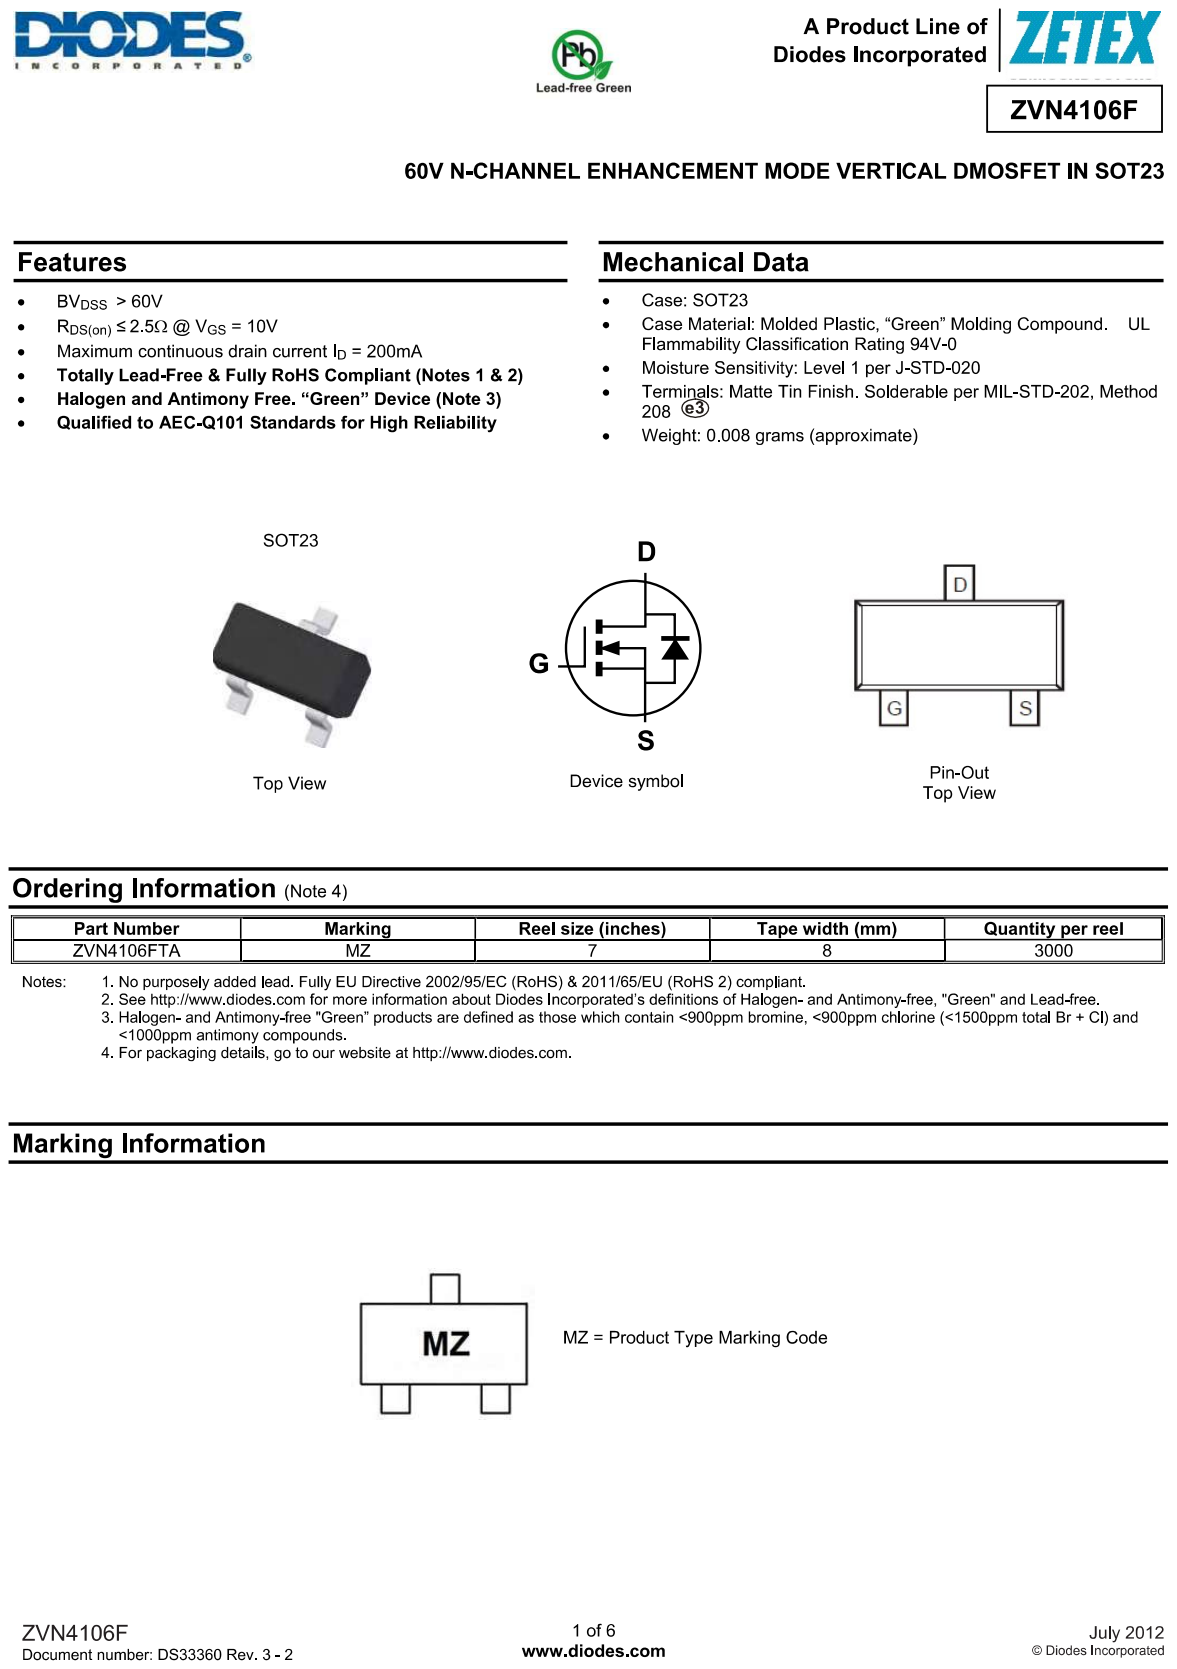
[picture p144: page 1]

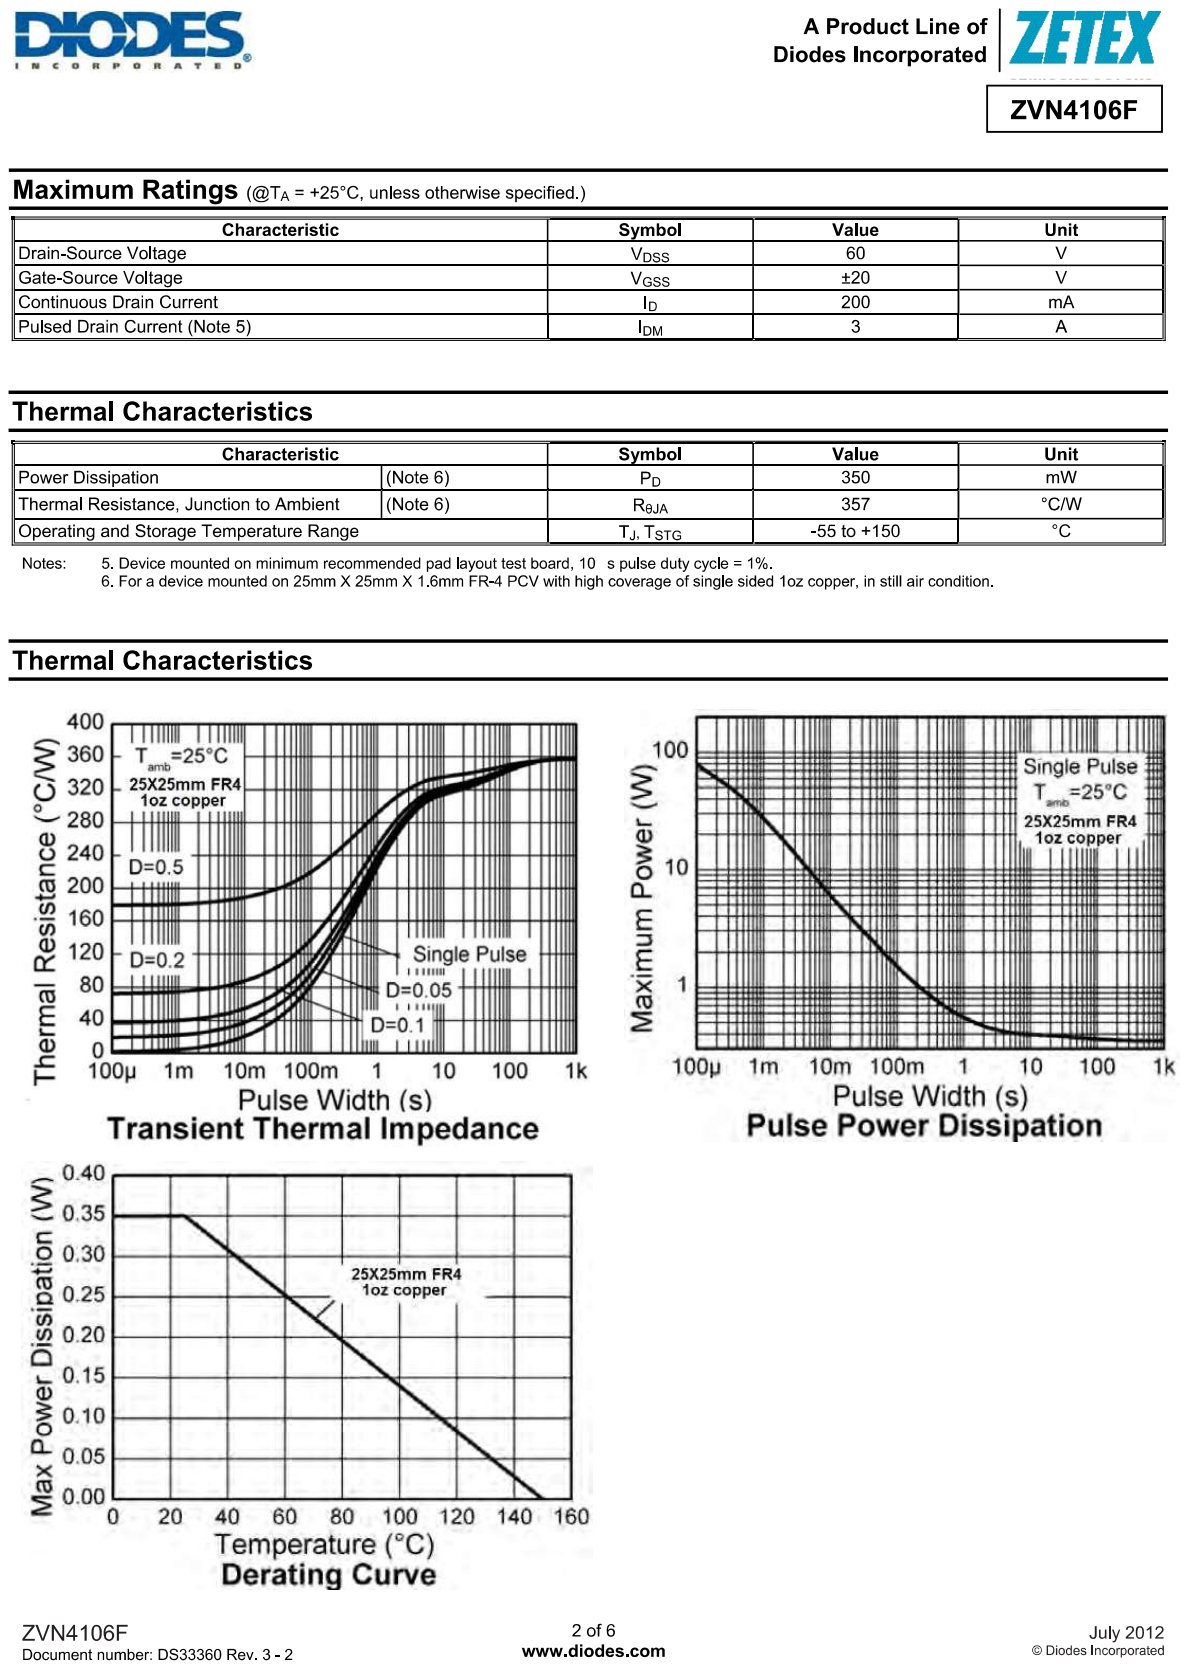
[picture p145: page 2]

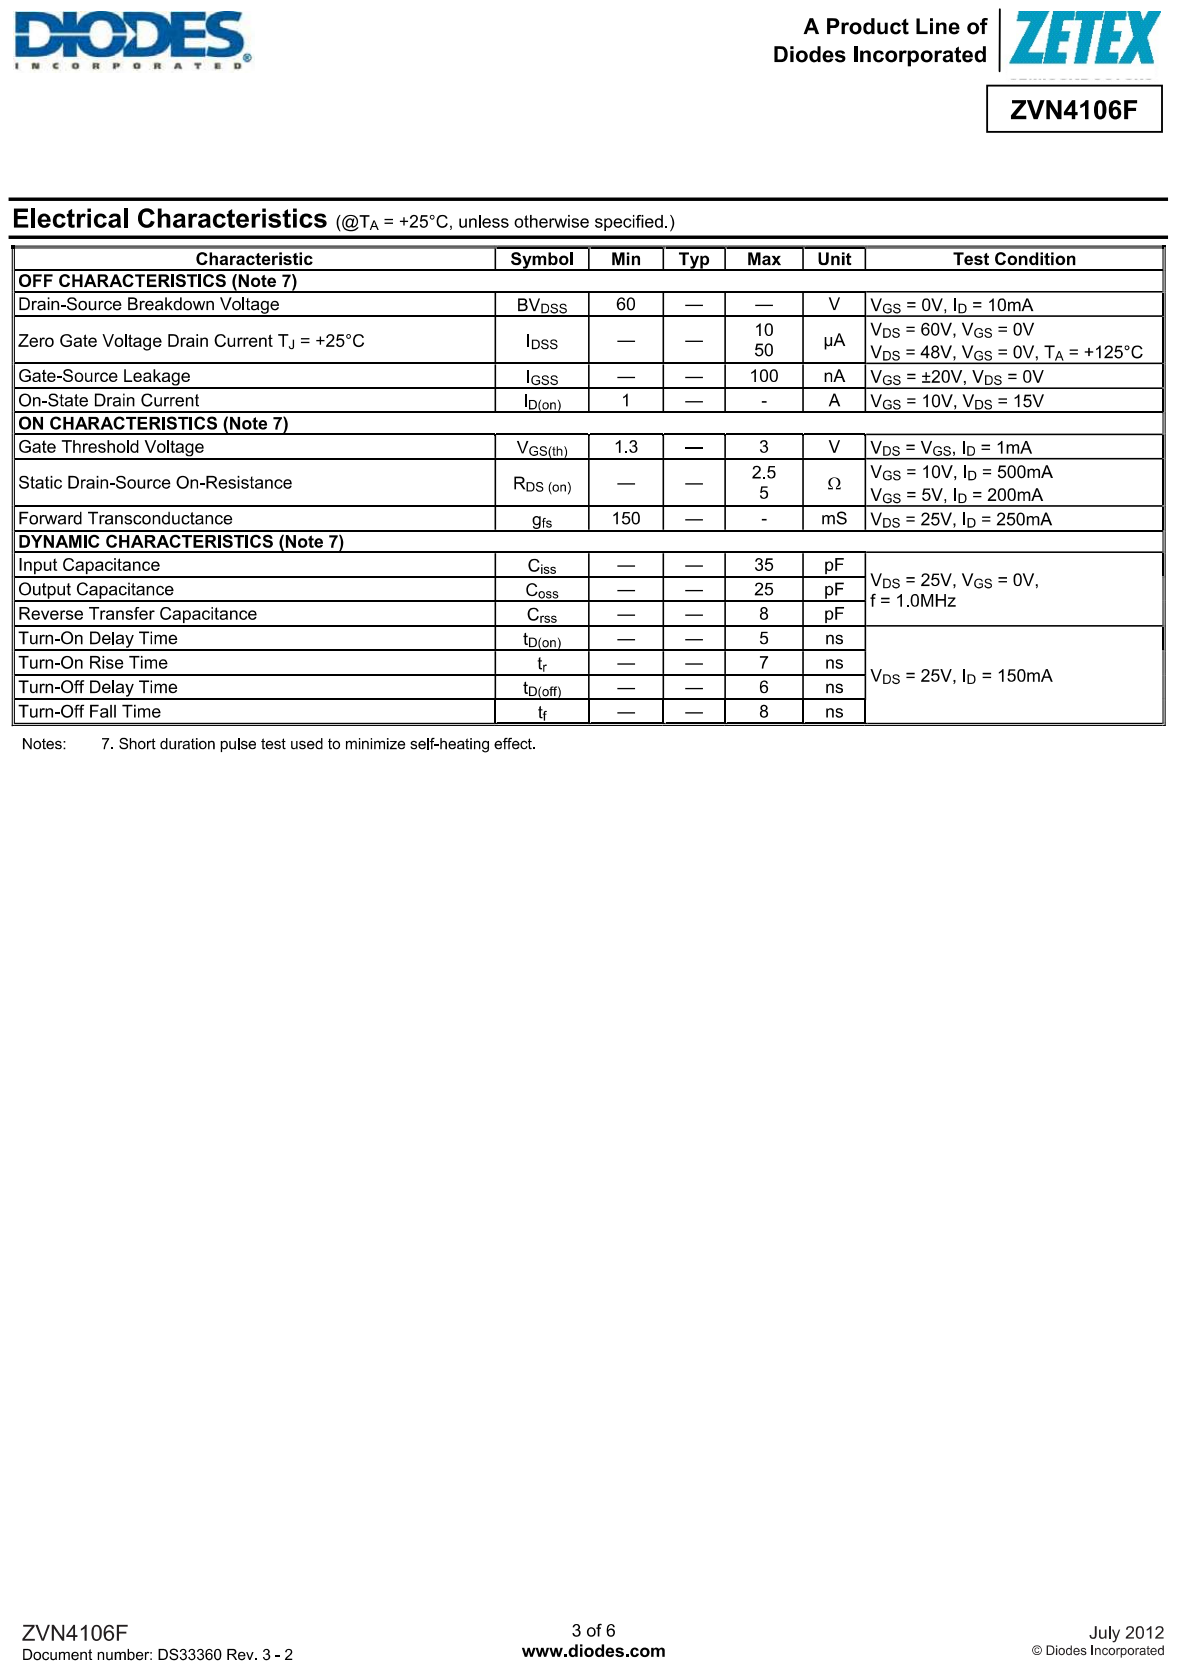
[picture p146: page 3]

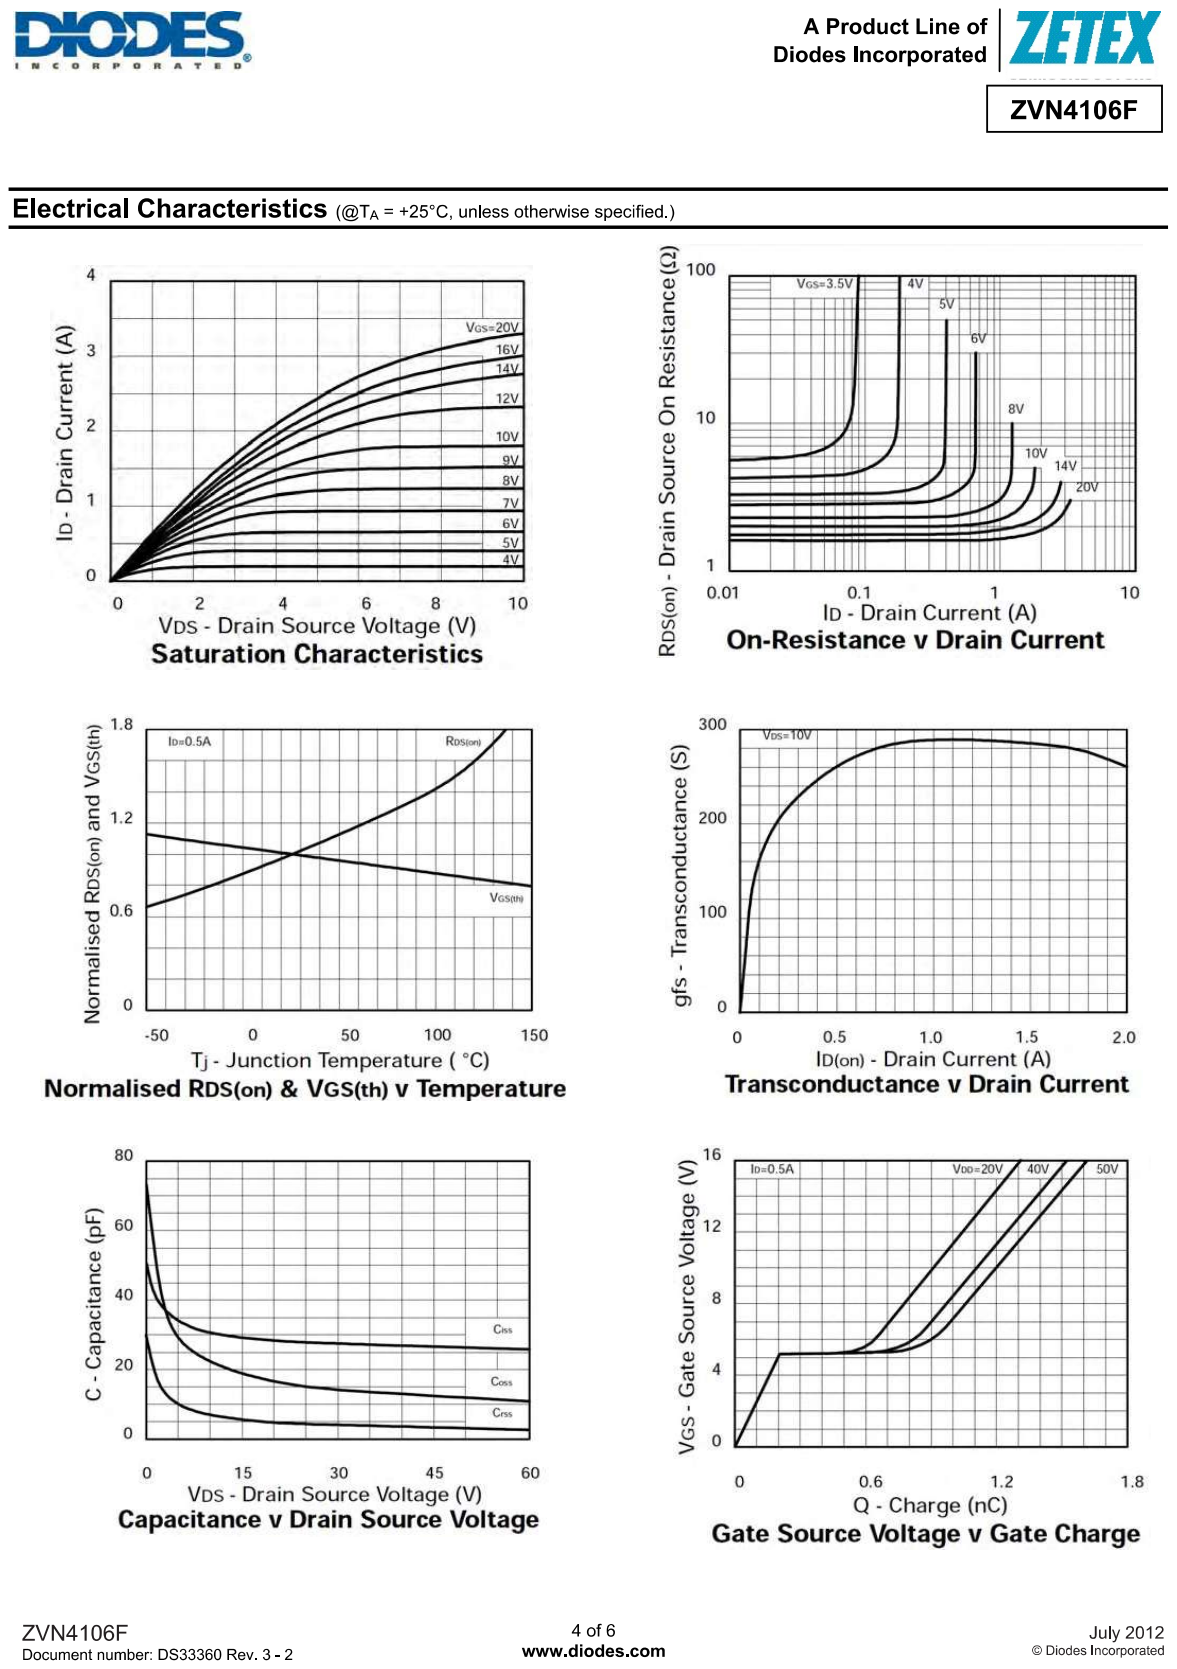
[picture p147: page 4]

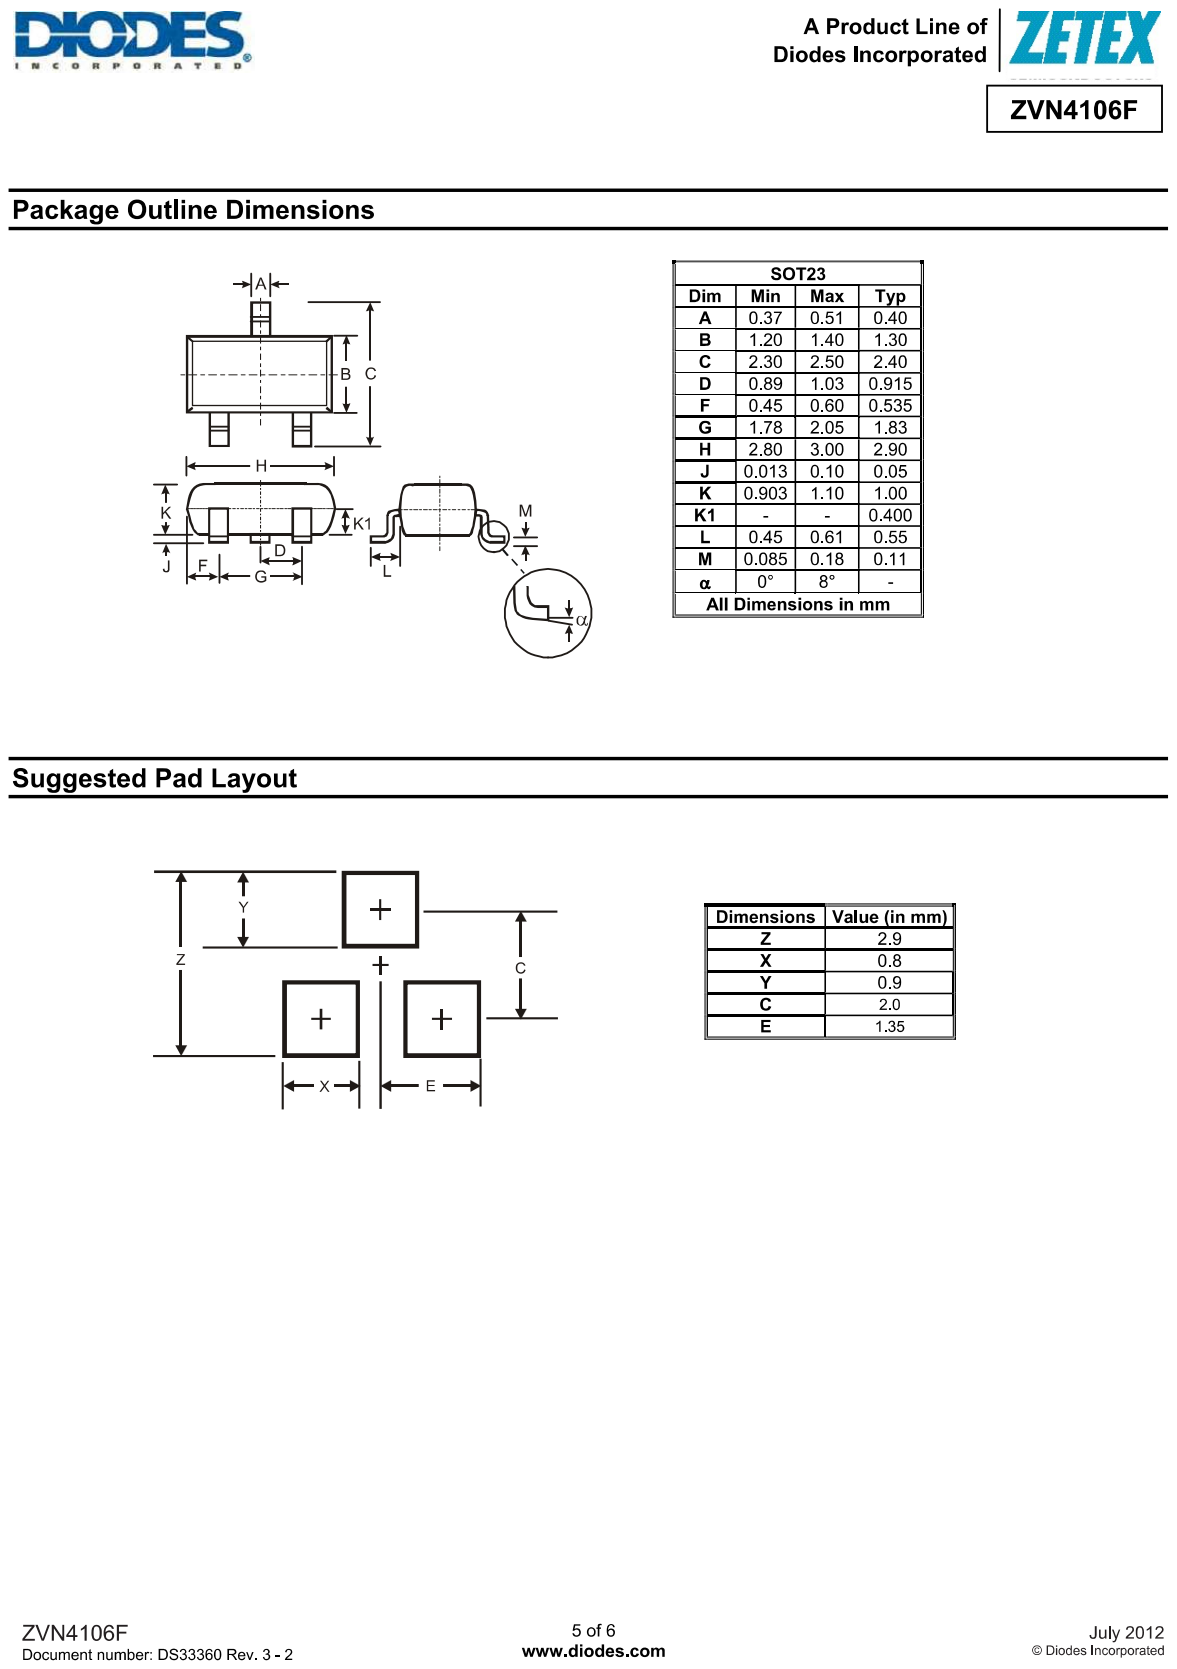
[picture p148: page 5]

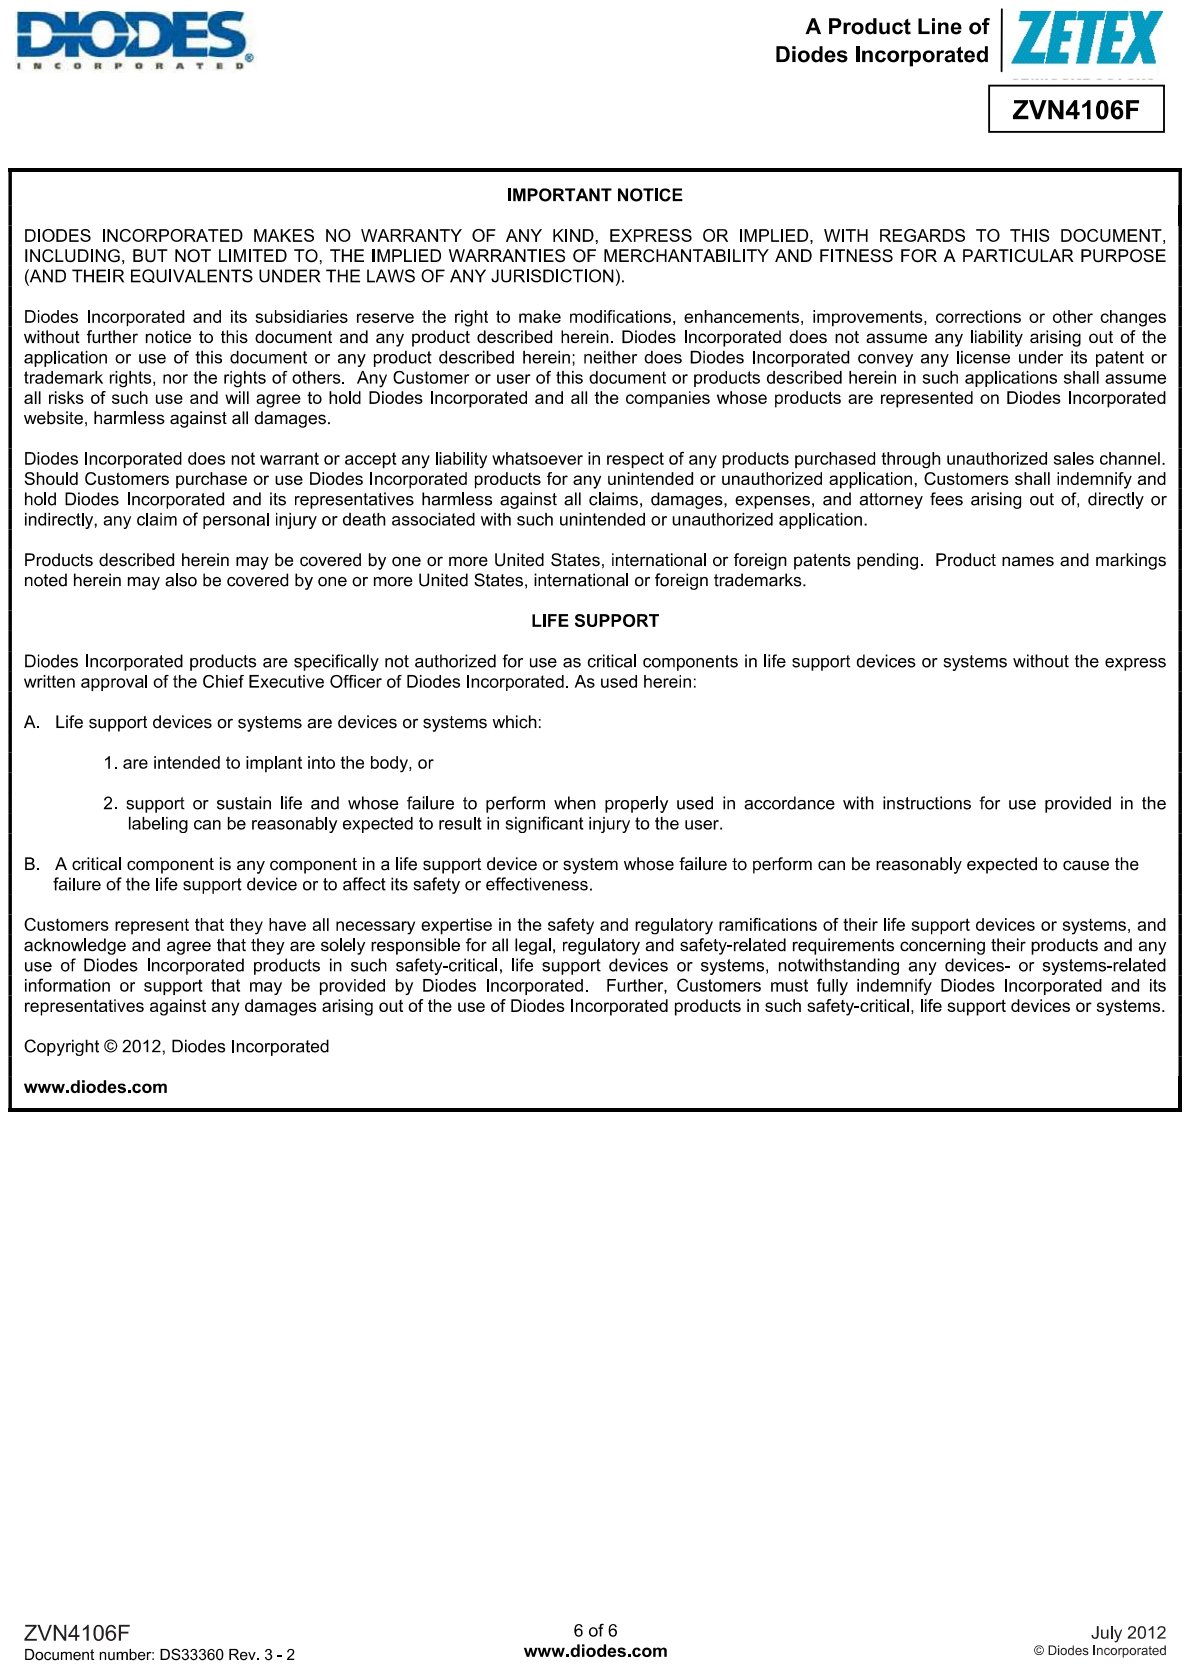
[picture p149: page 6]
