477-vrms/vrm-website/Files/docs/Vrm.kicad_pcb

## KiCad design Files/docs/Vrm.kicad_pcb (2022-03-03, last stored version)

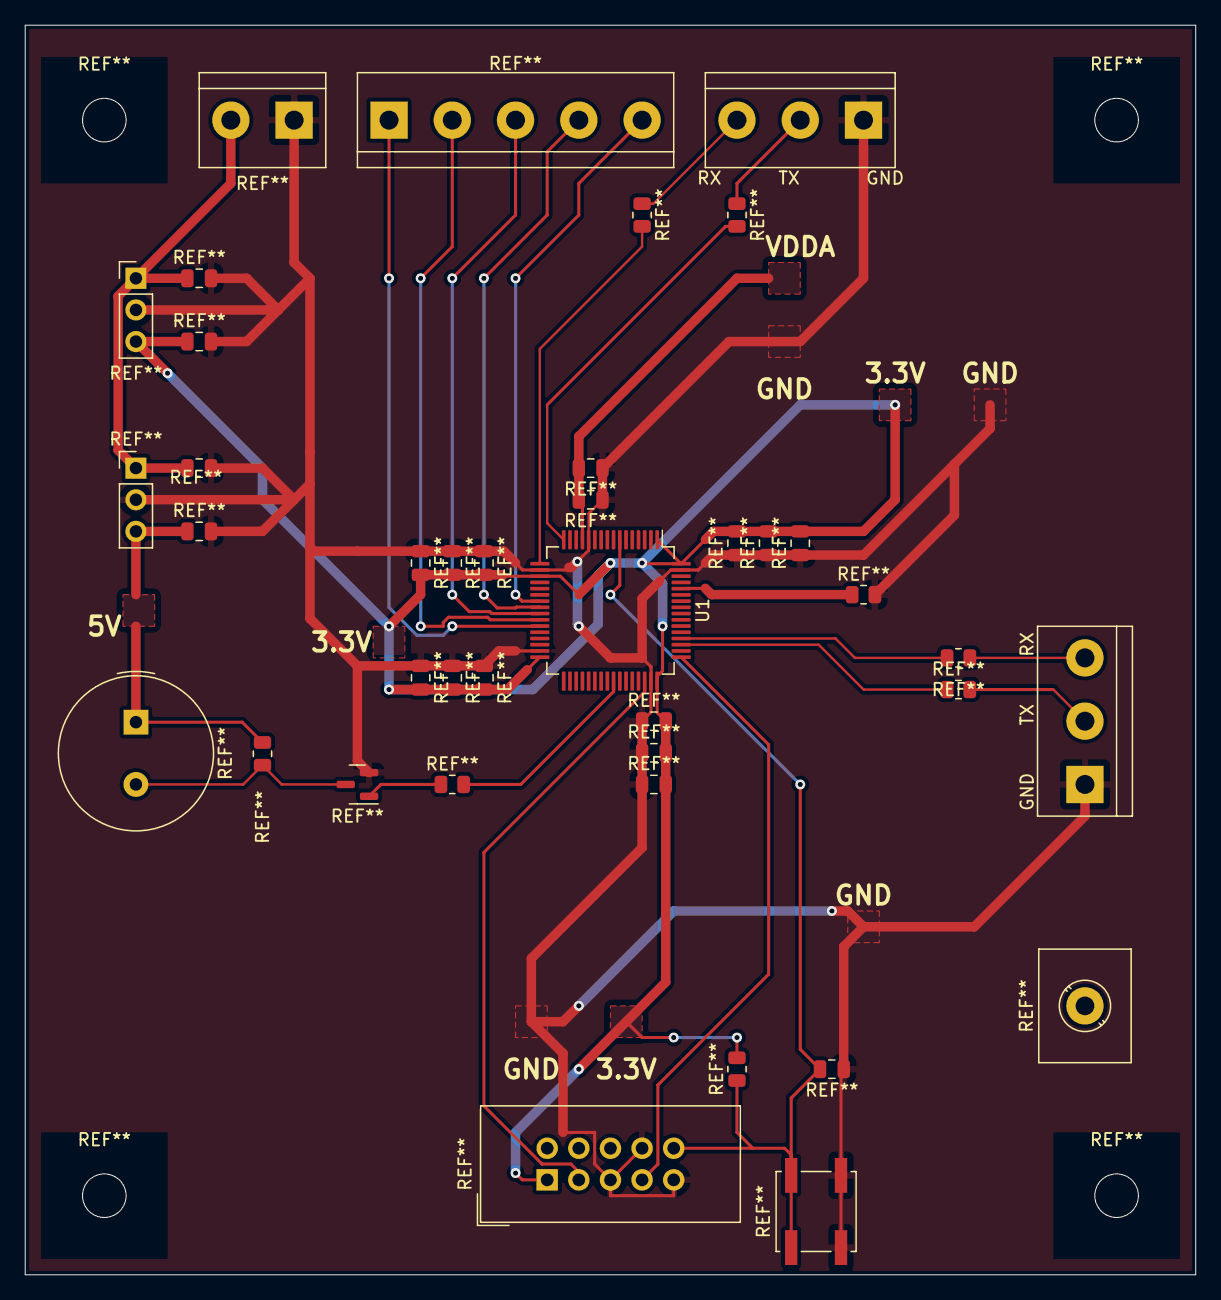
[picture p150: board Vrm.kicad_pcb from above]

Board: 2 copper layers, 94.0 x 100.3 mm, 3 parts (0 on the bottom side), 2 nets.

Parts:
   RX      TX       GND: PI UART; TerminalBlock_bornier-3_P5.08mm
GND     TX     RX: Servo UART; TerminalBlock_bornier-3_P5.08mm
U1: STM32F091RCTx; LQFP-64_10x10mm_P0.5mm

Connections:
GND: RX TX GND.1, GND TX RX.1, U1.12 (VSSA), U1.18 (VSS), U1.31 (VSS), U1.47 (VSS), U1.63 (VSS)
VDD: U1.1 (VBAT), U1.19 (VDD), U1.32 (VDD), U1.48 (VDDIO2), U1.64 (VDD)
