477-vrms/vrm-website/(commit log)

2022-02-05 Progress Report Week 4 (#9)
    * current progress report is up
    * All ready to go
2022-02-11 Matt Wen Progress Report (#10)
    * Finished Progress Report
    * put wen101 instead of progress3
    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
2022-02-17 Week 6
    [6_BillOfMaterials.xlsx]
2022-03-02 Added KiCad files to docs
    [Vrm.kicad_pcb, Vrm.kicad_sch]
2022-03-11 Added updated PCB files to docs
    [Vrm.kicad_pcb, Vrm.kicad_sch]
2022-04-08 Matthewwen progress (#18)
    * current progress as of tuesday
    * Finished
